al-nafisah/wireless-seismic-daq/analysis/figures/full-chain-nyquist.jpg

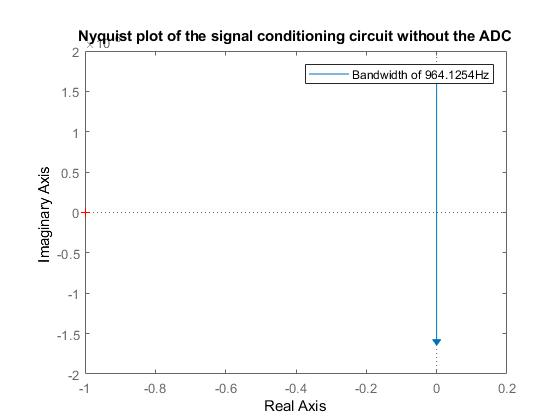
analysis/figures/full-chain-nyquist.jpg
