al-nafisah/wireless-seismic-daq/analysis/figures/hpf-nyquist.jpg

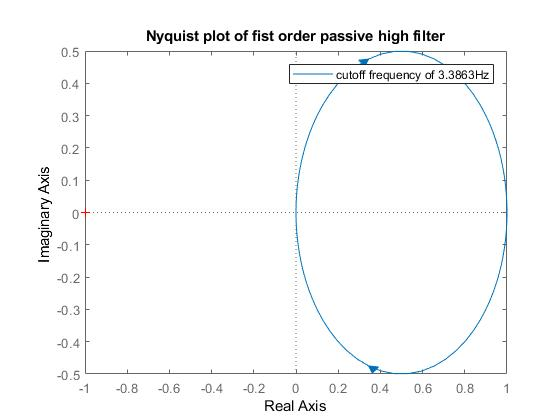
analysis/figures/hpf-nyquist.jpg
