al-nafisah/wireless-seismic-daq/analysis/figures/lpf-bode.jpg

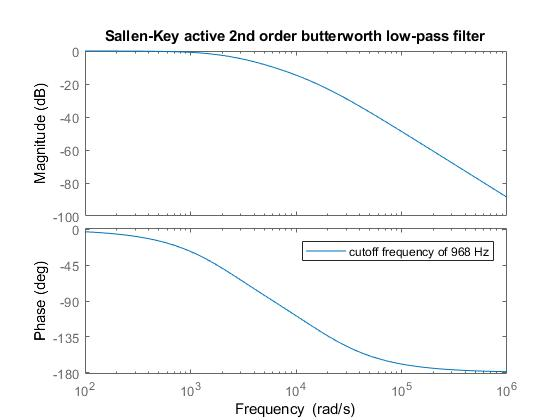
analysis/figures/lpf-bode.jpg
