al-nafisah/wireless-seismic-daq/analysis/figures/lpf-nyquist.jpg

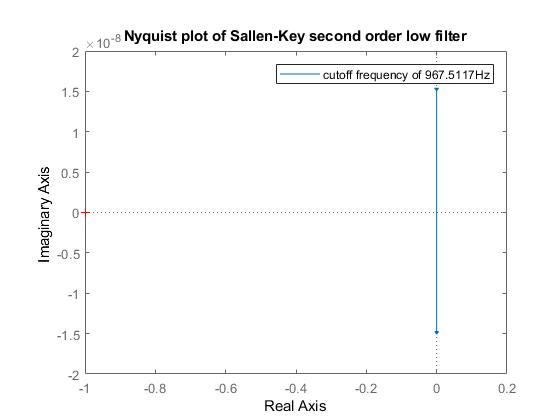
analysis/figures/lpf-nyquist.jpg
