al-nafisah/wireless-seismic-daq/data/hammer-shots/figures/shot1.png

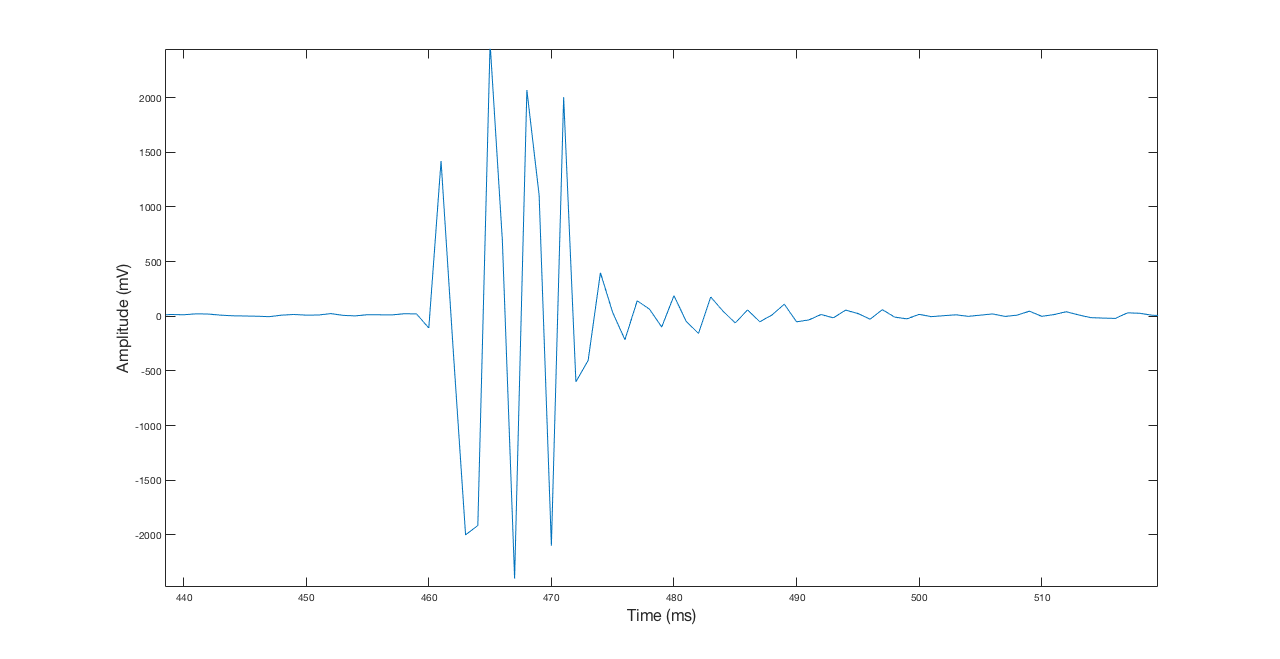
data/hammer-shots/figures/shot1.png
