al-nafisah/wireless-seismic-daq/data/hammer-shots/figures/shot3.png

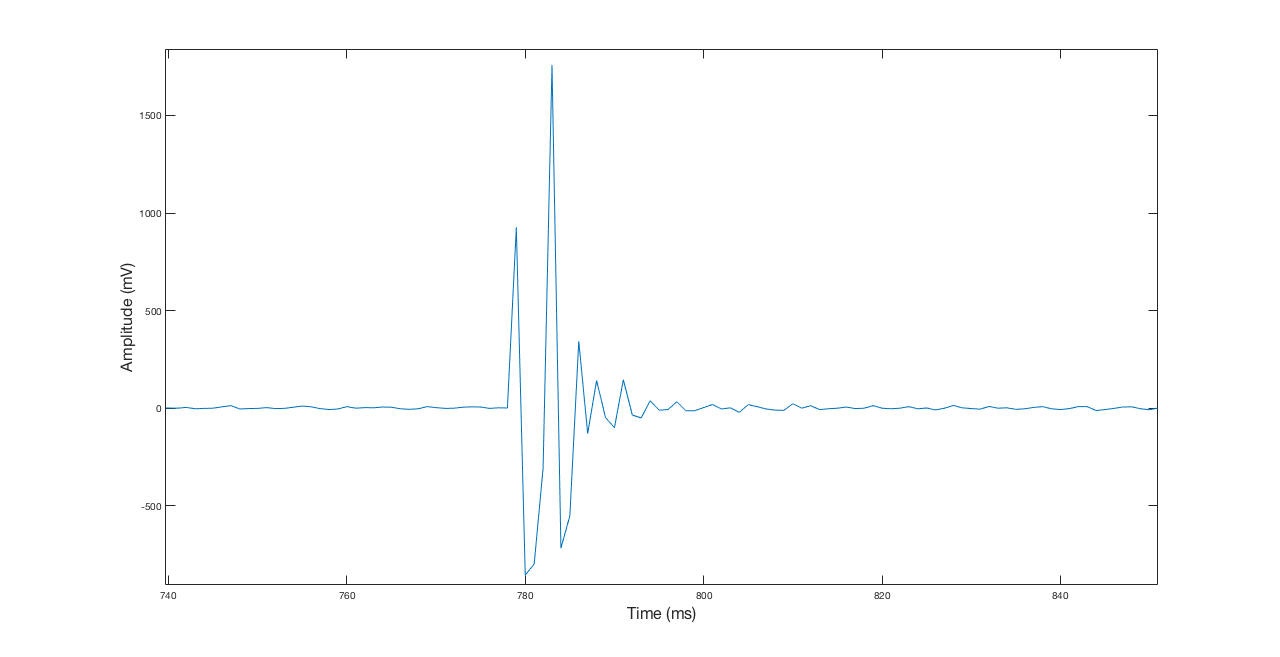
data/hammer-shots/figures/shot3.png
