al-nafisah/wireless-seismic-daq/data/hammer-shots/figures/shot4.png

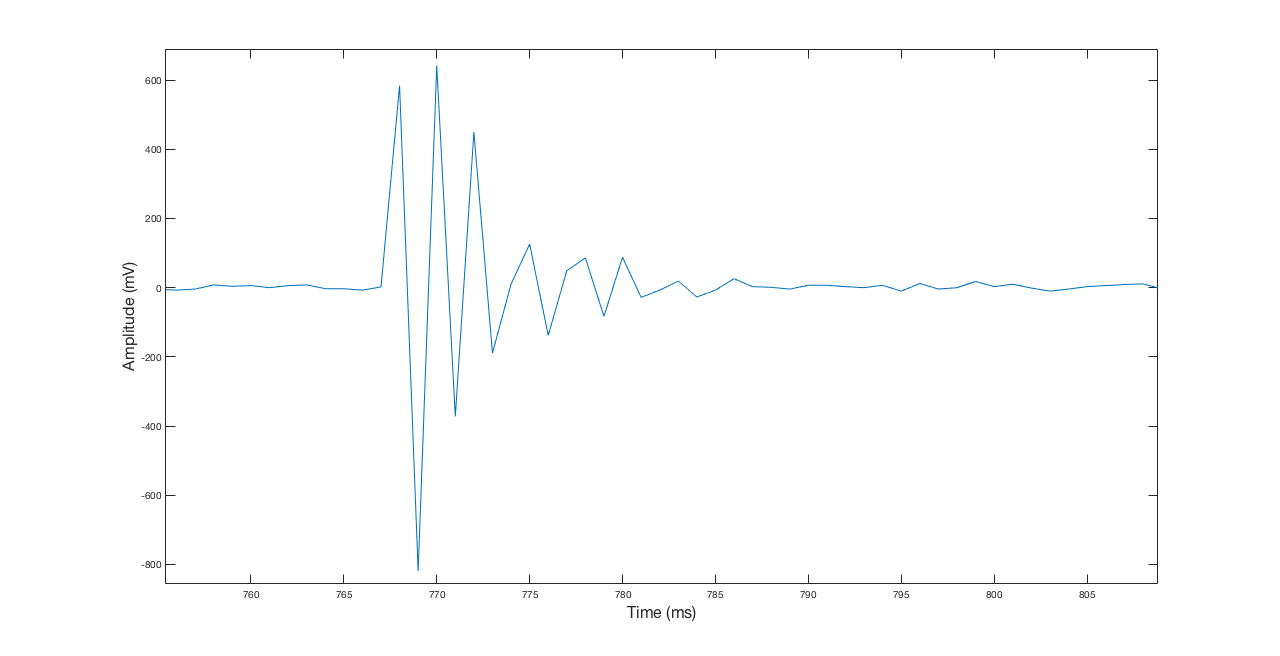
data/hammer-shots/figures/shot4.png
