al-nafisah/wireless-seismic-daq/data/hammer-shots/figures/shot6.png

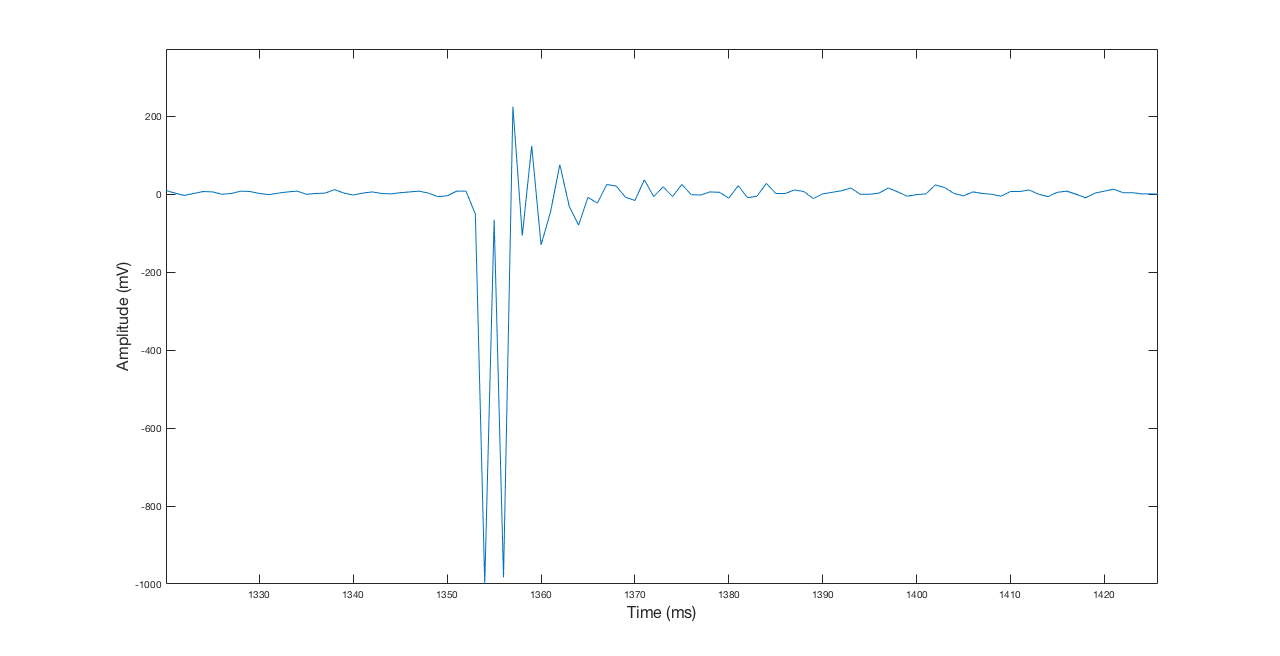
data/hammer-shots/figures/shot6.png
