al-nafisah/wireless-seismic-daq/data/hammer-shots/figures/shot8.png

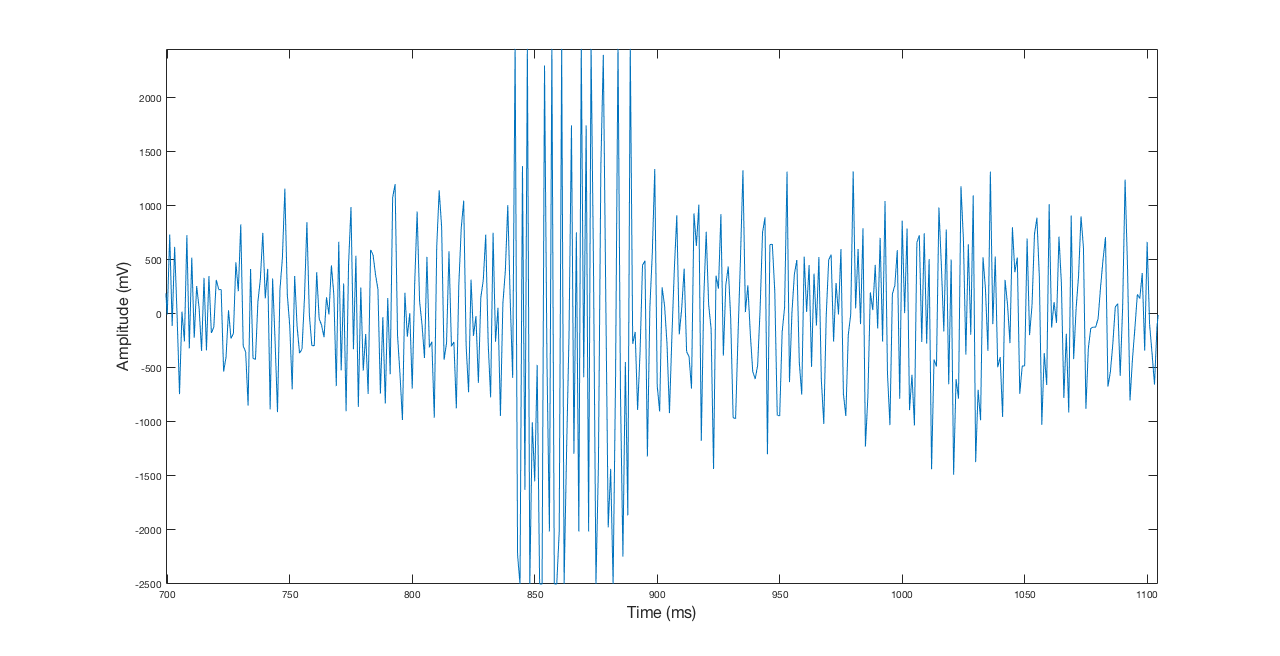
data/hammer-shots/figures/shot8.png
