al-nafisah/wireless-seismic-daq/data/hammer-shots/figures/shot9.png

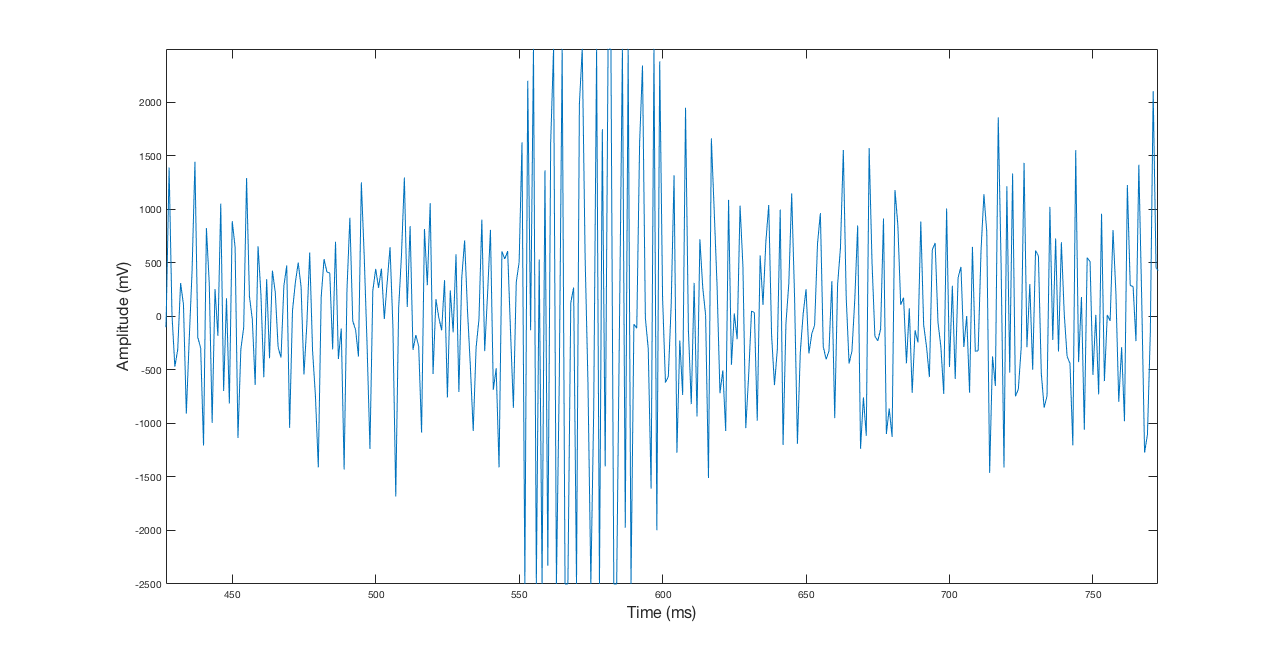
data/hammer-shots/figures/shot9.png
