al-nafisah/wireless-seismic-daq/data/hammer-shots/reference/54.jpg

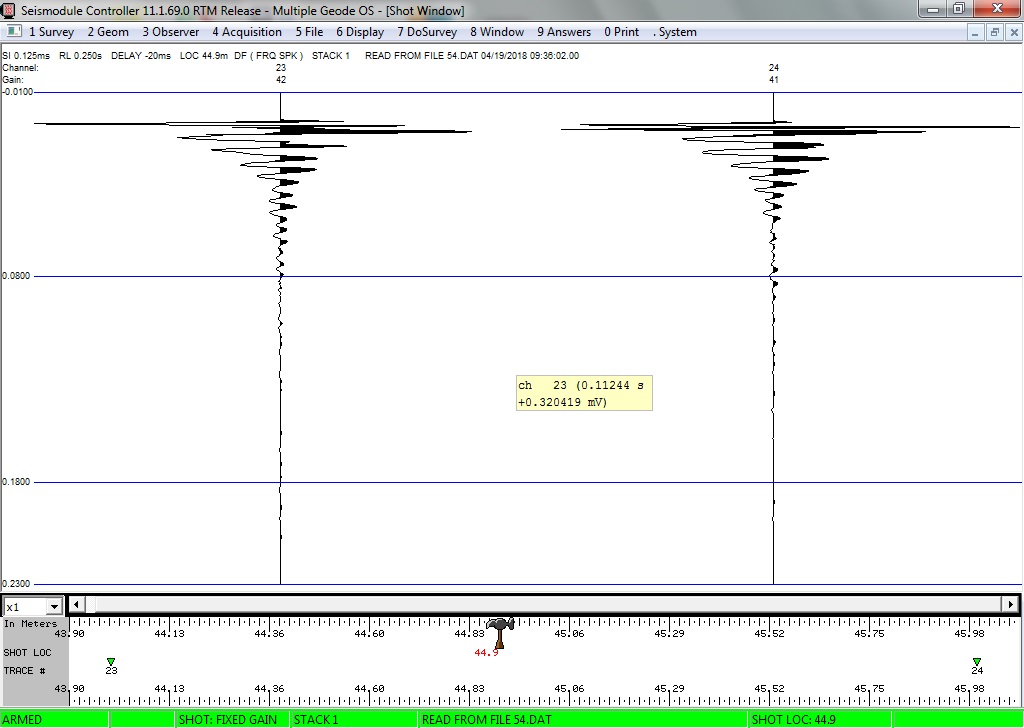
data/hammer-shots/reference/54.jpg
