al-nafisah/wireless-seismic-daq/data/hammer-shots/reference/55.jpg

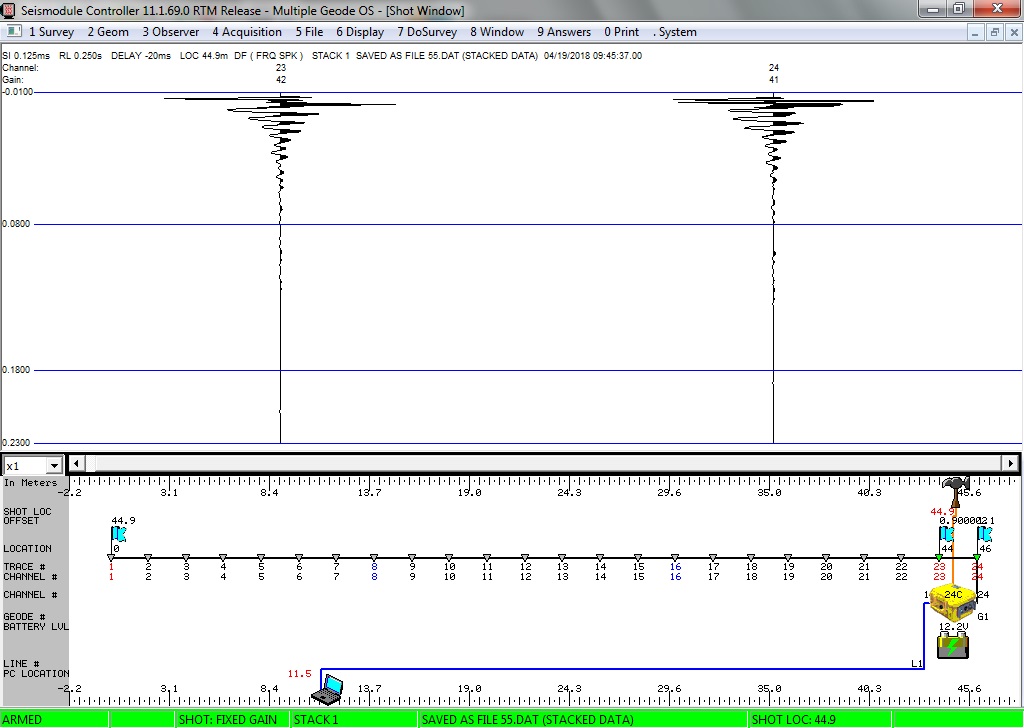
data/hammer-shots/reference/55.jpg
