al-nafisah/wireless-seismic-daq/data/hammer-shots/reference/62.jpg

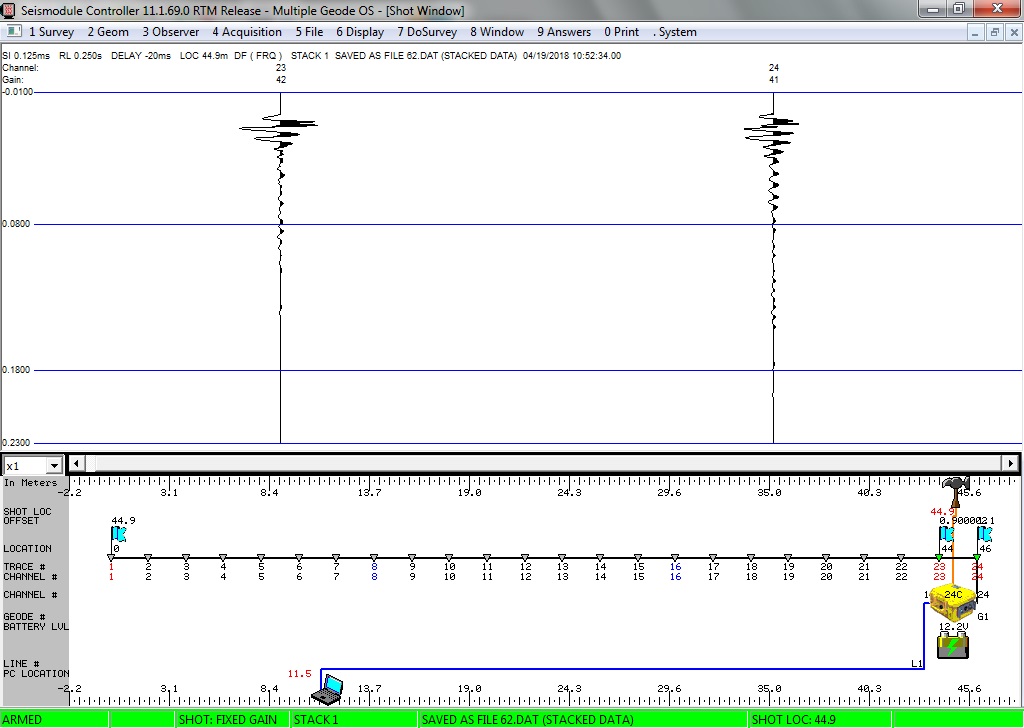
data/hammer-shots/reference/62.jpg
