al-nafisah/wireless-seismic-daq/data/sensor-impulse/geophone.png

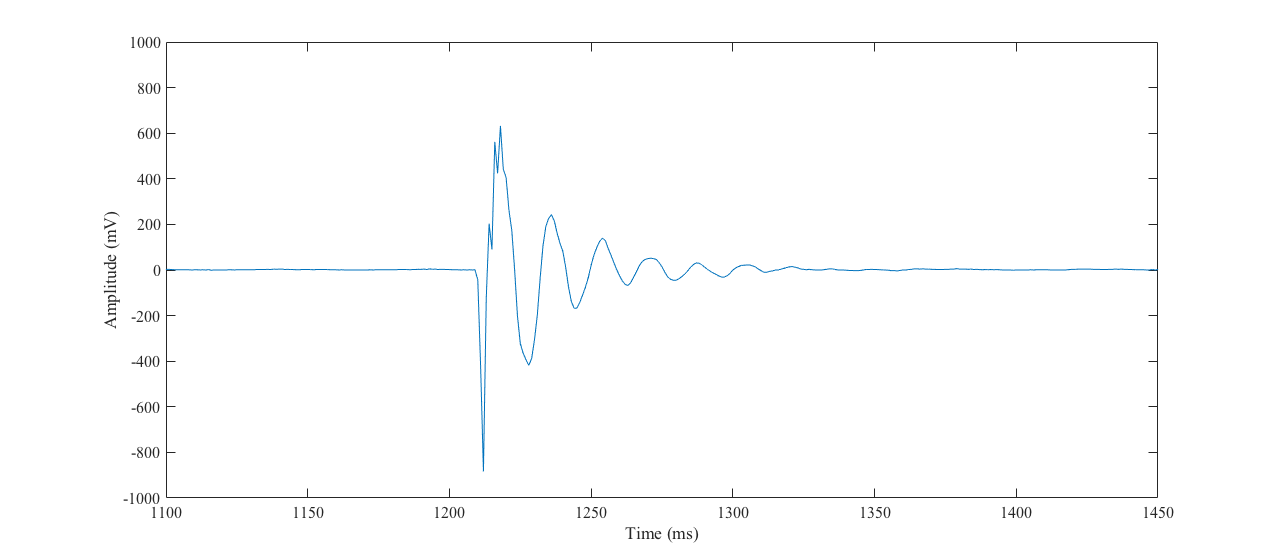
data/sensor-impulse/geophone.png
