al-nafisah/wireless-seismic-daq/data/sensor-impulse/piezo.png

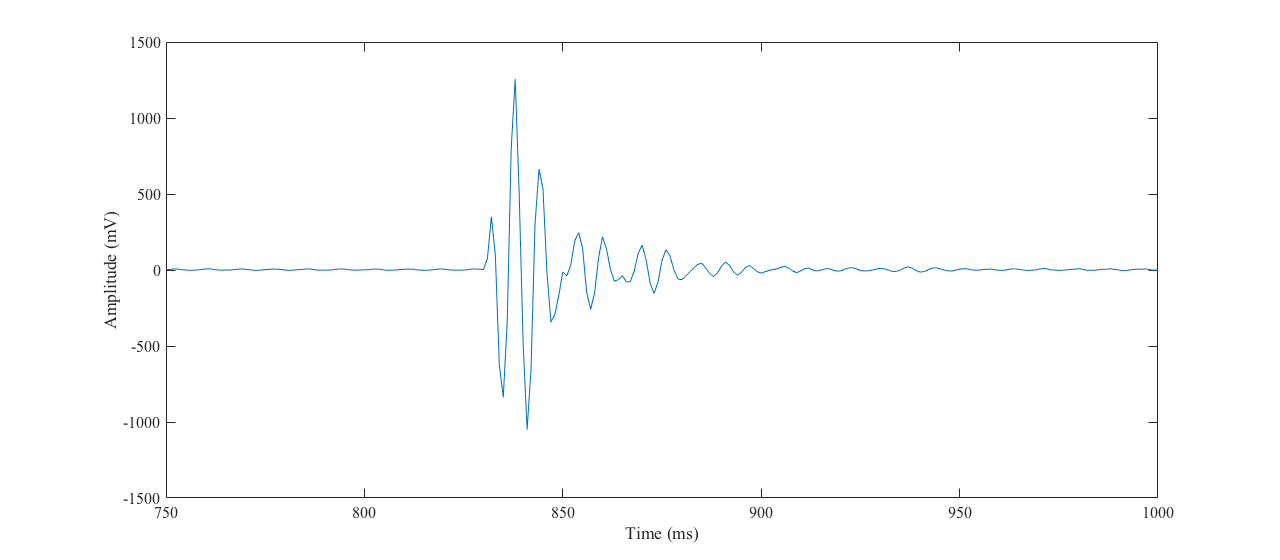
data/sensor-impulse/piezo.png
