al-nafisah/wireless-seismic-daq/hardware/adc-connections.png

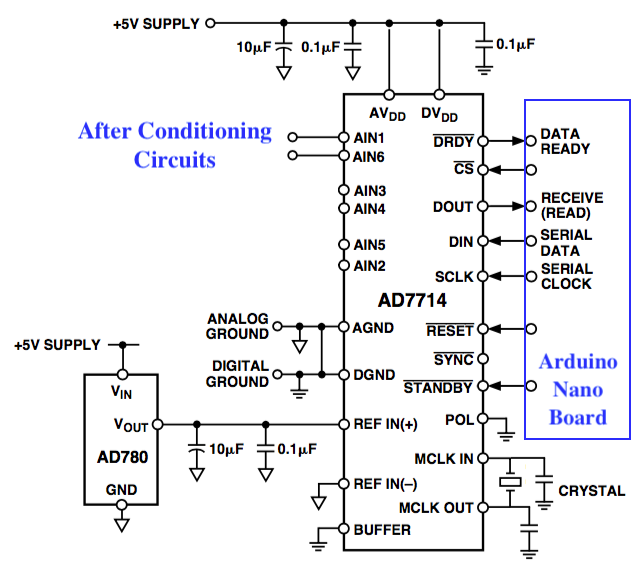
hardware/adc-connections.png
