al-nafisah/wireless-seismic-daq/hardware/pcb/layout-bottom.jpg

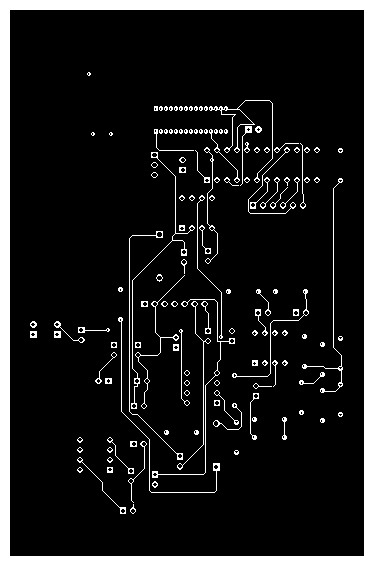
hardware/pcb/layout-bottom.jpg
