al-nafisah/wireless-seismic-daq/hardware/pcb/layout-top.jpg

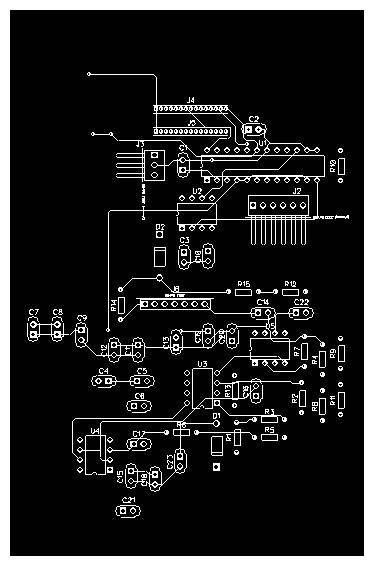
hardware/pcb/layout-top.jpg
