al-nafisah/wireless-seismic-daq/hardware/pcb/power-supply.jpg

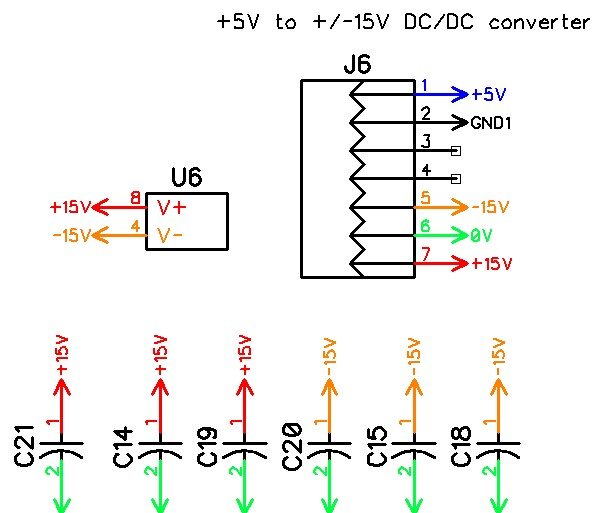
hardware/pcb/power-supply.jpg
