al-nafisah/wireless-seismic-daq/hardware/pcb/schematic.jpg

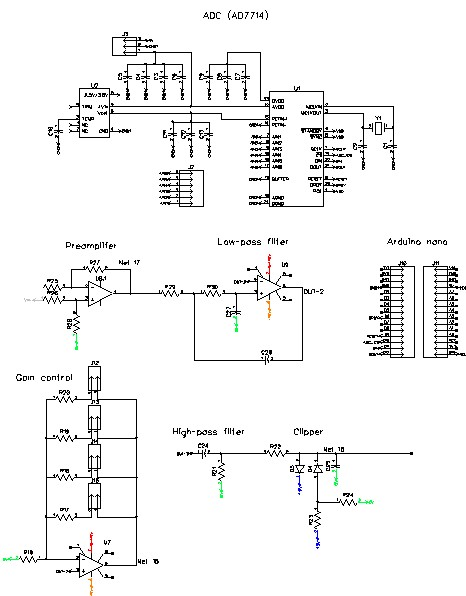
hardware/pcb/schematic.jpg
