al-nafisah/wireless-seismic-daq/hardware/signal-conditioning/stages.png

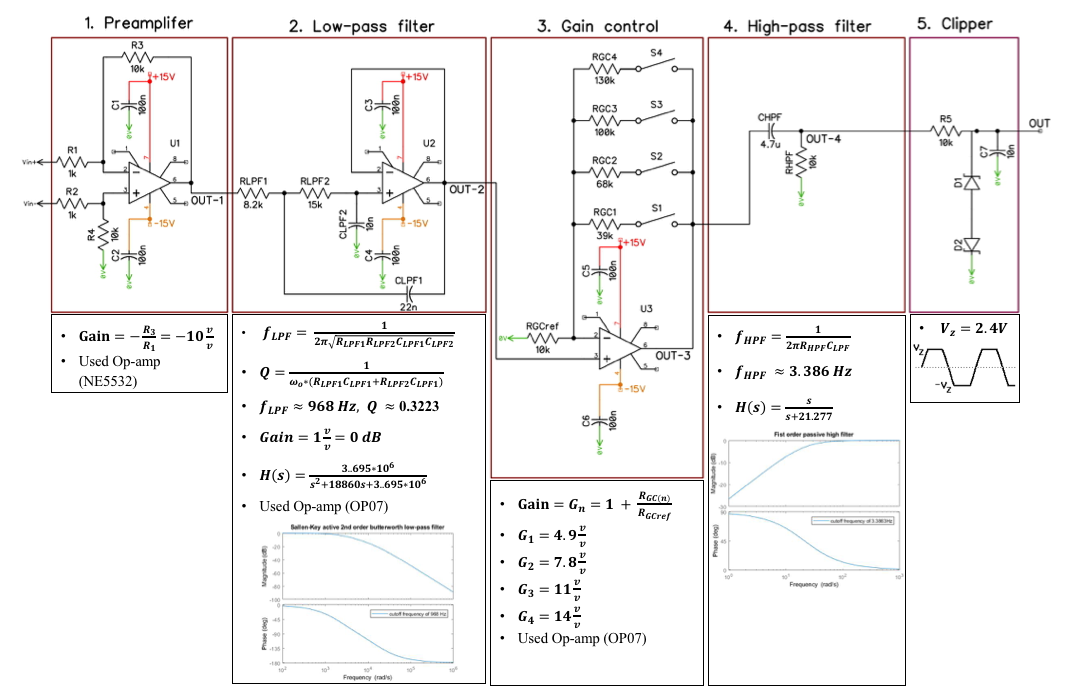
hardware/signal-conditioning/stages.png
