al-nafisah/wireless-seismic-daq/media/photos/award-1.jpg

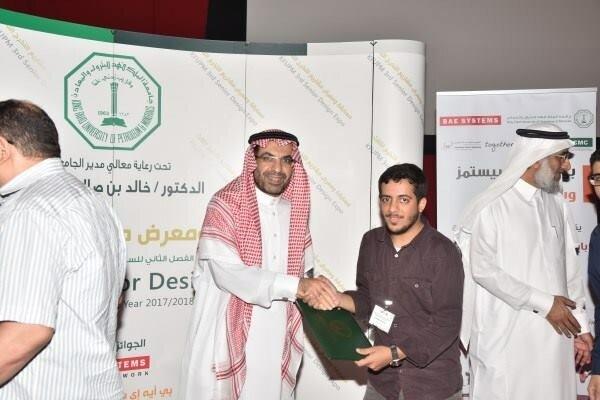
media/photos/award-1.jpg
