al-nafisah/wireless-seismic-daq/media/photos/award-2.jpg

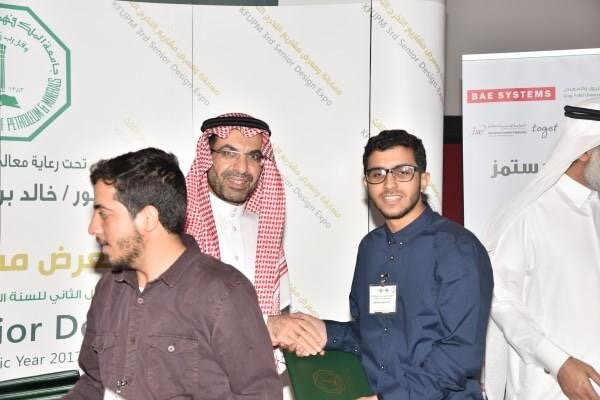
media/photos/award-2.jpg
