al-nafisah/wireless-seismic-daq/media/photos/award-3.jpg

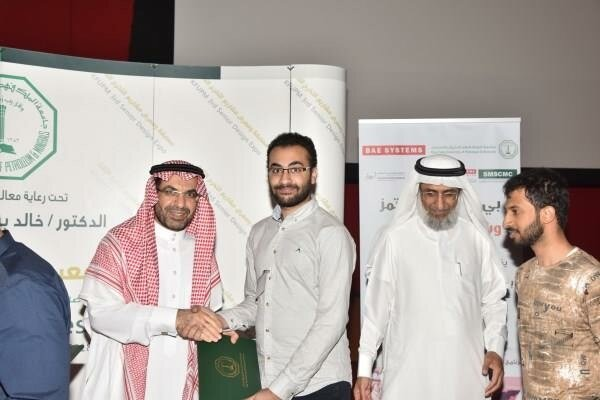
media/photos/award-3.jpg
