al-nafisah/wireless-seismic-daq/media/photos/award-4.jpg

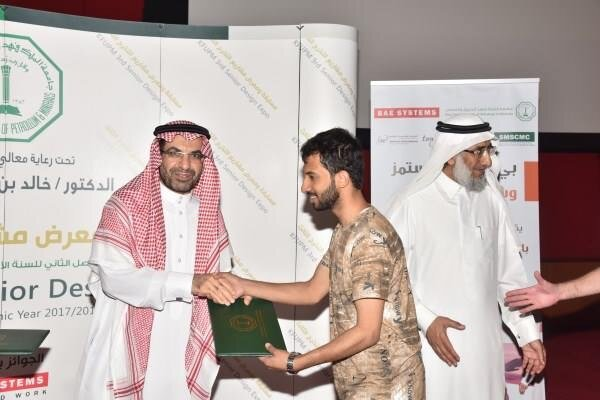
media/photos/award-4.jpg
