al-nafisah/wireless-seismic-daq/media/photos/award-5.jpg

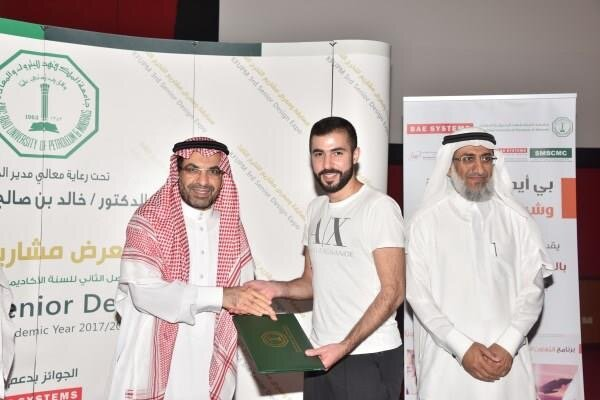
media/photos/award-5.jpg
