al-nafisah/wireless-seismic-daq/media/photos/award-6.jpg

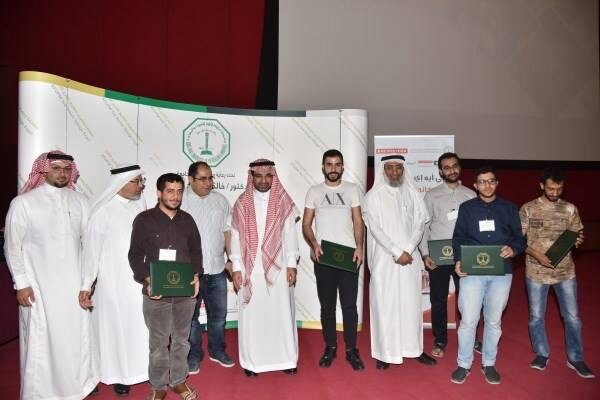
media/photos/award-6.jpg
