al-nafisah/wireless-seismic-daq/media/photos/award-7.jpg

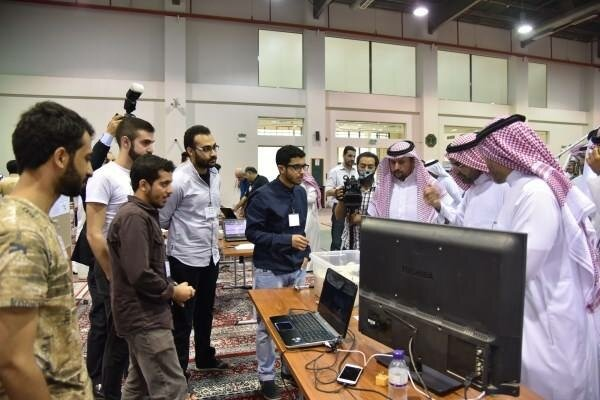
media/photos/award-7.jpg
