al-nafisah/wireless-seismic-daq/media/photos/prototype.jpg

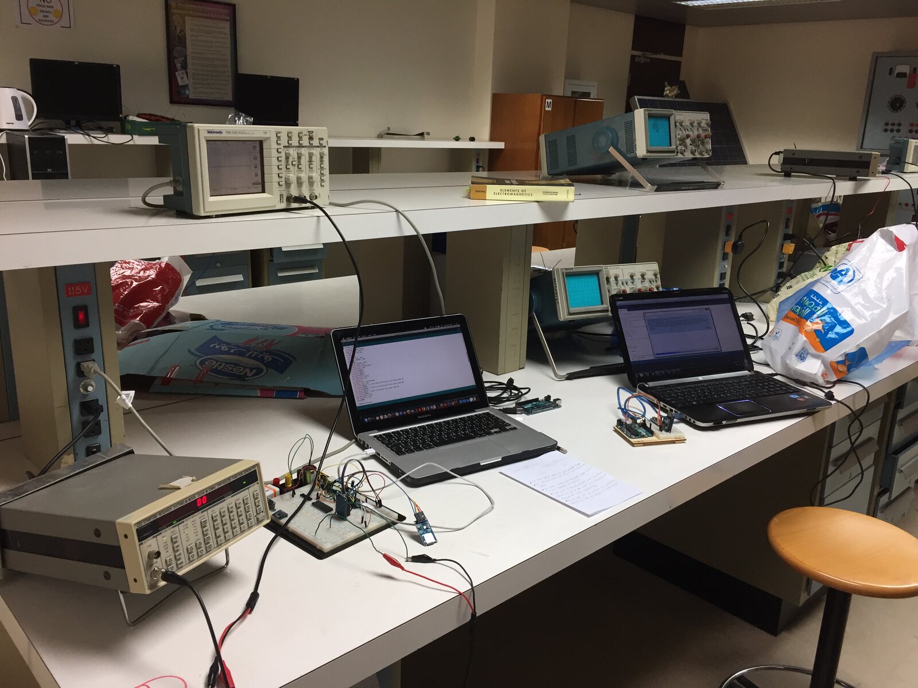
media/photos/prototype.jpg
