al-nafisah/wireless-seismic-daq/hardware/bench-measurements/low-battery/clipper.jpg

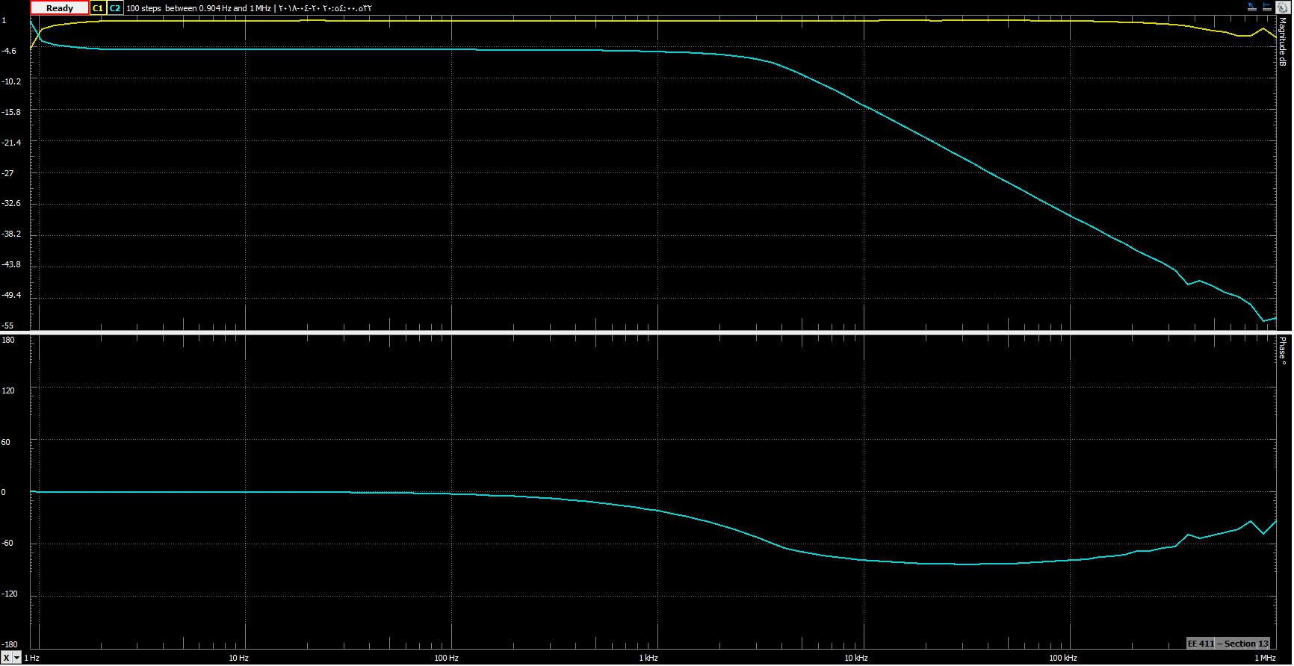
hardware/bench-measurements/low-battery/clipper.jpg
