al-nafisah/wireless-seismic-daq/hardware/bench-measurements/low-battery/full-chain.jpg

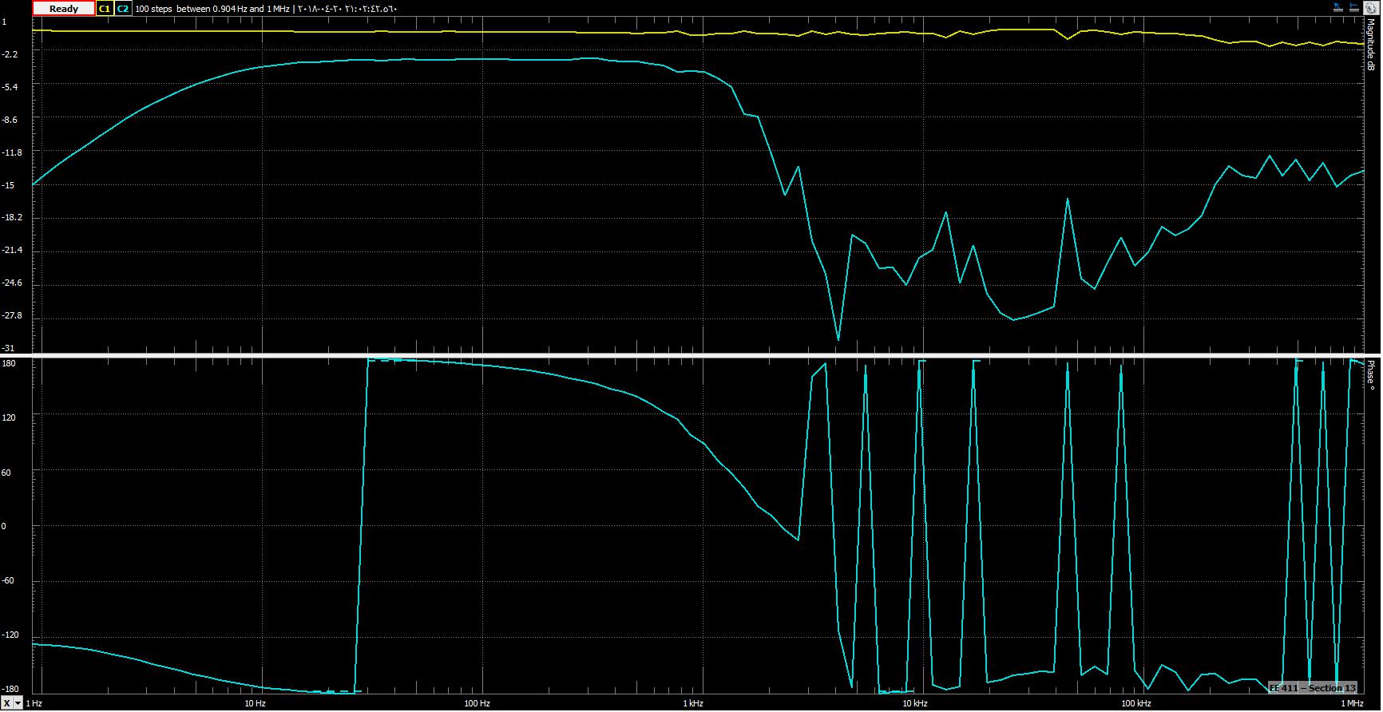
hardware/bench-measurements/low-battery/full-chain.jpg
