al-nafisah/wireless-seismic-daq/hardware/bench-measurements/low-battery/gain-control-1m.jpg

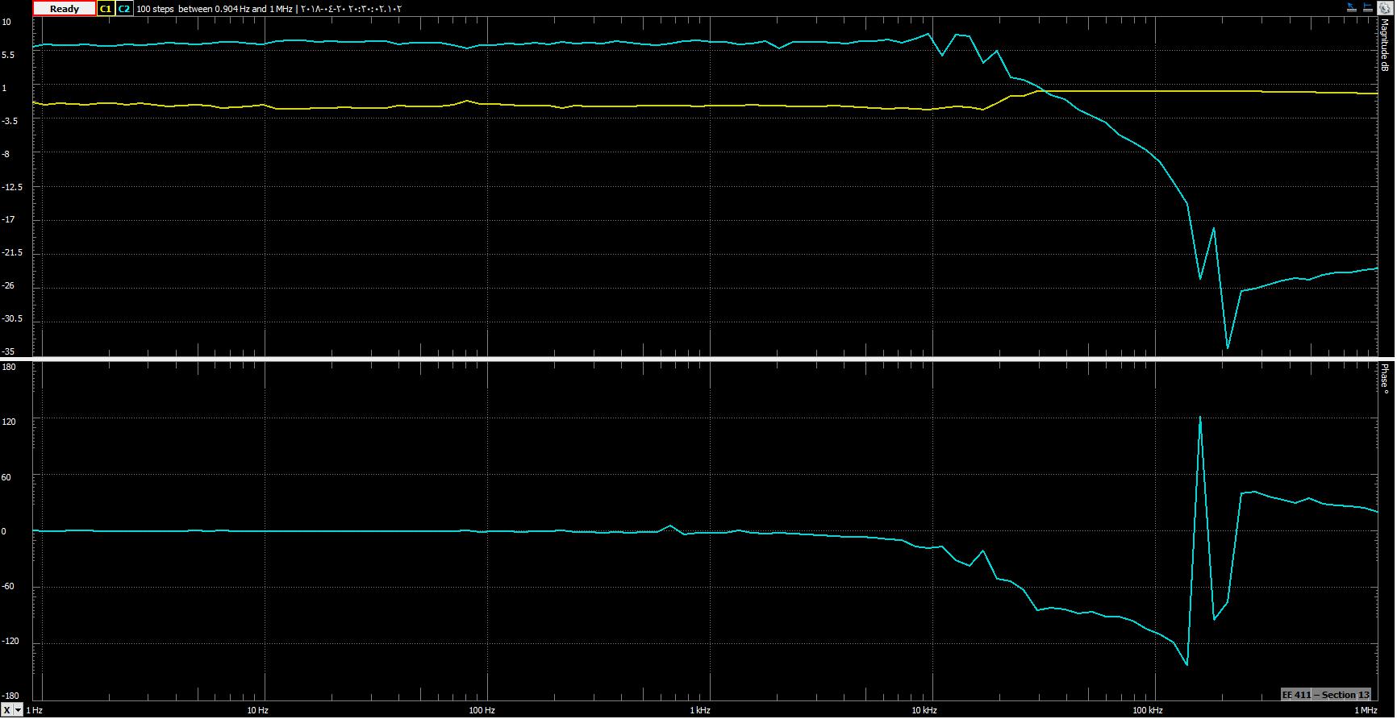
hardware/bench-measurements/low-battery/gain-control-1m.jpg
