al-nafisah/wireless-seismic-daq/hardware/bench-measurements/low-battery/gain-control-2.2m.jpg

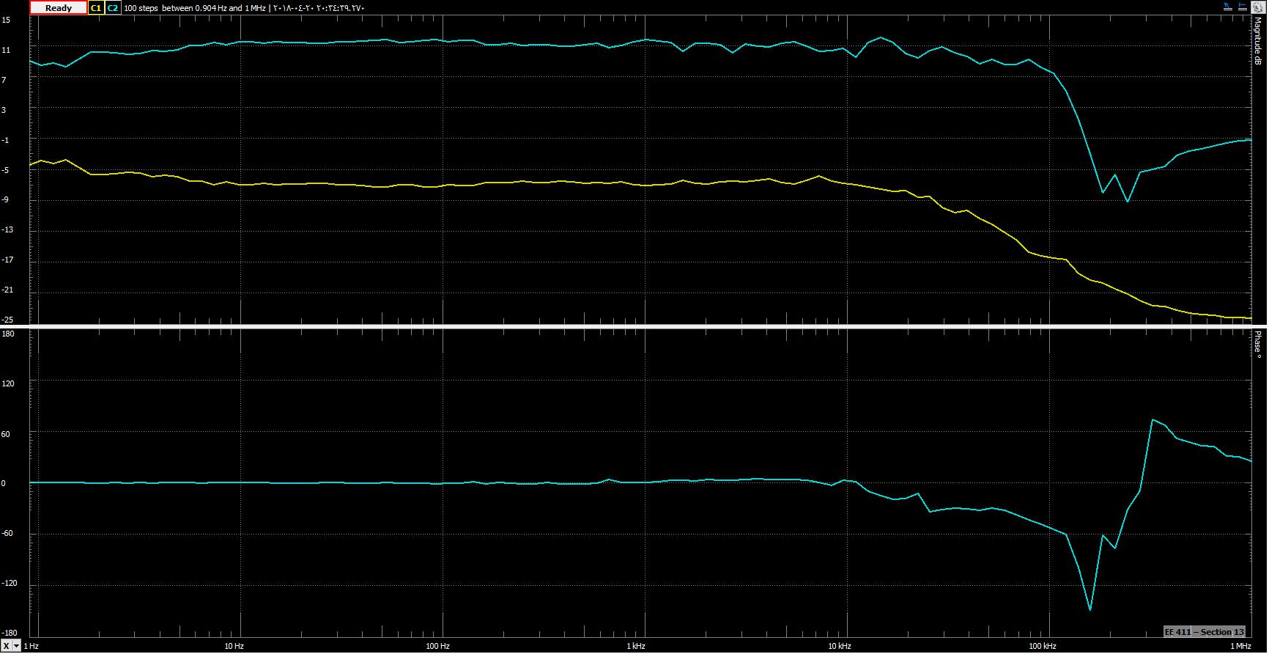
hardware/bench-measurements/low-battery/gain-control-2.2m.jpg
