al-nafisah/wireless-seismic-daq/hardware/bench-measurements/low-battery/gain-control-100k.jpg

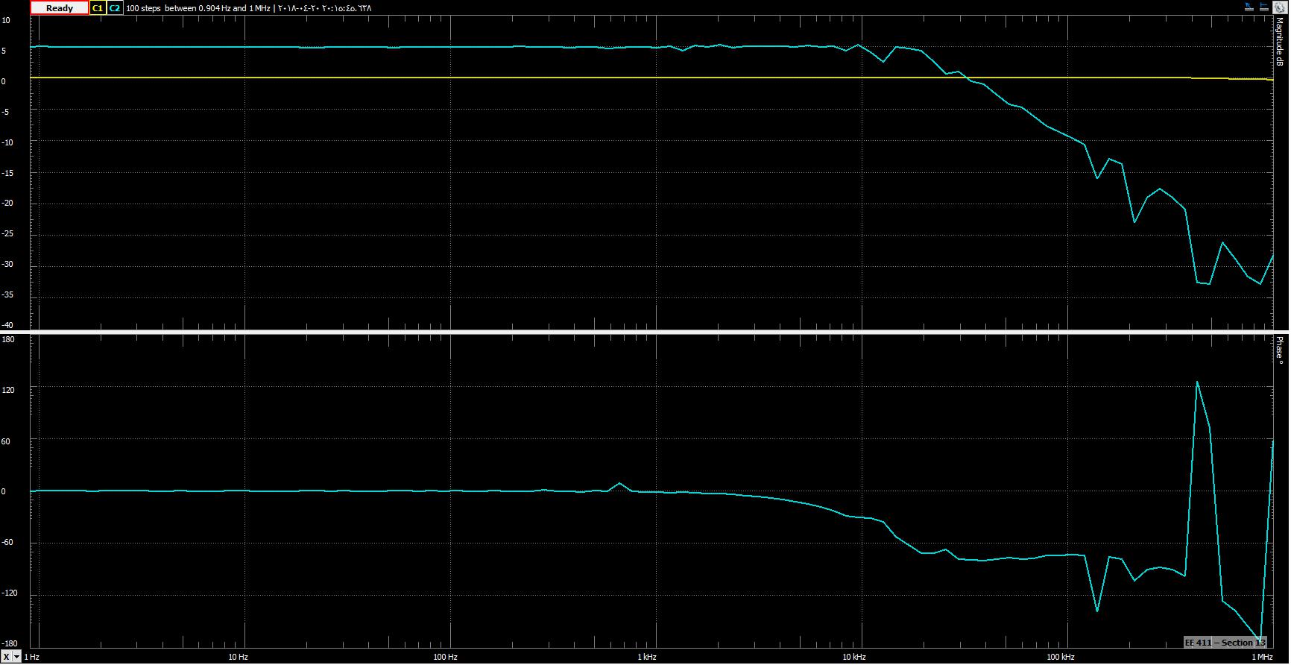
hardware/bench-measurements/low-battery/gain-control-100k.jpg
