al-nafisah/wireless-seismic-daq/hardware/bench-measurements/low-battery/gain-control-680k.jpg

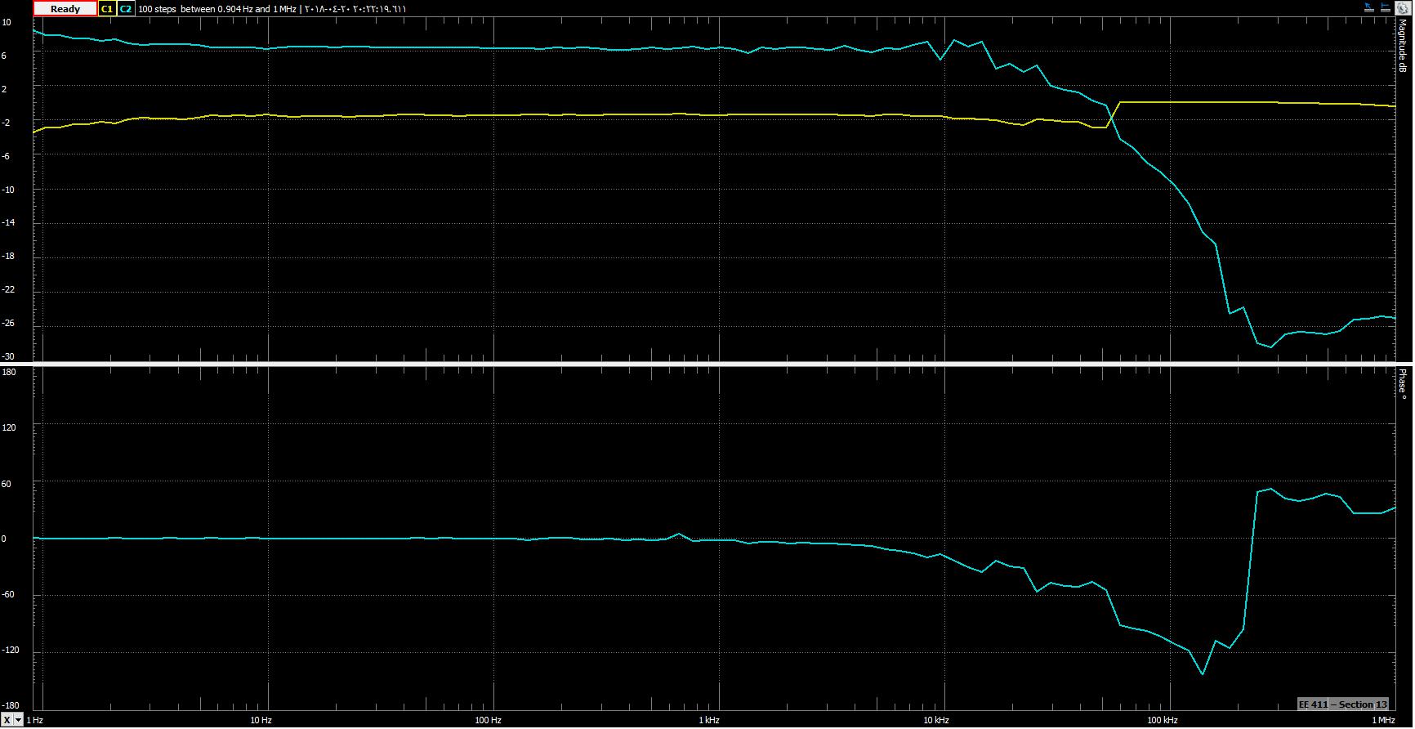
hardware/bench-measurements/low-battery/gain-control-680k.jpg
