al-nafisah/wireless-seismic-daq/hardware/bench-measurements/low-battery/hpf.jpg

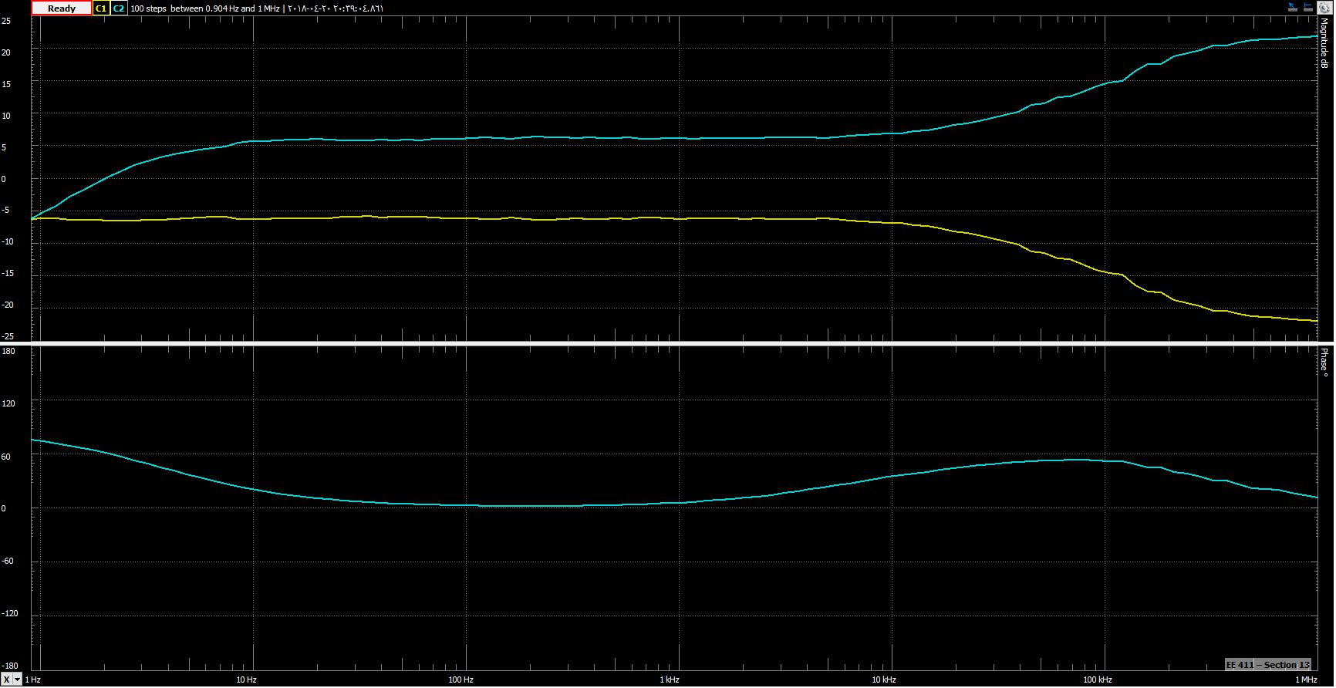
hardware/bench-measurements/low-battery/hpf.jpg
