al-nafisah/wireless-seismic-daq/hardware/bench-measurements/low-battery/lpf.jpg

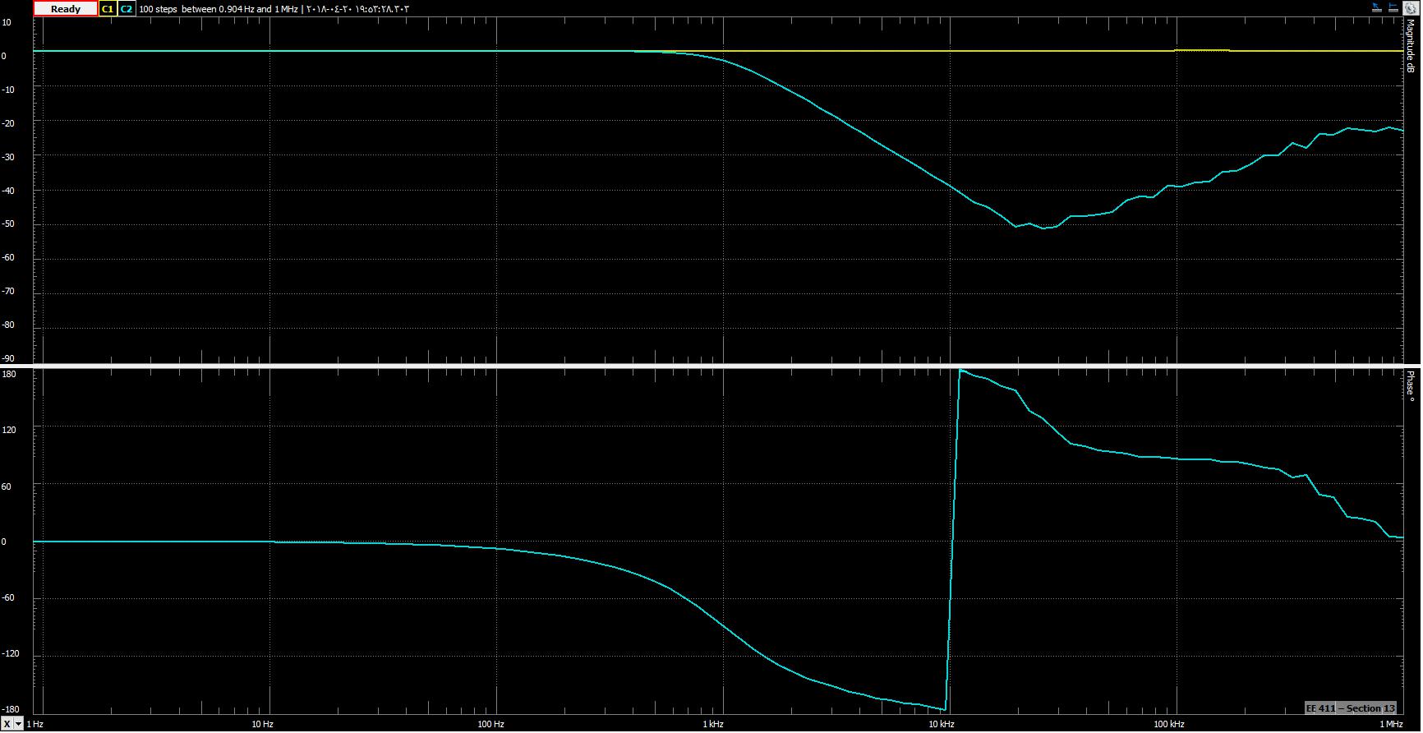
hardware/bench-measurements/low-battery/lpf.jpg
