al-nafisah/wireless-seismic-daq/hardware/bench-measurements/low-battery/preamplifier.jpg

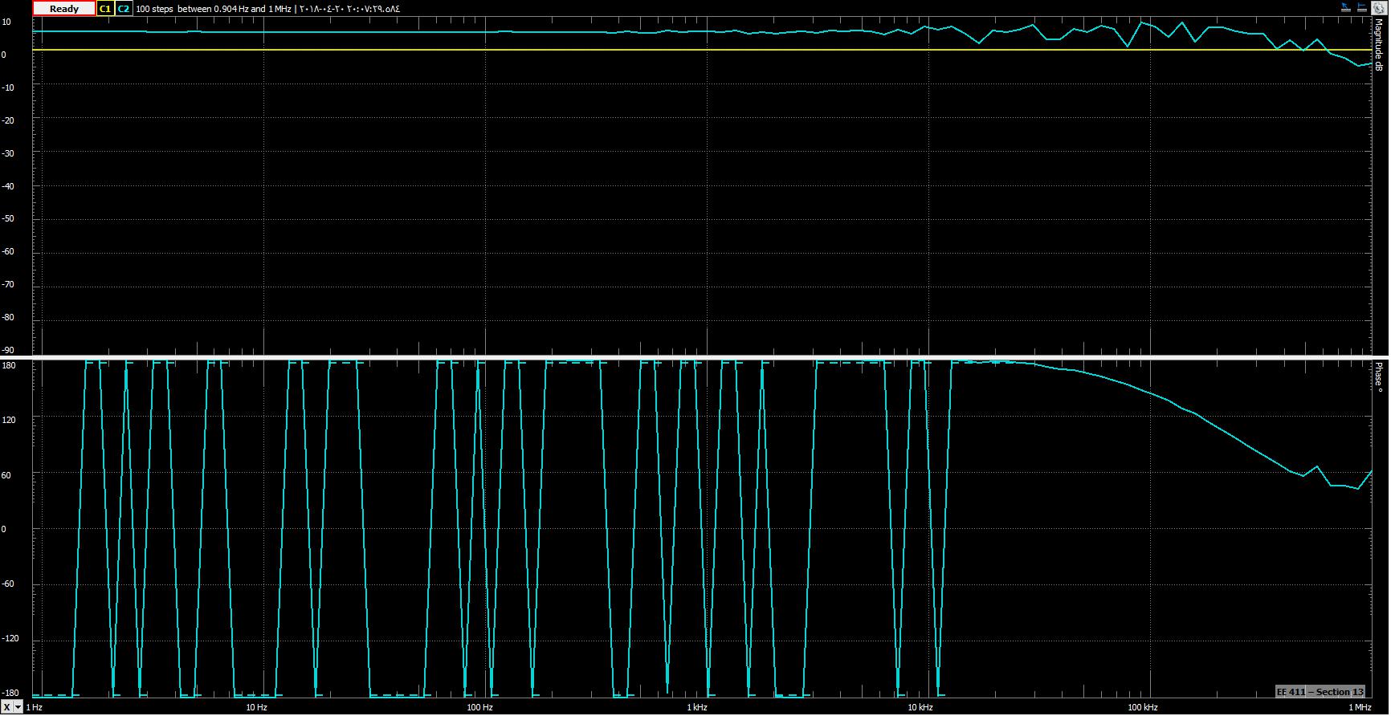
hardware/bench-measurements/low-battery/preamplifier.jpg
