al-nafisah/wireless-seismic-daq/hardware/bench-measurements/normal/clipper.jpg

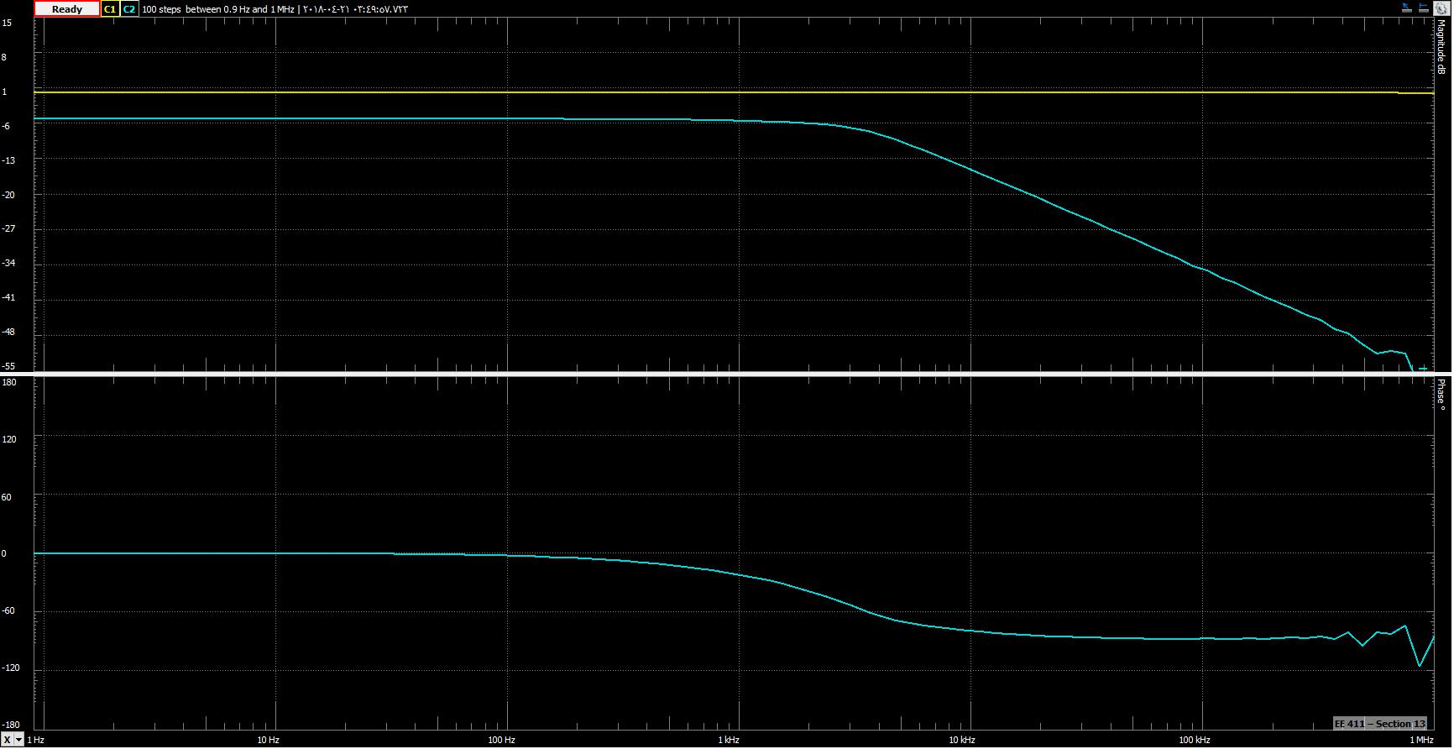
hardware/bench-measurements/normal/clipper.jpg
