al-nafisah/wireless-seismic-daq/hardware/bench-measurements/normal/full-chain.jpg

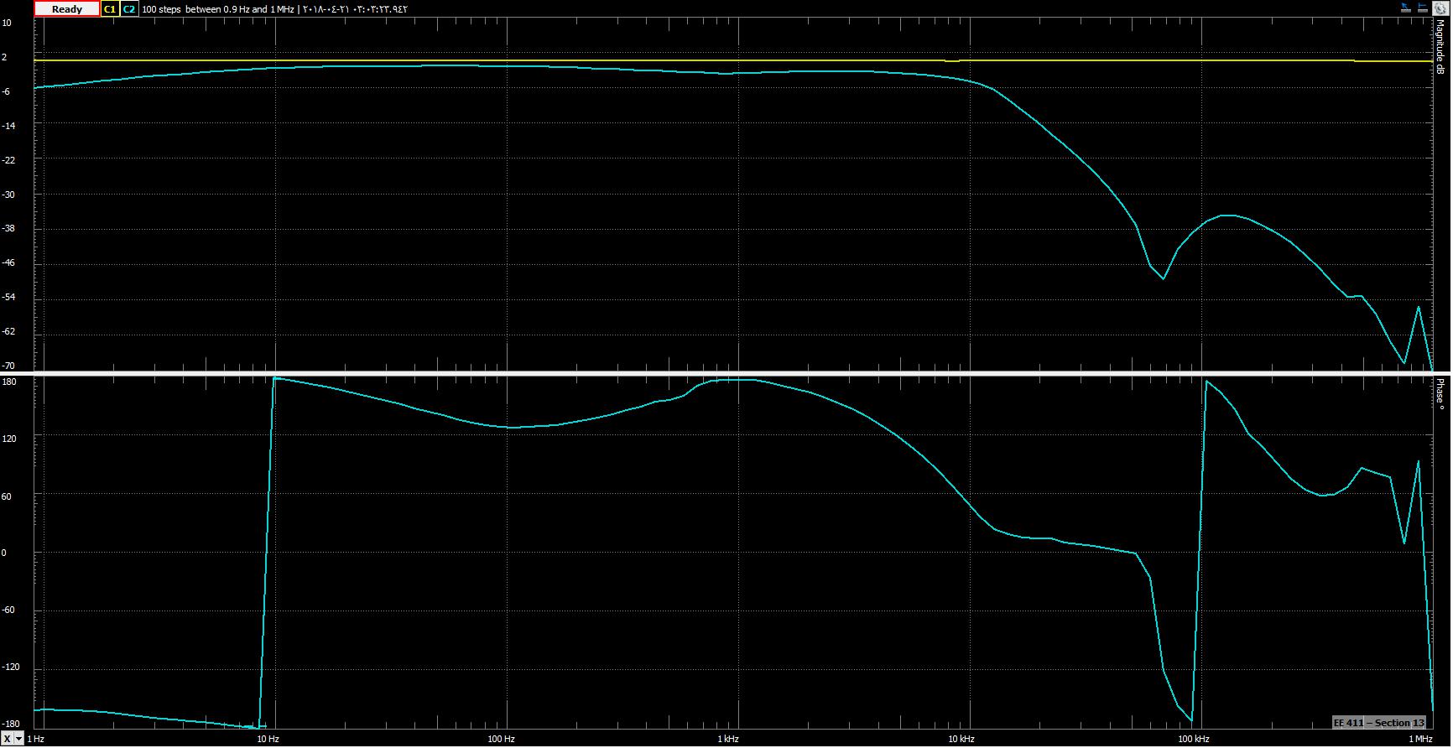
hardware/bench-measurements/normal/full-chain.jpg
