al-nafisah/wireless-seismic-daq/hardware/bench-measurements/normal/gain-control-1m.jpg

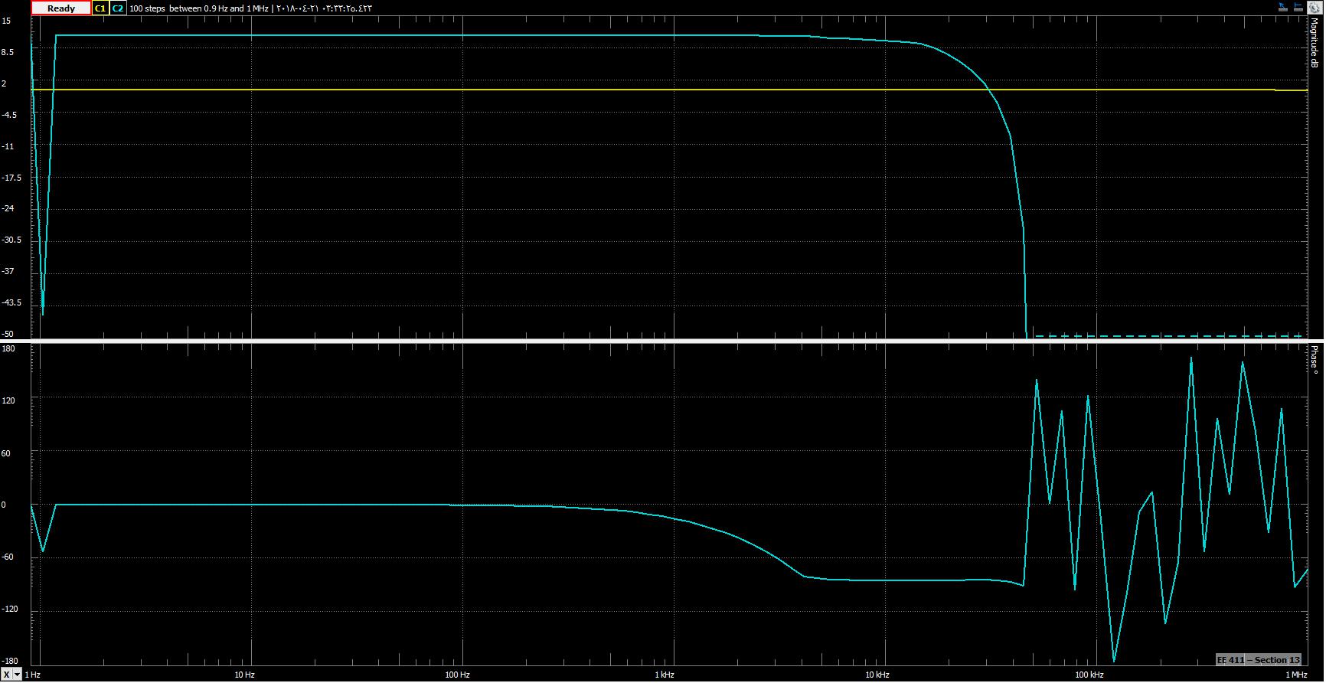
hardware/bench-measurements/normal/gain-control-1m.jpg
