al-nafisah/wireless-seismic-daq/hardware/bench-measurements/normal/gain-control-2.2m.jpg

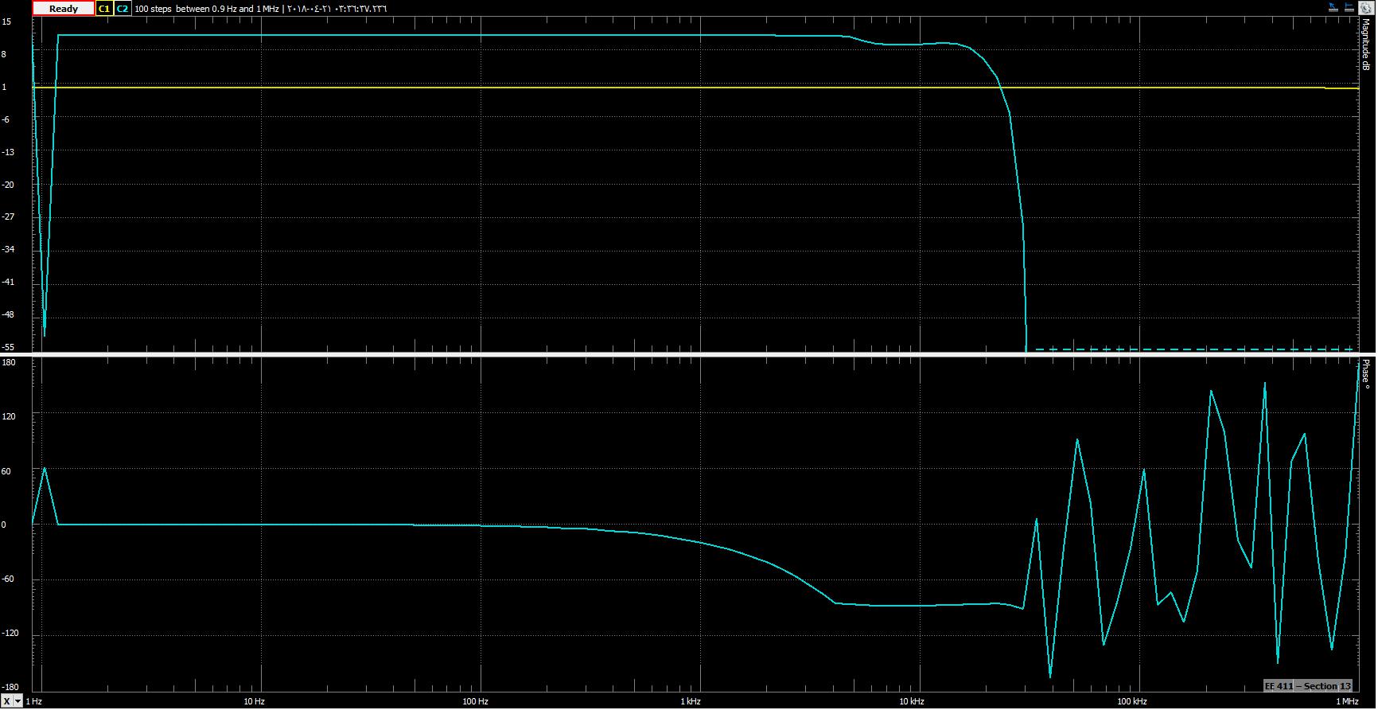
hardware/bench-measurements/normal/gain-control-2.2m.jpg
