al-nafisah/wireless-seismic-daq/hardware/bench-measurements/normal/gain-control-100k.jpg

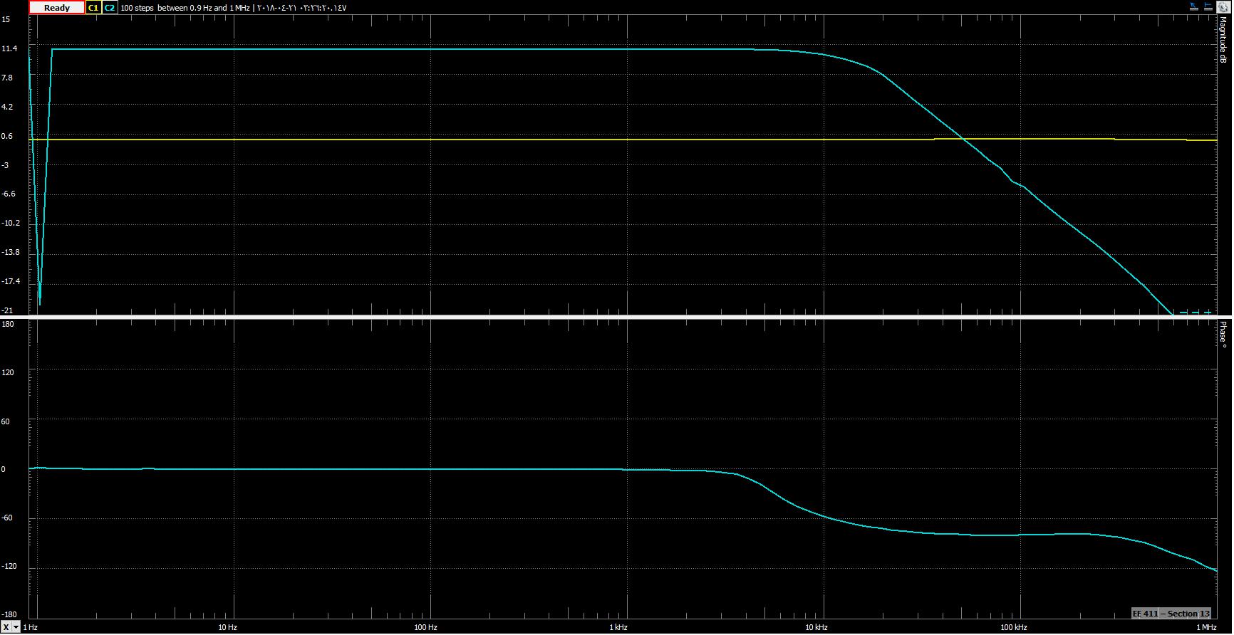
hardware/bench-measurements/normal/gain-control-100k.jpg
