al-nafisah/wireless-seismic-daq/hardware/bench-measurements/normal/gain-control-680k.jpg

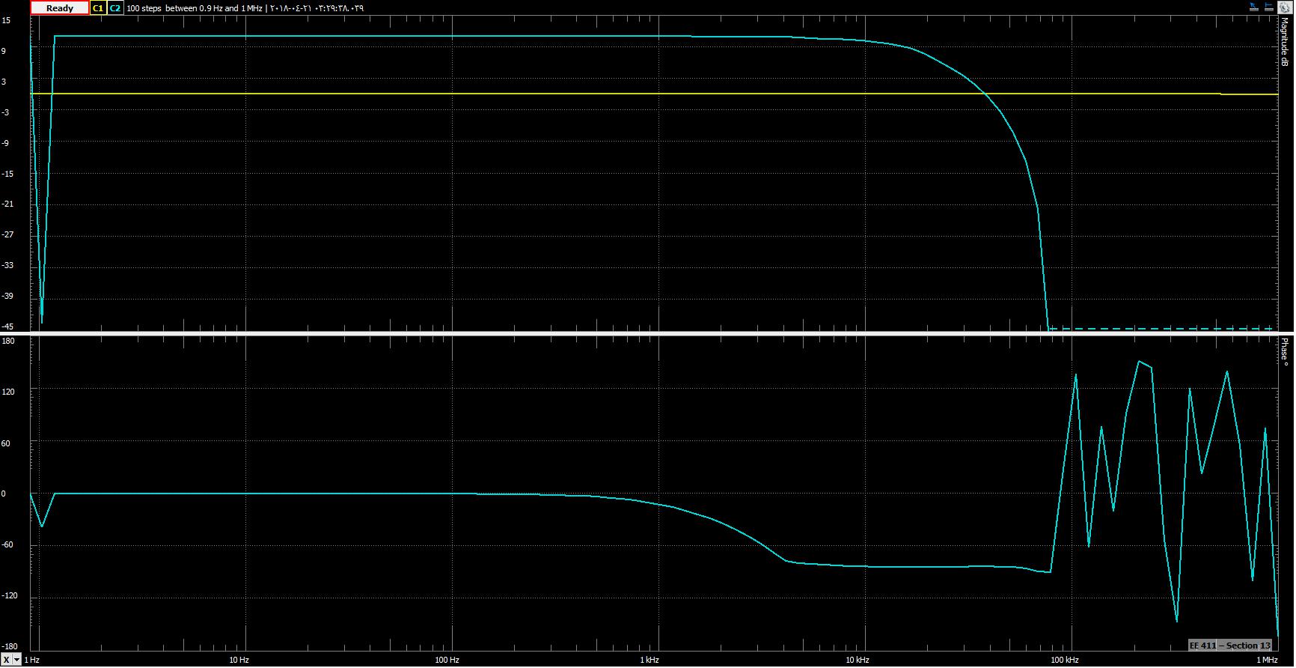
hardware/bench-measurements/normal/gain-control-680k.jpg
