al-nafisah/wireless-seismic-daq/hardware/bench-measurements/normal/hpf.jpg

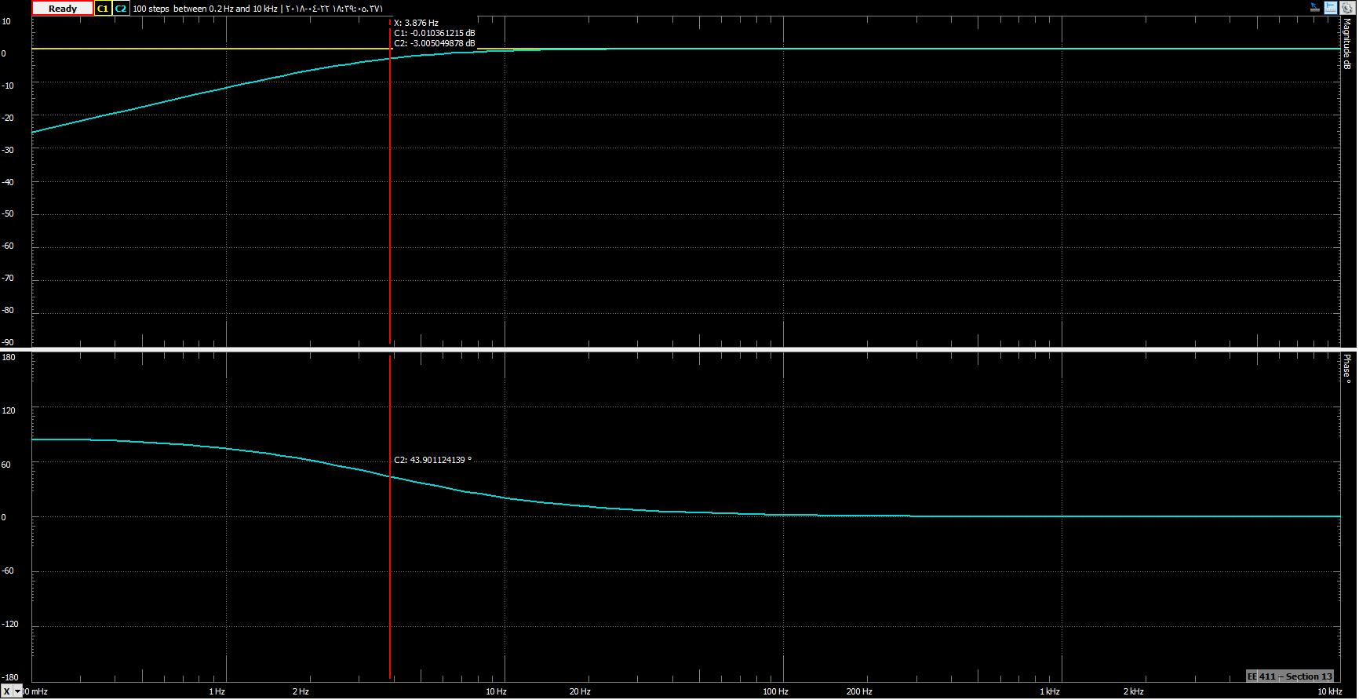
hardware/bench-measurements/normal/hpf.jpg
