al-nafisah/wireless-seismic-daq/hardware/bench-measurements/normal/lpf-2.png

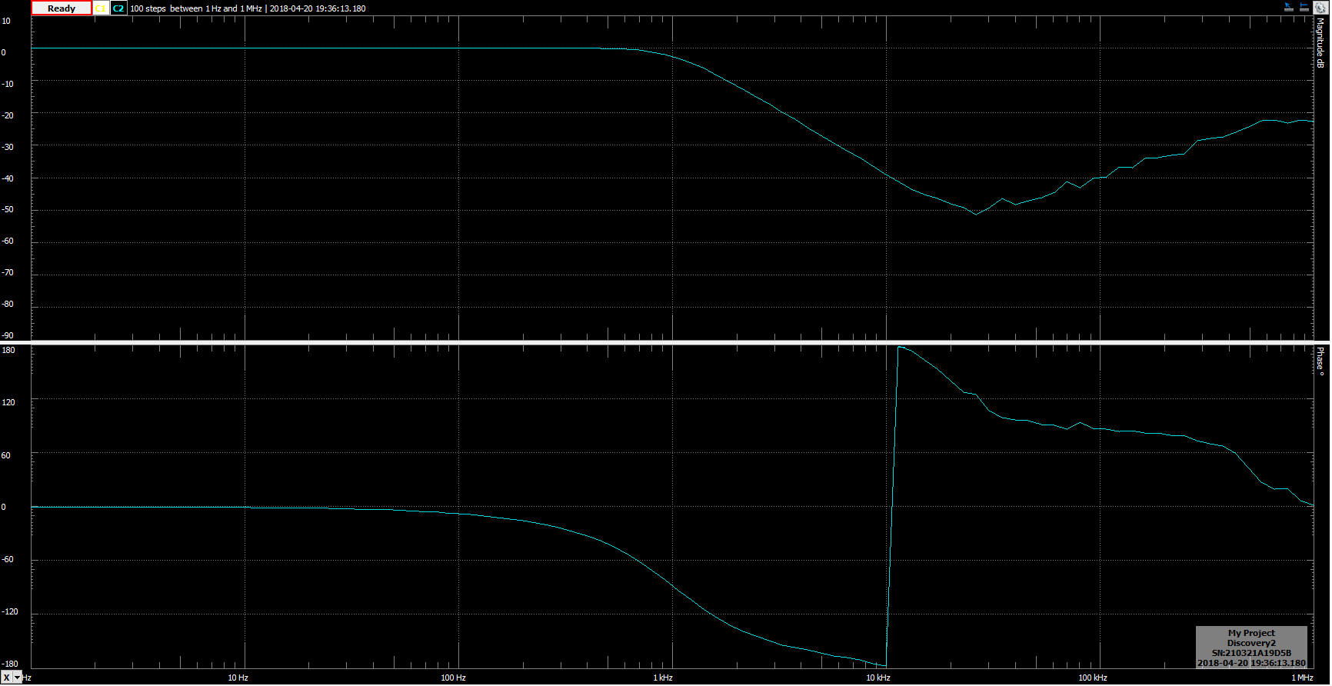
hardware/bench-measurements/normal/lpf-2.png
