al-nafisah/wireless-seismic-daq/hardware/bench-measurements/normal/lpf.jpg

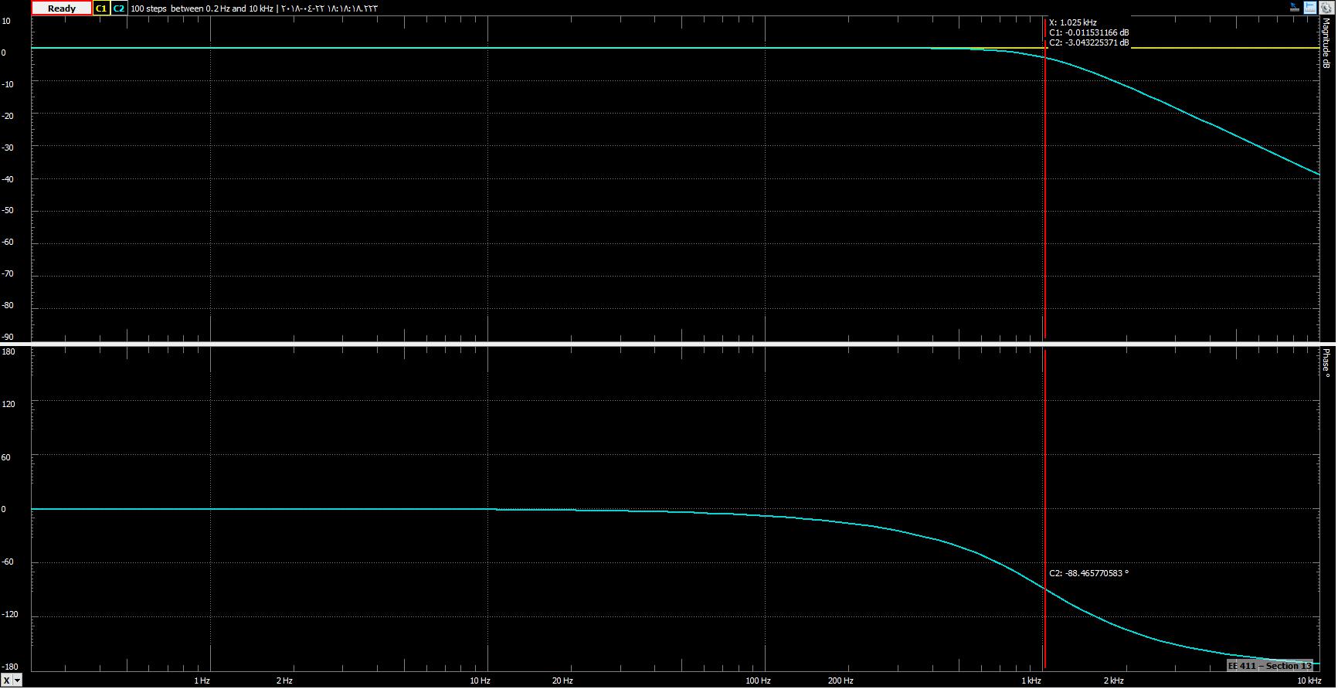
hardware/bench-measurements/normal/lpf.jpg
