al-nafisah/wireless-seismic-daq/hardware/bench-measurements/normal/preamplifier-differential-with-clipper.jpg

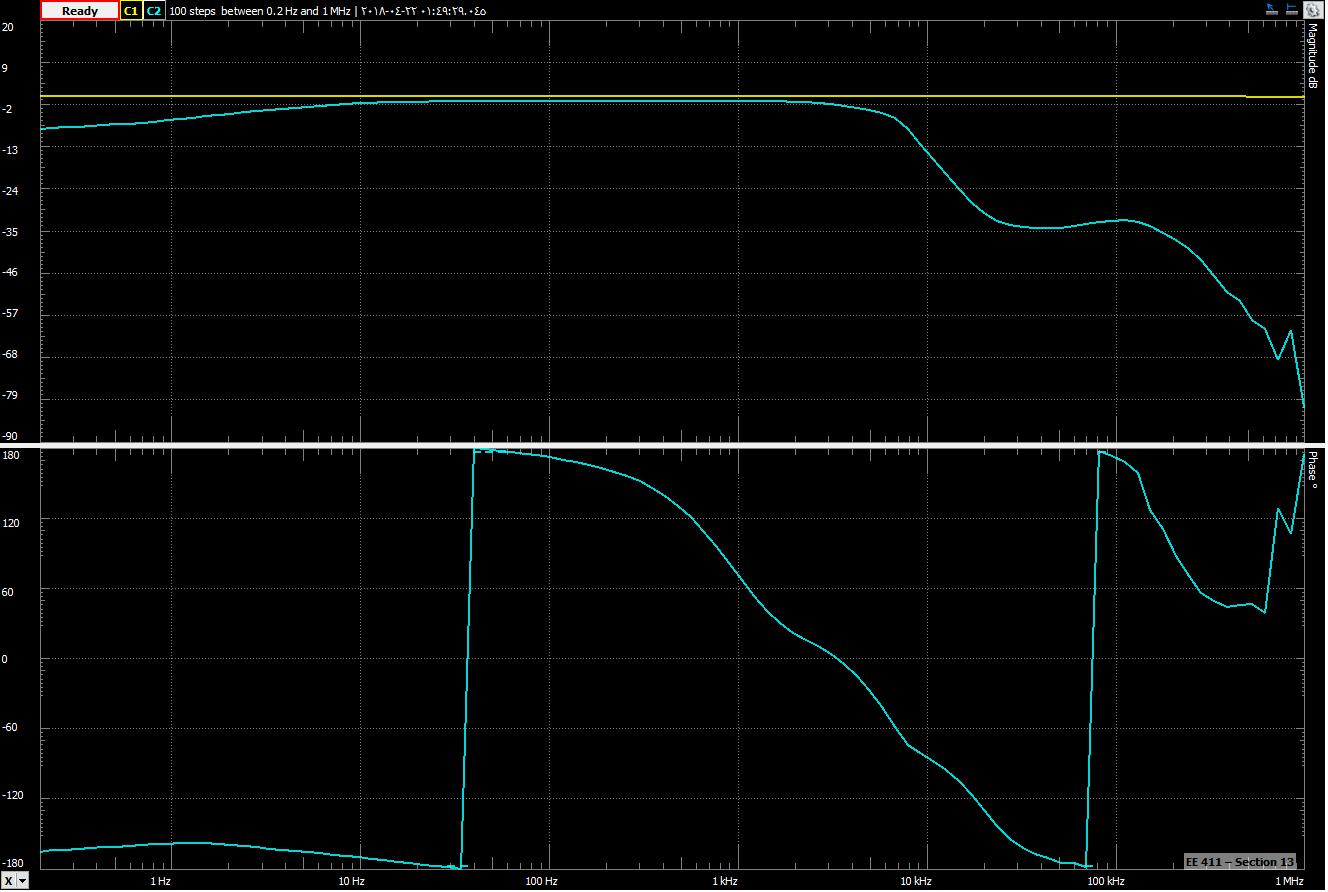
hardware/bench-measurements/normal/preamplifier-differential-with-clipper.jpg
