al-nafisah/wireless-seismic-daq/hardware/bench-measurements/normal/preamplifier-differential-without-clipper.jpg

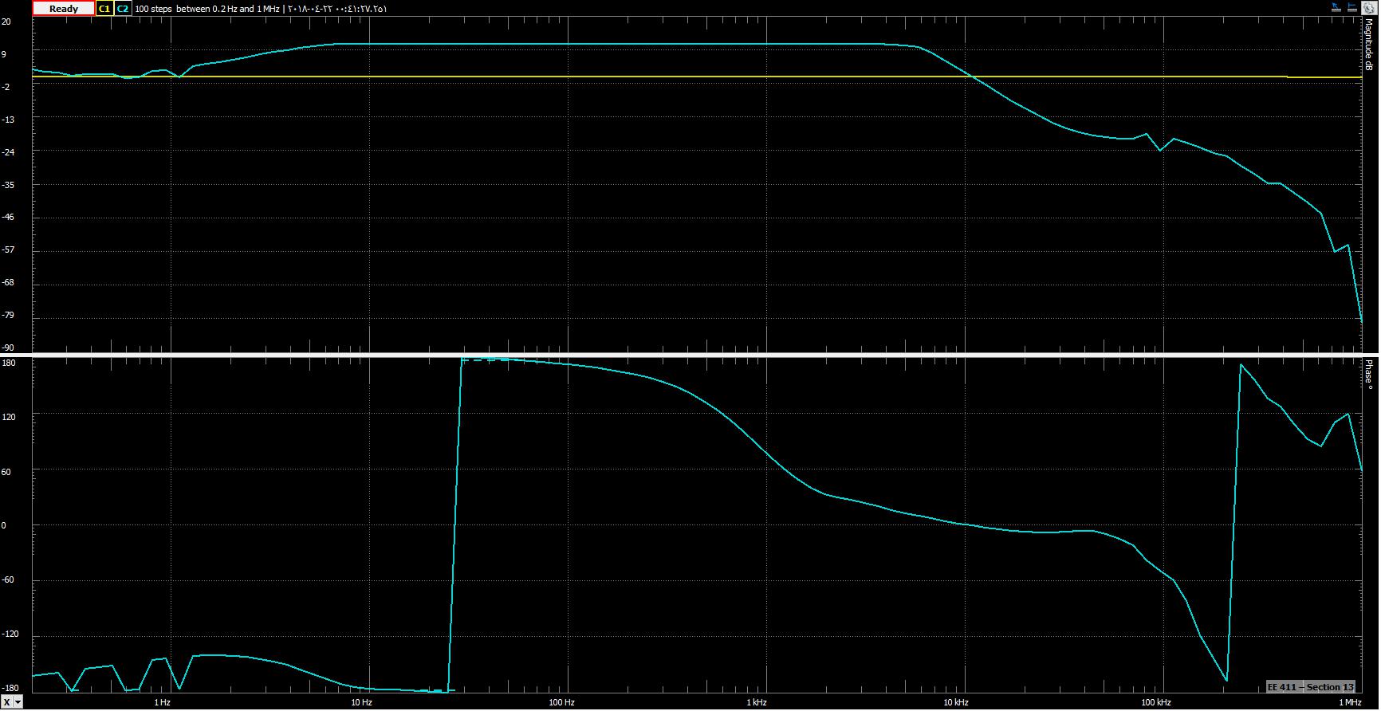
hardware/bench-measurements/normal/preamplifier-differential-without-clipper.jpg
