al-nafisah/wireless-seismic-daq/hardware/bench-measurements/normal/preamplifier-differential.jpg

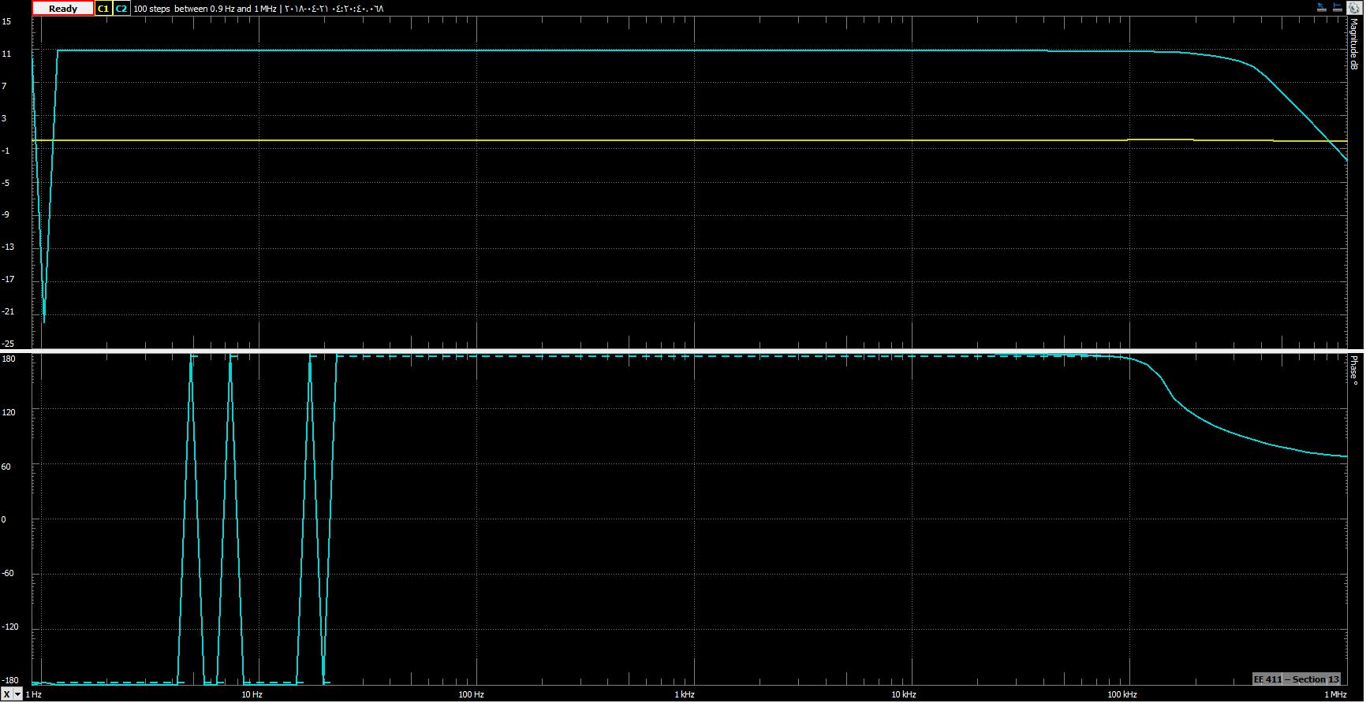
hardware/bench-measurements/normal/preamplifier-differential.jpg
