al-nafisah/wireless-seismic-daq/hardware/bench-measurements/scope-vs-matlab/gain-control-1m-matlab.jpg

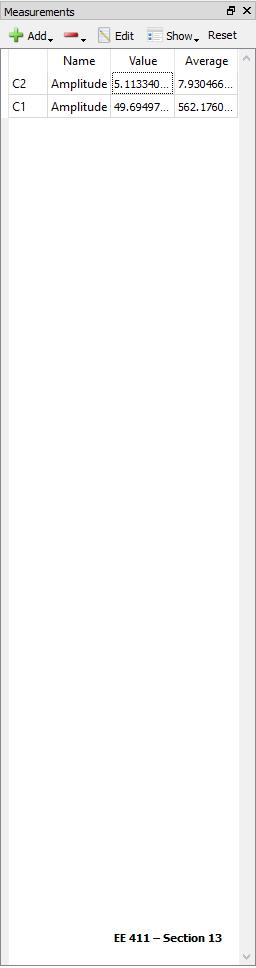
hardware/bench-measurements/scope-vs-matlab/gain-control-1m-matlab.jpg
