al-nafisah/wireless-seismic-daq/hardware/bench-measurements/scope-vs-matlab/gain-control-1m-scope.jpg

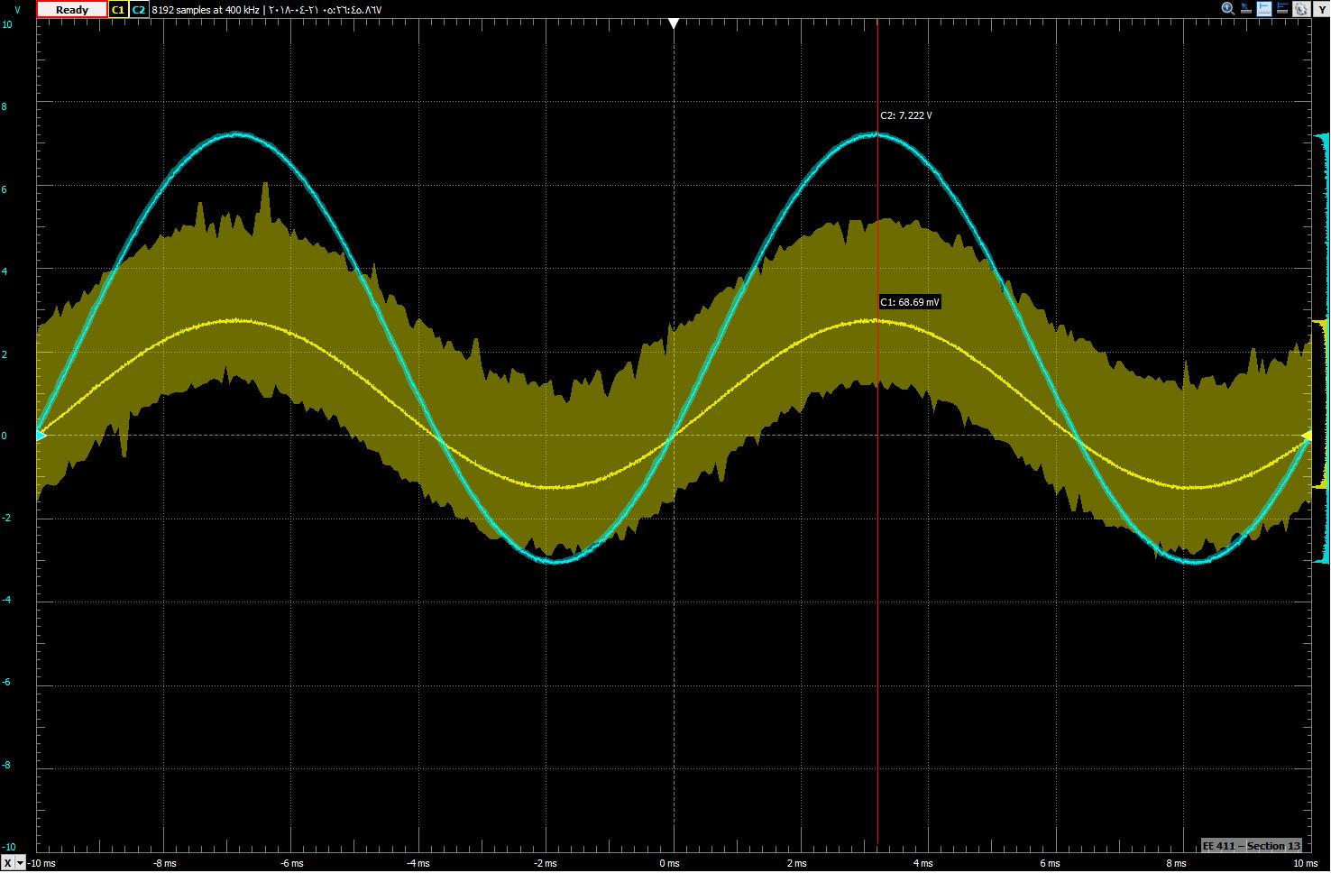
hardware/bench-measurements/scope-vs-matlab/gain-control-1m-scope.jpg
