al-nafisah/wireless-seismic-daq/hardware/bench-measurements/scope-vs-matlab/preamplifier-differential-scope.jpg

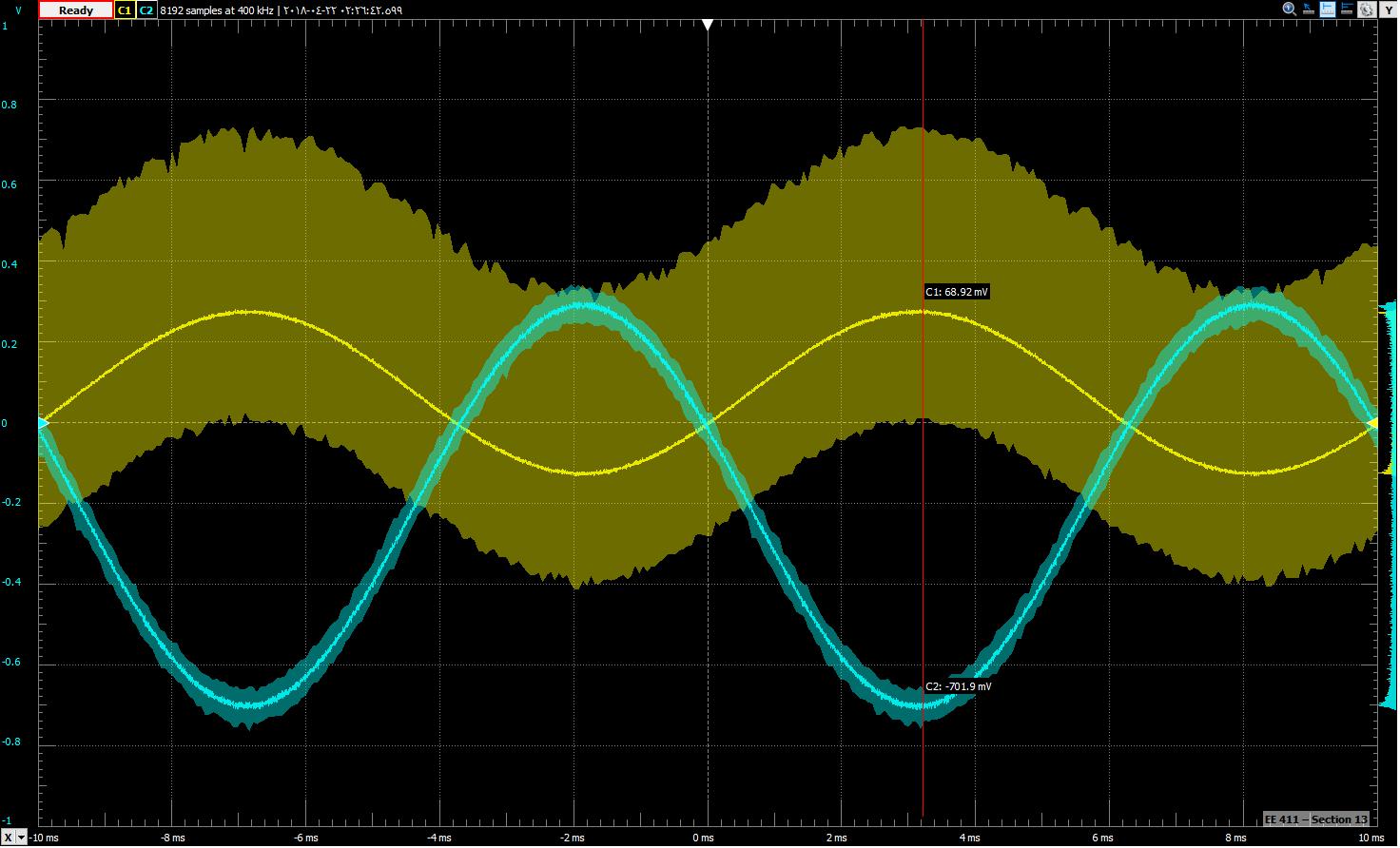
hardware/bench-measurements/scope-vs-matlab/preamplifier-differential-scope.jpg
