al-nafisah/wireless-seismic-daq/media/photos/early-test.jpg

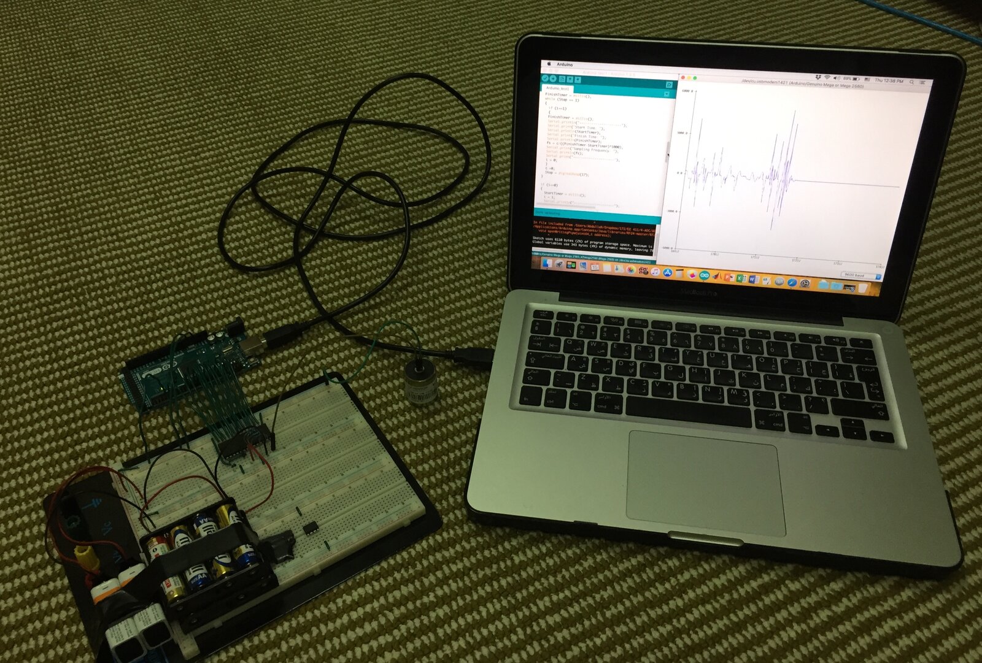
media/photos/early-test.jpg
