al-nafisah/wireless-seismic-daq/media/photos/field-test-1.jpg

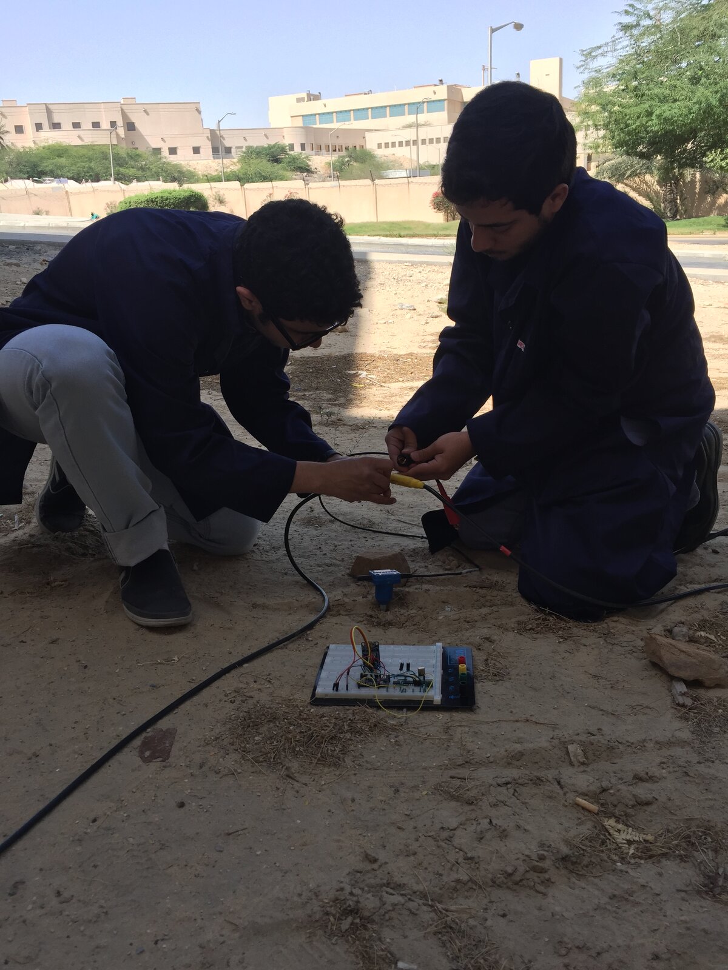
media/photos/field-test-1.jpg
