al-nafisah/wireless-seismic-daq/media/photos/field-test-2.jpg

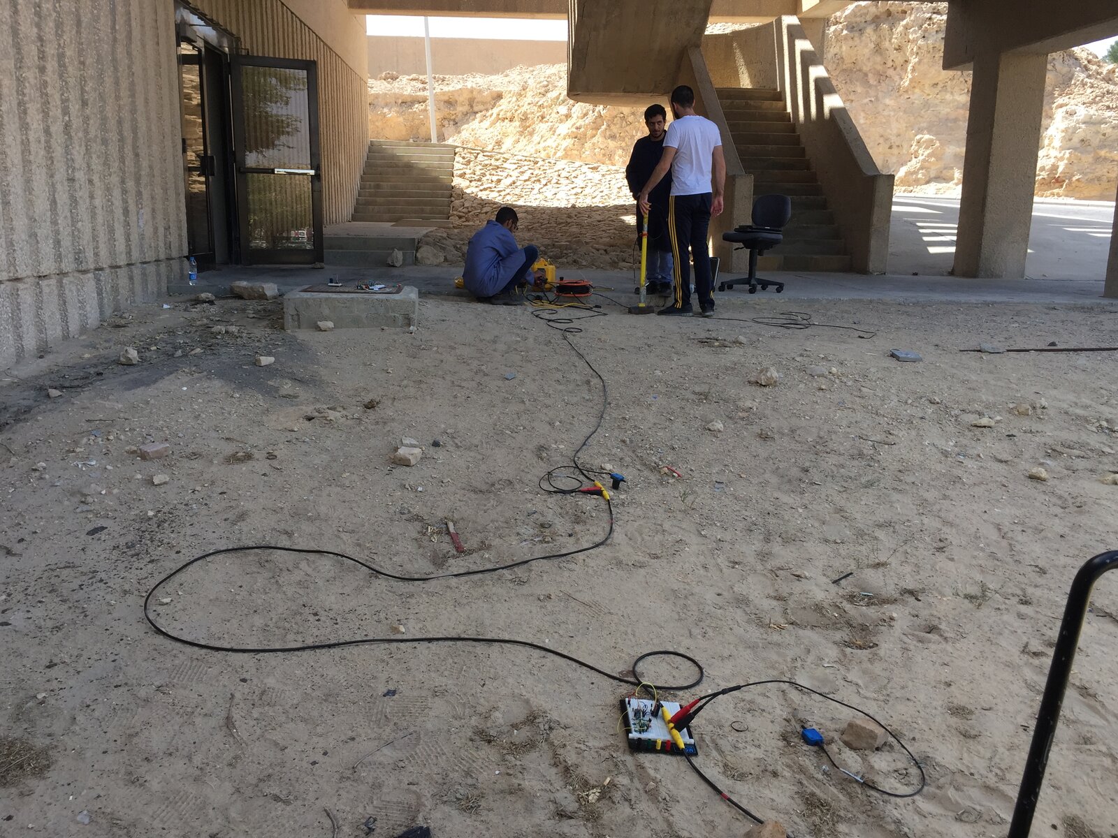
media/photos/field-test-2.jpg
