al-nafisah/wireless-seismic-daq/media/photos/field-test-3.jpg

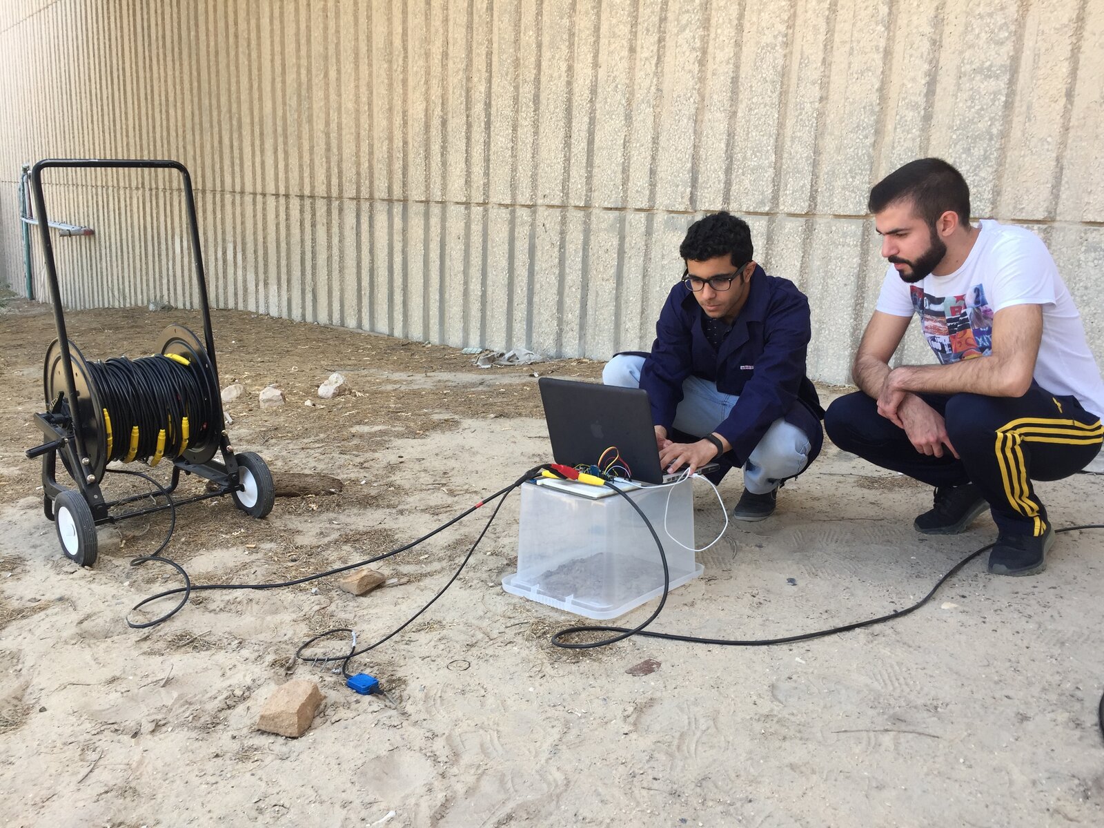
media/photos/field-test-3.jpg
