al-nafisah/wireless-seismic-daq/media/photos/field-test-4.jpg

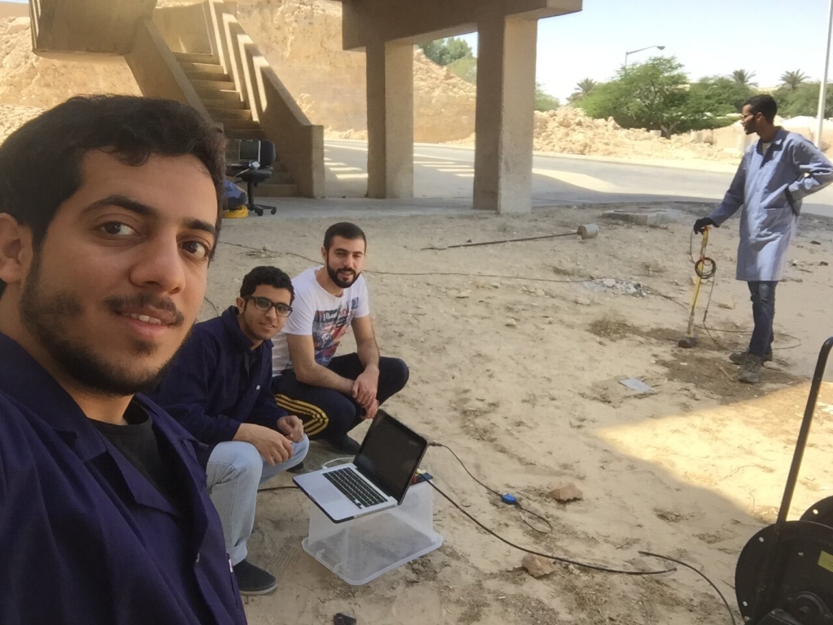
media/photos/field-test-4.jpg
