al-nafisah/wireless-seismic-daq/docs/final-presentation.pdf

# Prototype of a Wireless Seismic

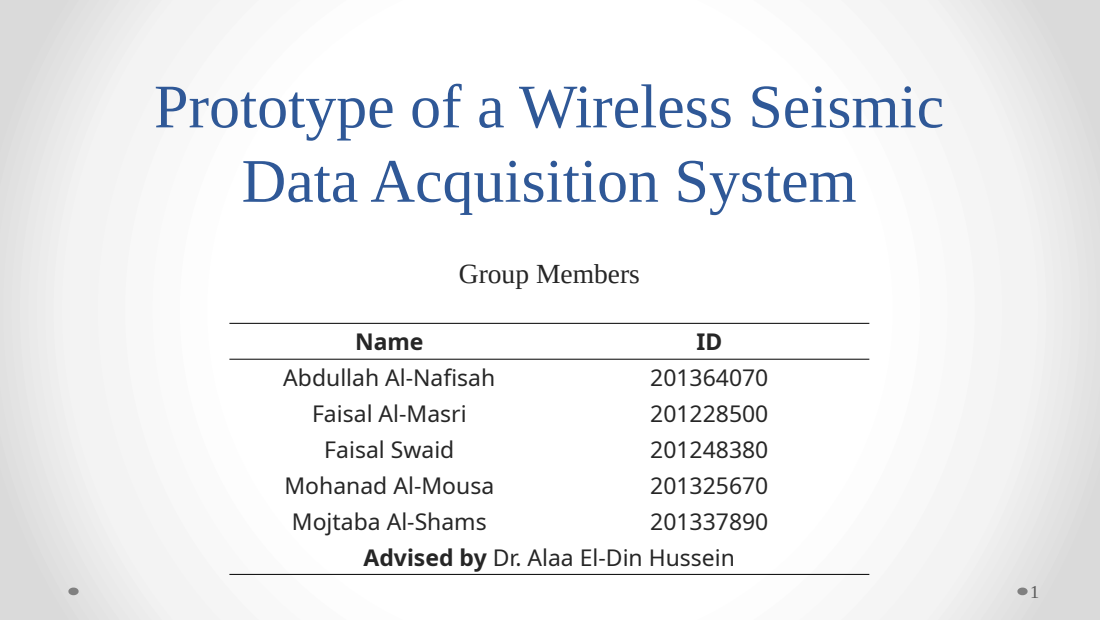
[picture p117: page 1]
Group Members; Name; Abdullah Al-Nasah; Faisal Al-Masri; Faisal Swaid; Mohanad Al-Mousa; Mojtaba Al-Shams

Data Acquisition System

Advised by Dr. Alaa El-Din Hussein

# OUTLINES

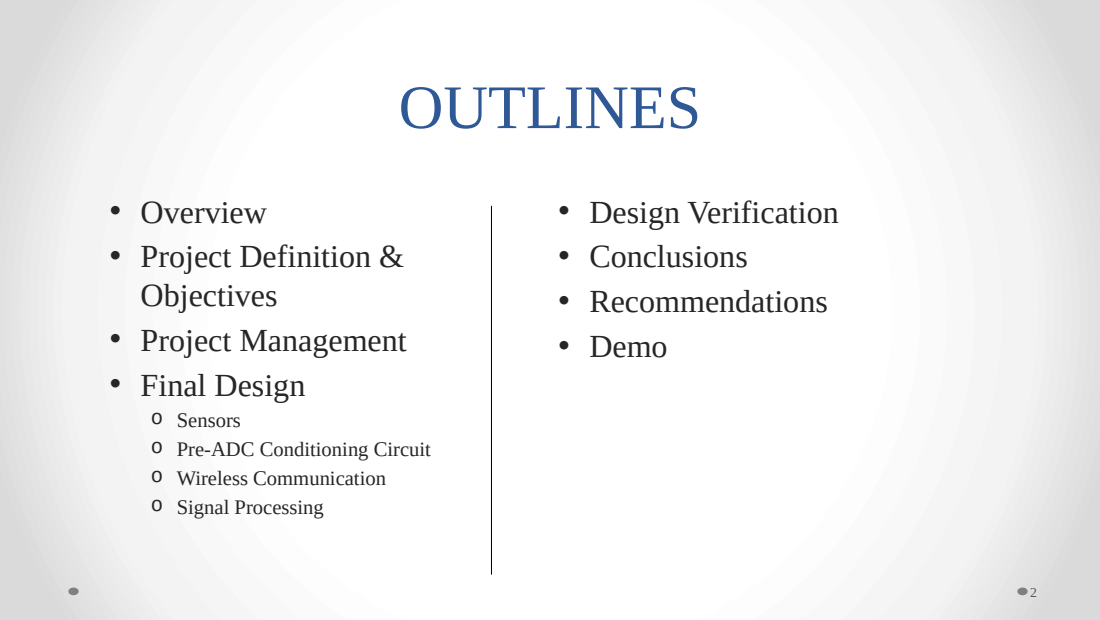
[picture p118: page 2]
• Overview; • Project Definition & Objectives; • Project Management; • Final Design; • Design Verification; • Conclusions; • Recommendations; • Demo

o Sensors
o Pre-ADC Conditioning Circuit
o Wireless Communication
o Signal Processing

# Seismic Data ?

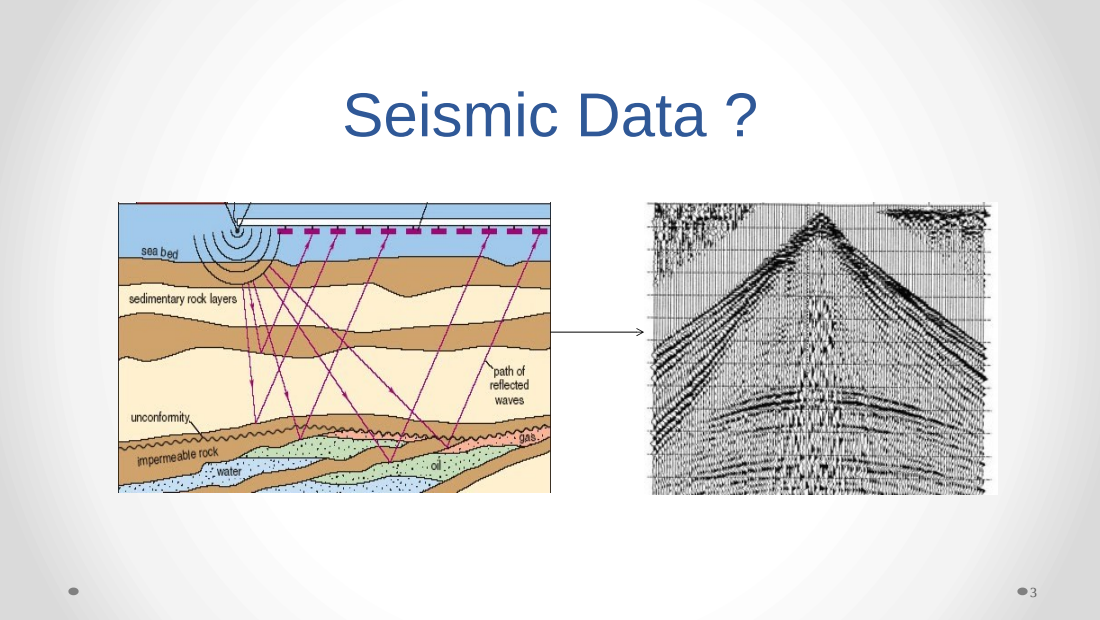
[picture p119: page 3]

# Work Distribution

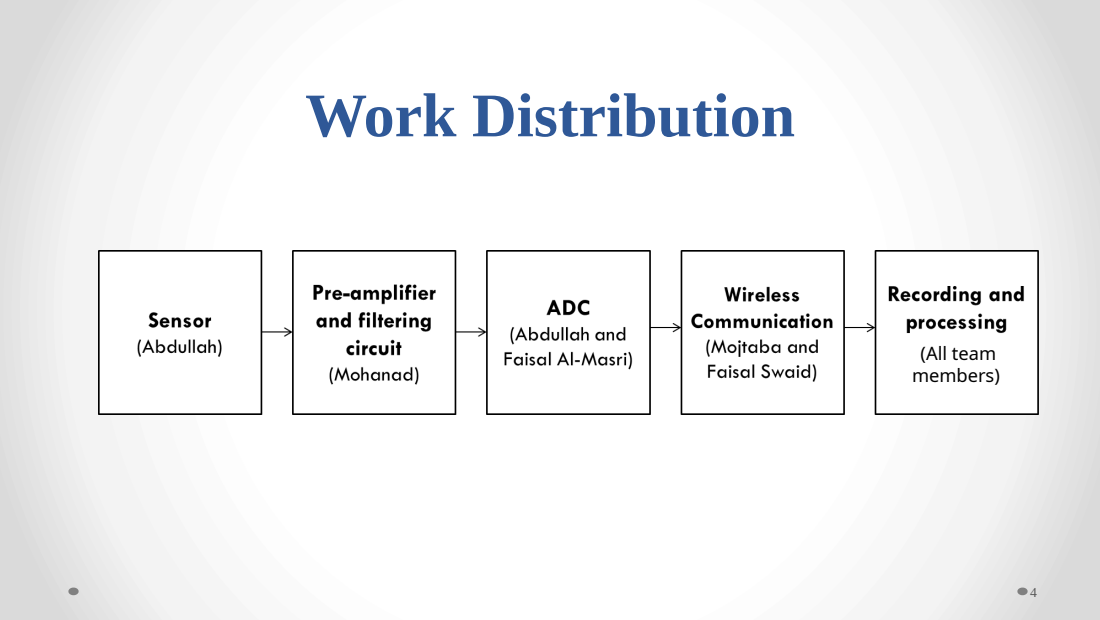
[picture p120: page 4]
(All team members)

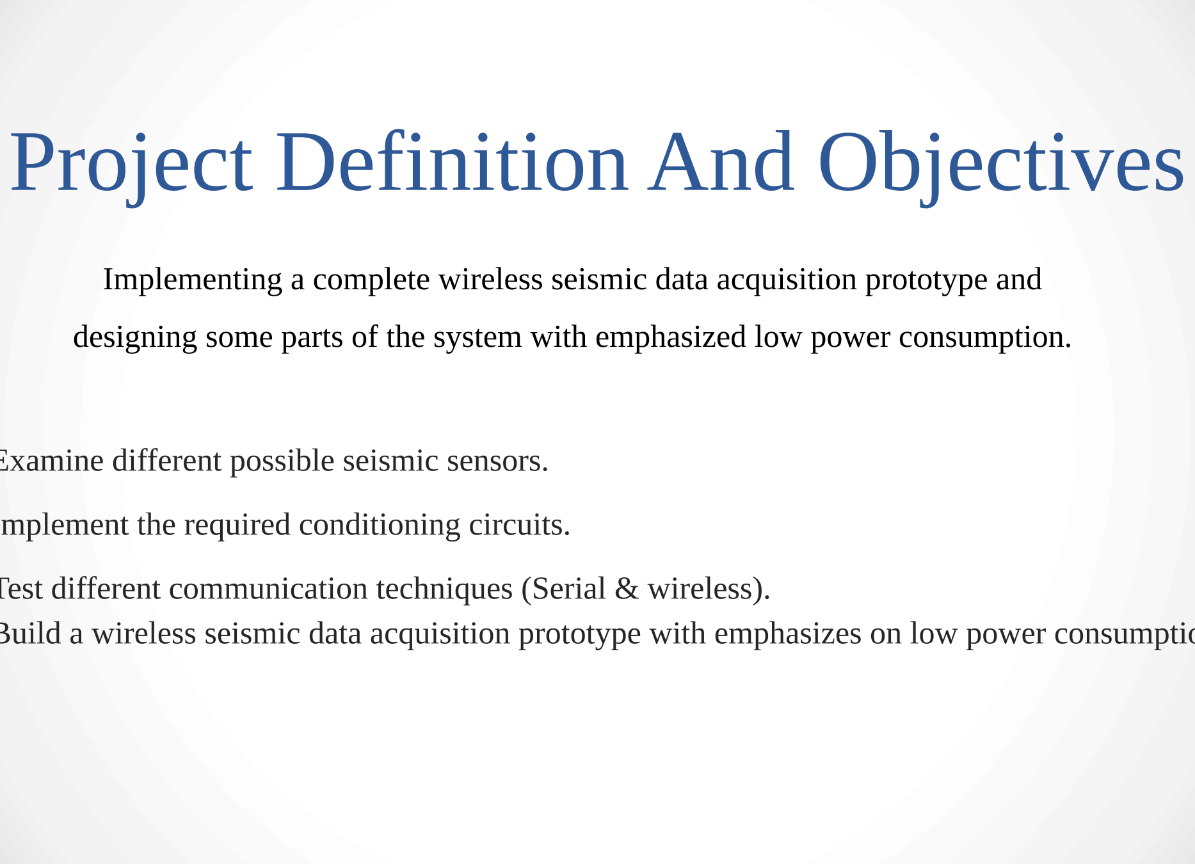
[picture p121: figure]
Project Definition And Objectives

- Examine different possible seismic sensors.
- Implement the required conditioning circuits.
- Test different communication techniques (Serial & wireless).
- Build a wireless seismic data acquisition prototype with emphasizes on low power consumption.

Implementing a complete wireless seismic data acquisition prototype and

designing some parts of the system with emphasized low power consumption.

# Project management

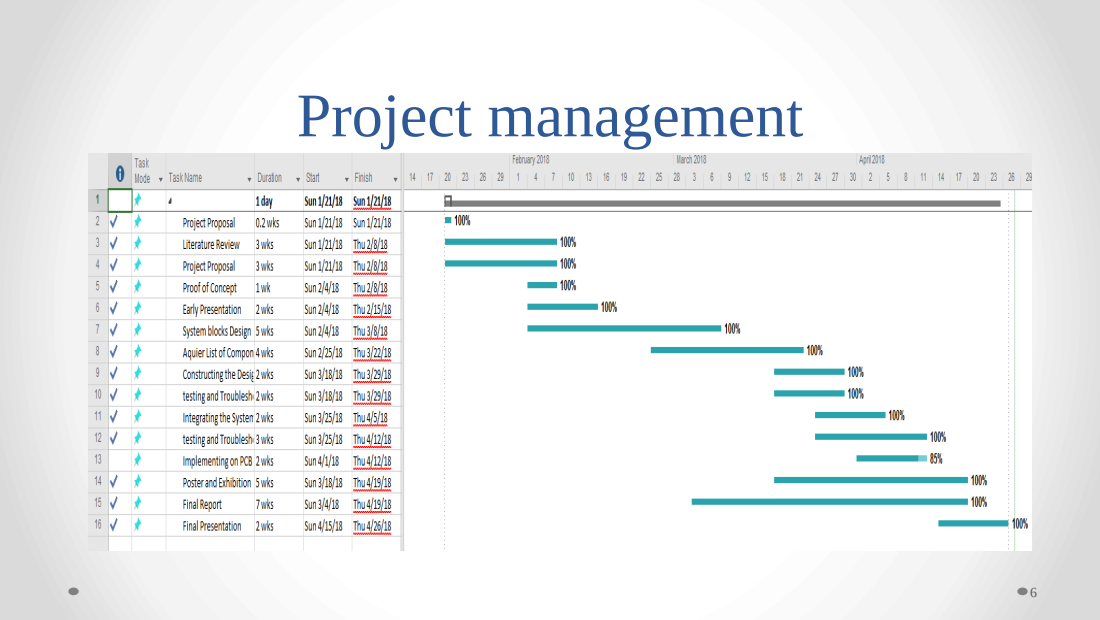
[picture p122: page 6]

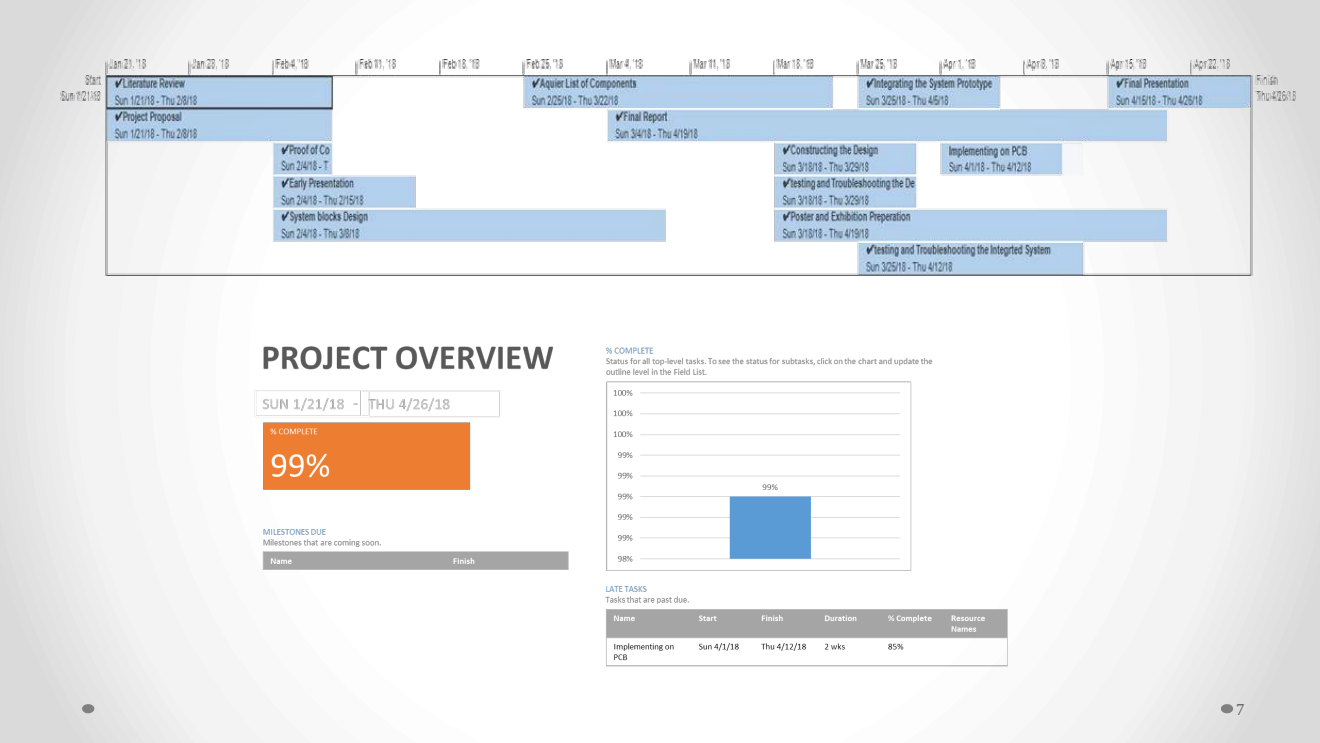
[picture p123: page 7]

# Final Design

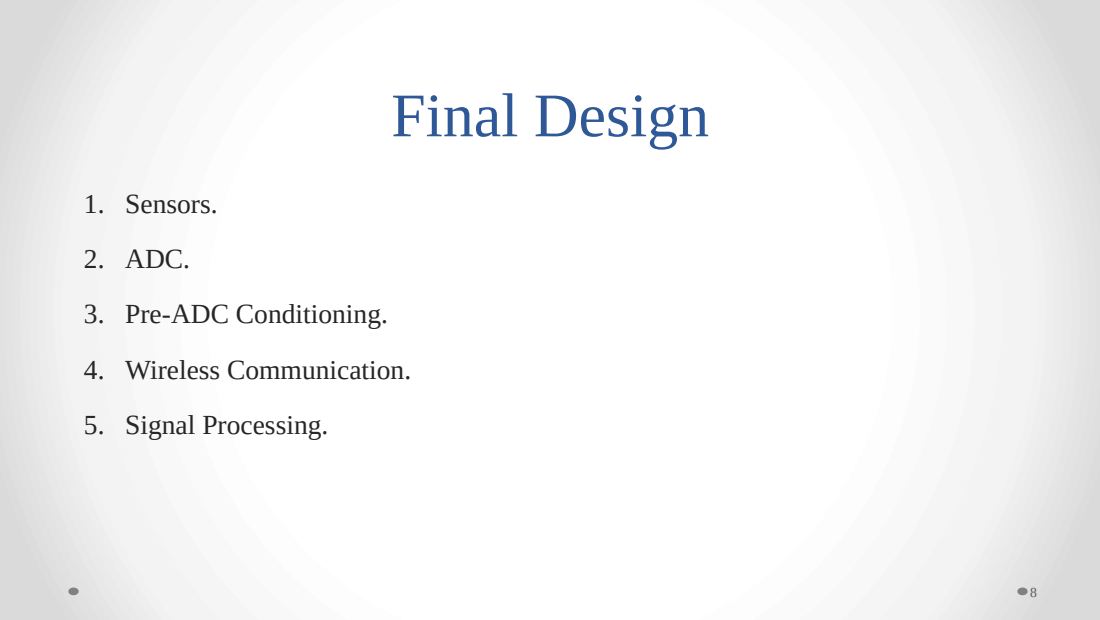
[picture p124: page 8]
1. Sensors.; 2. ADC.; 4. Wireless Communication.; 5. Signal Processing.

3. Pre-ADC Conditioning.

# Sensors

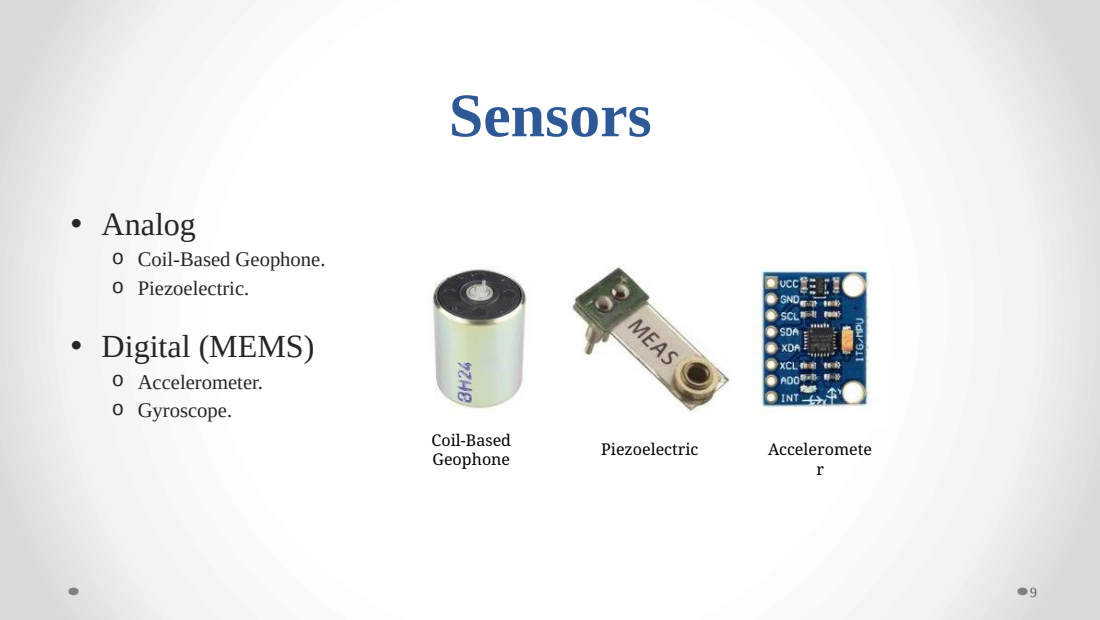
[picture p125: page 9]
• Analog; o Accelerometer.; o Gyroscope.; Coil-Based; Geophone; Piezoelectric; Acceleromete

o Coil-Based Geophone.
o Piezoelectric.
• Digital (MEMS)

# Coil Based Geophone Impulse Response

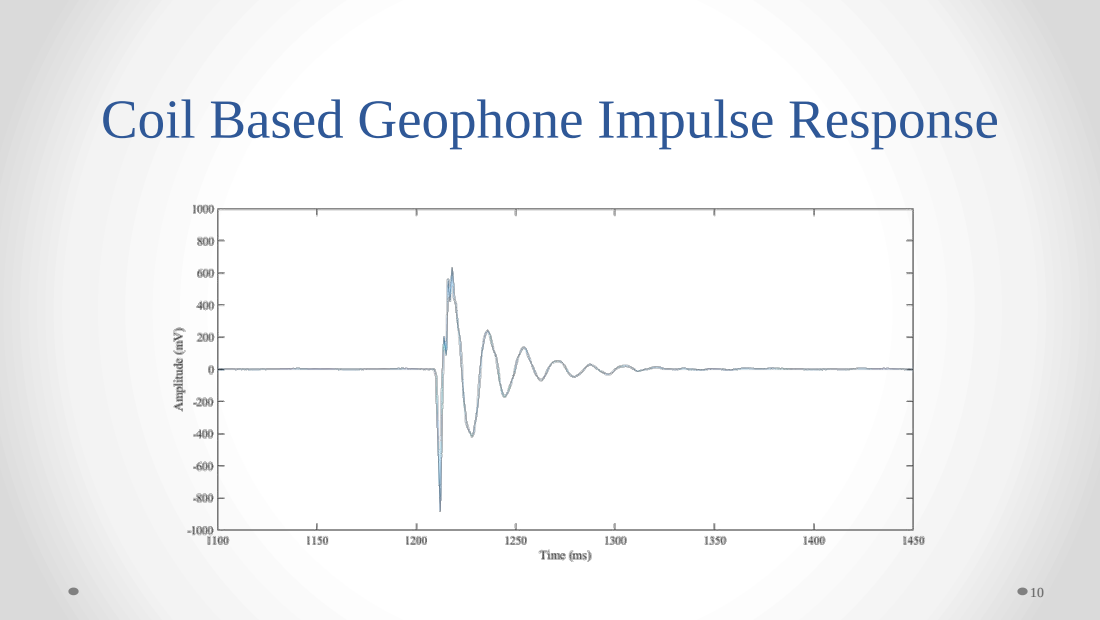
[picture p126: page 10]

# Piezoelectric Impulse Response

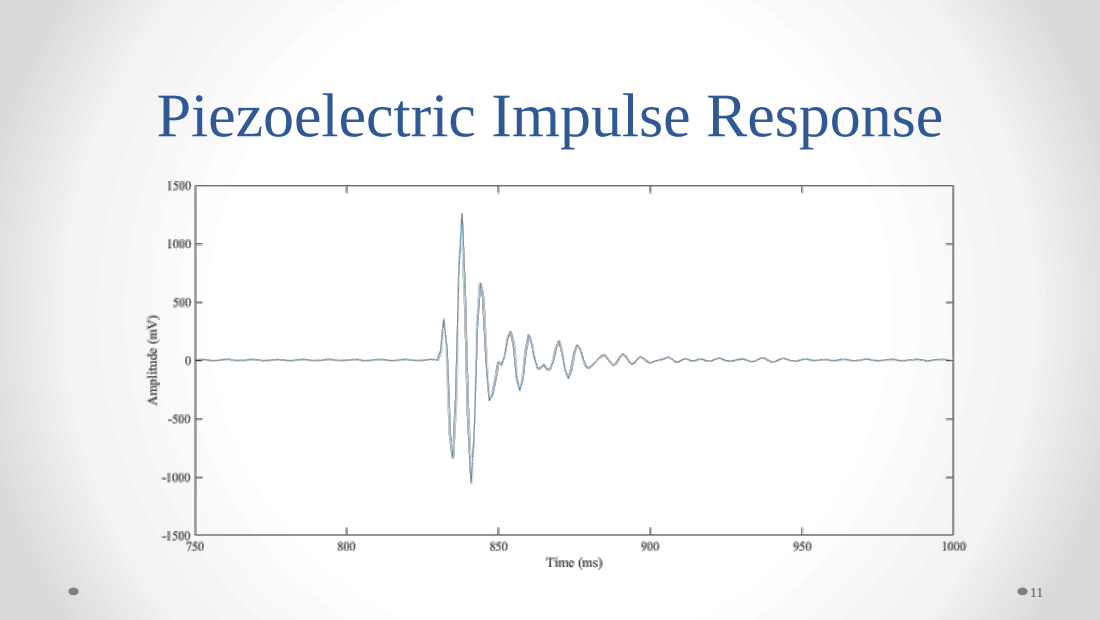
[picture p127: page 11]

# Accelerometer Impulse Response

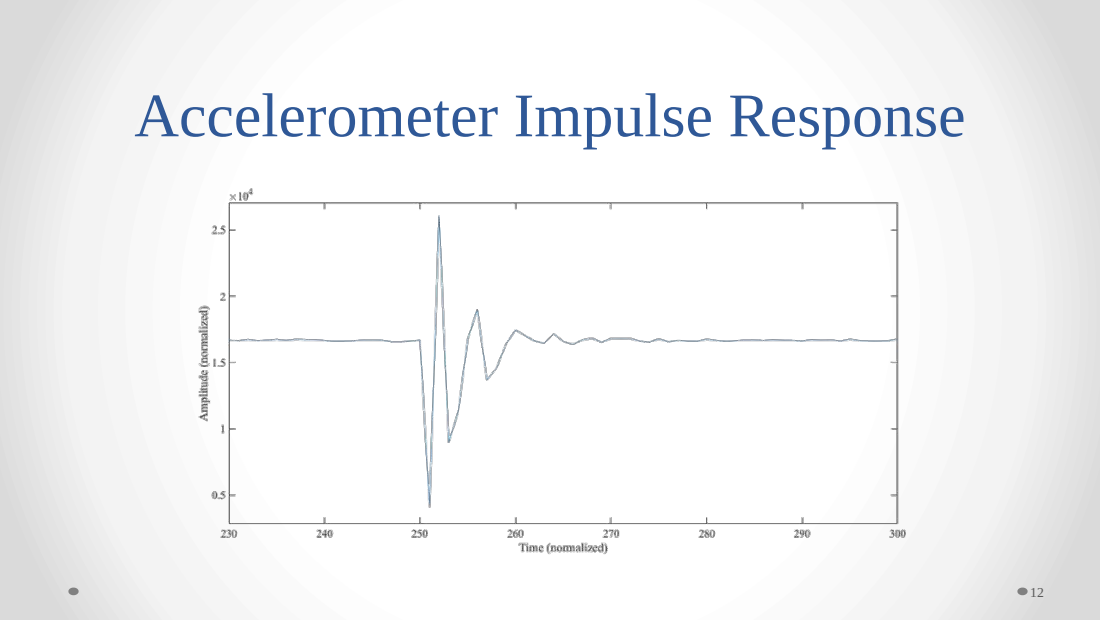
[picture p128: page 12]

# Signal conditioning phase

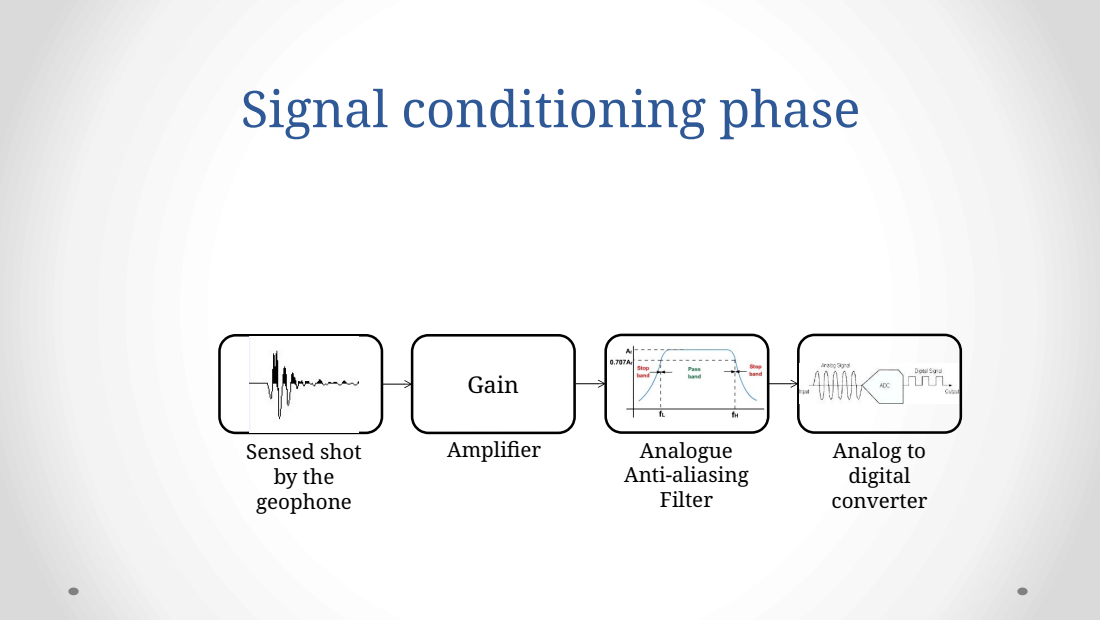
[picture p129: page 13]
Gain; Sensed shot; Amplier; by the geophone; Analogue Anti-aliasing Filter; Analog to digital converter

# Signal conditioning circuit (S.C.C.)

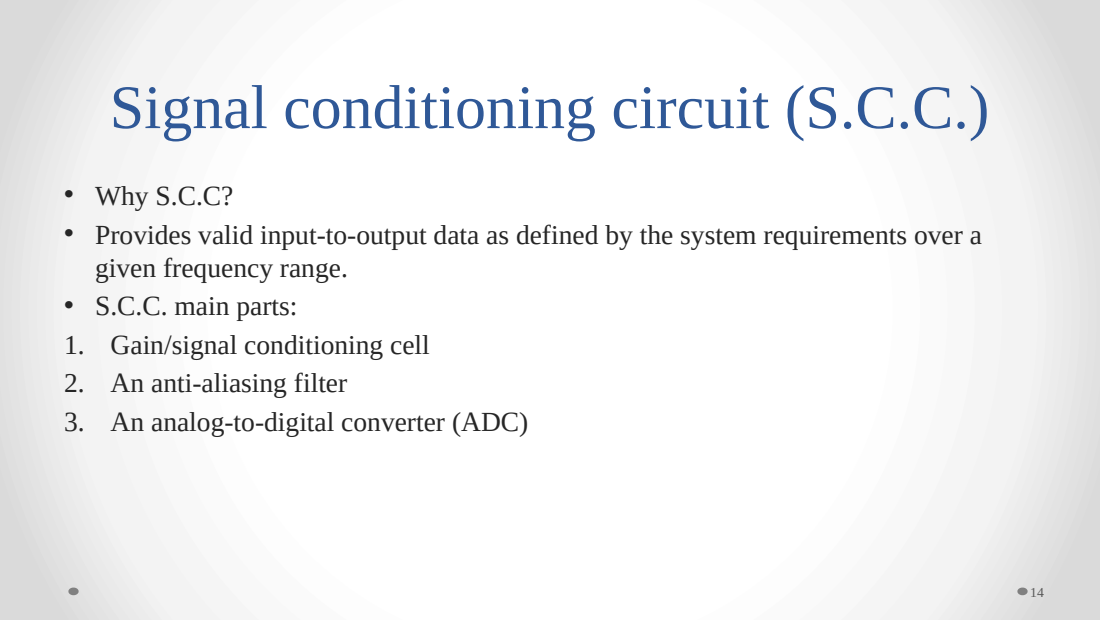
[picture p130: page 14]

• Why S.C.C?
• Provides valid input-to-output data as defined by the system requirements over a
given frequency range.
• S.C.C. main parts:
1. Gain/signal conditioning cell
2. An anti-aliasing filter
3. An analog-to-digital converter (ADC)

# Signal conditioning circuit (S.C.C.)

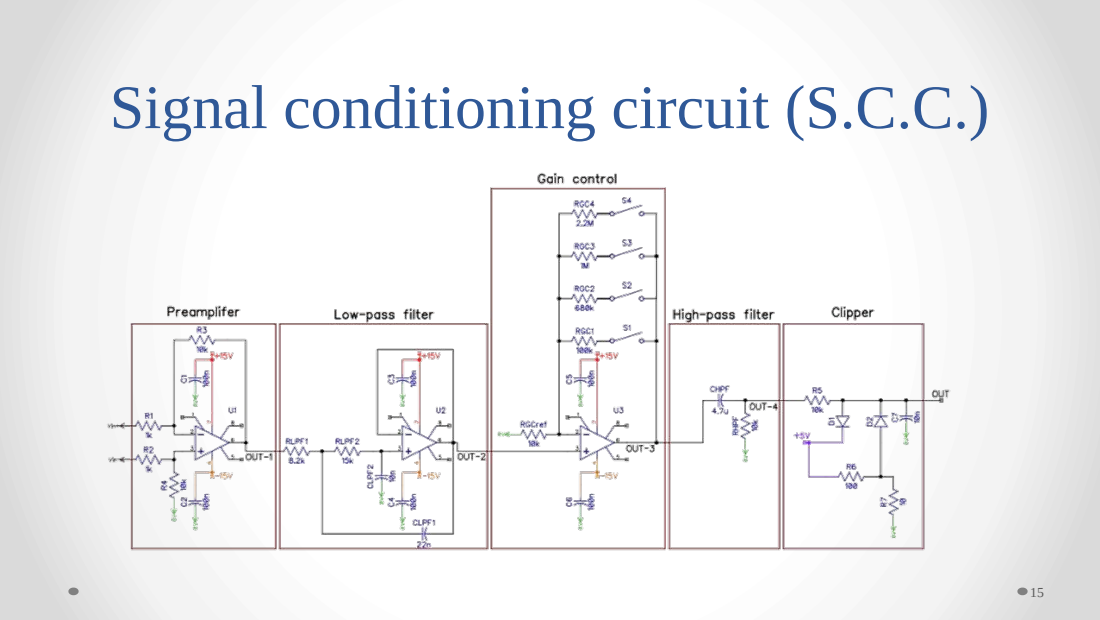
[picture p131: page 15]

# Signal conditioning circuit (S.C.C.)

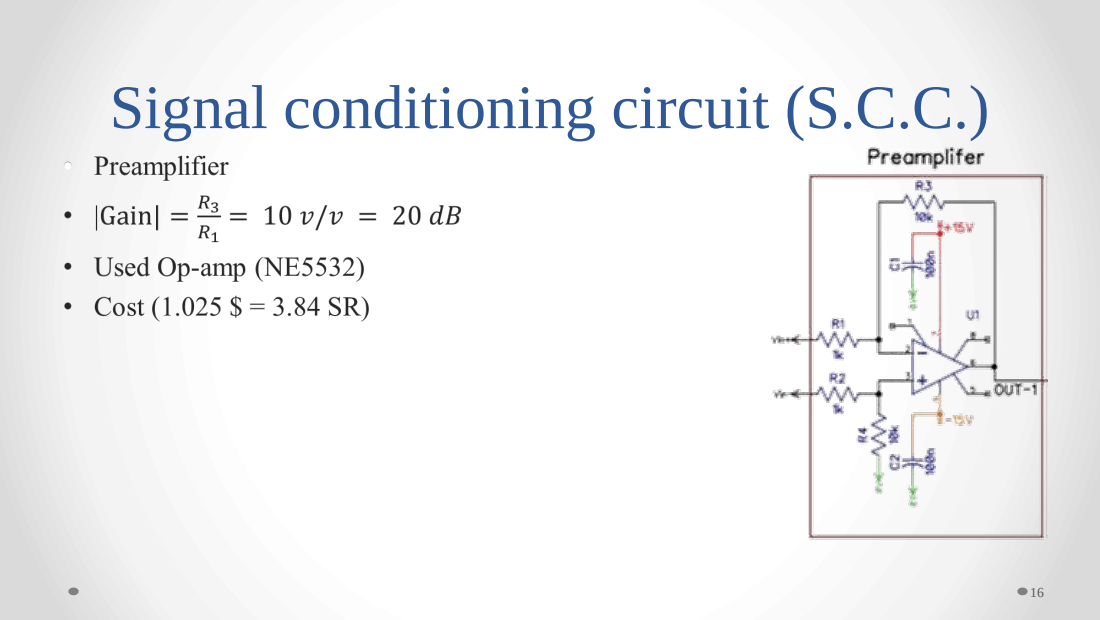
[picture p132: page 16]

# Signal conditioning circuit (S.C.C.)

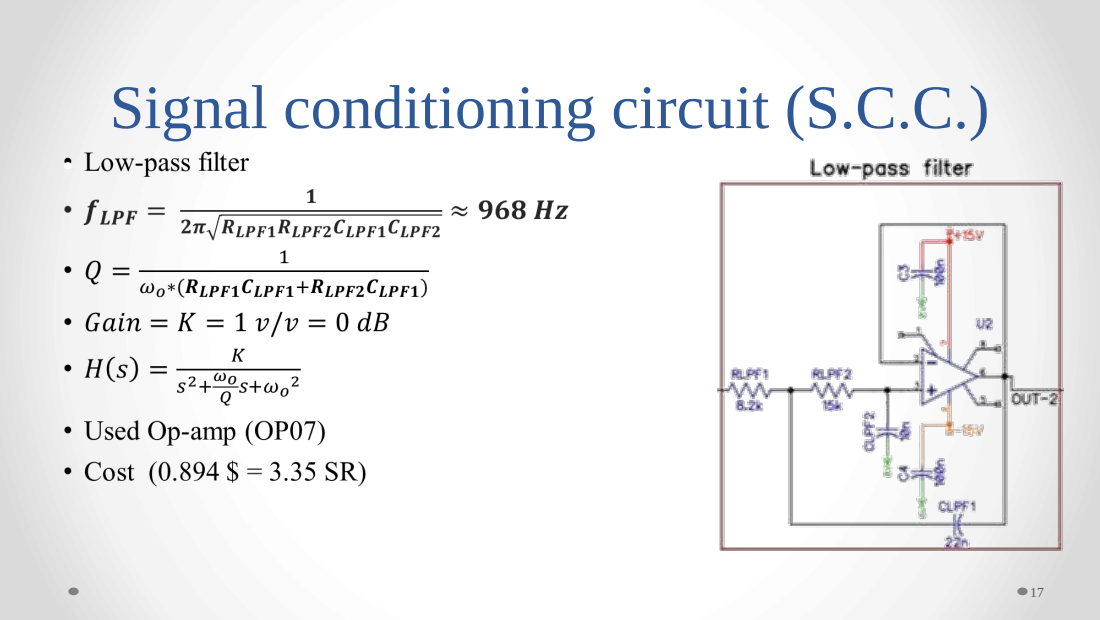
[picture p133: page 17]

# Signal conditioning circuit (S.C.C.)

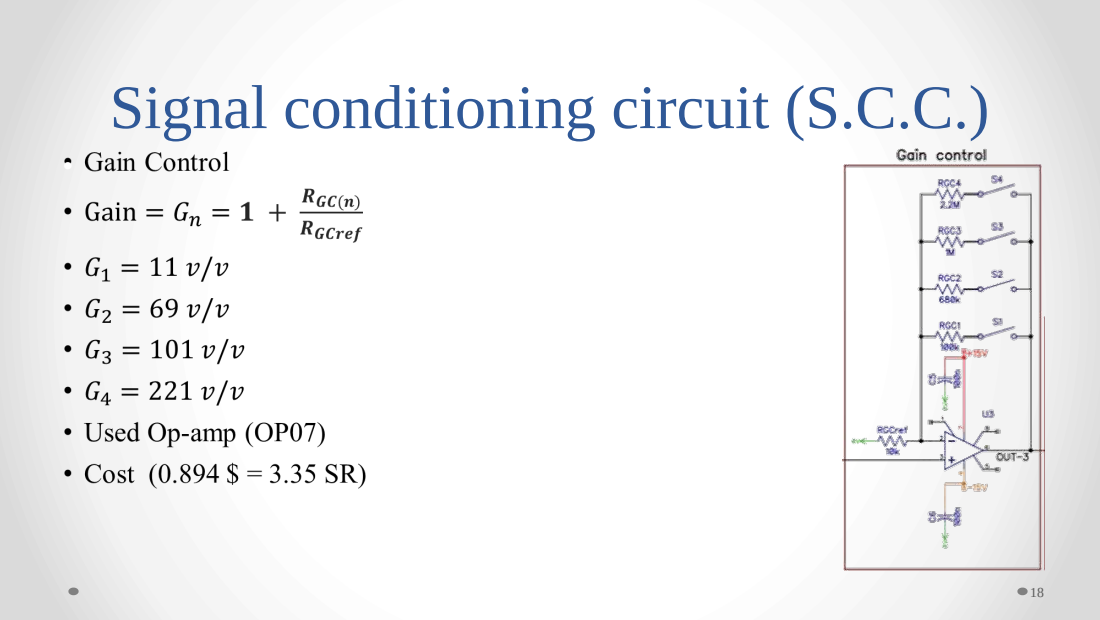
[picture p134: page 18]

# Signal conditioning circuit (S.C.C.)

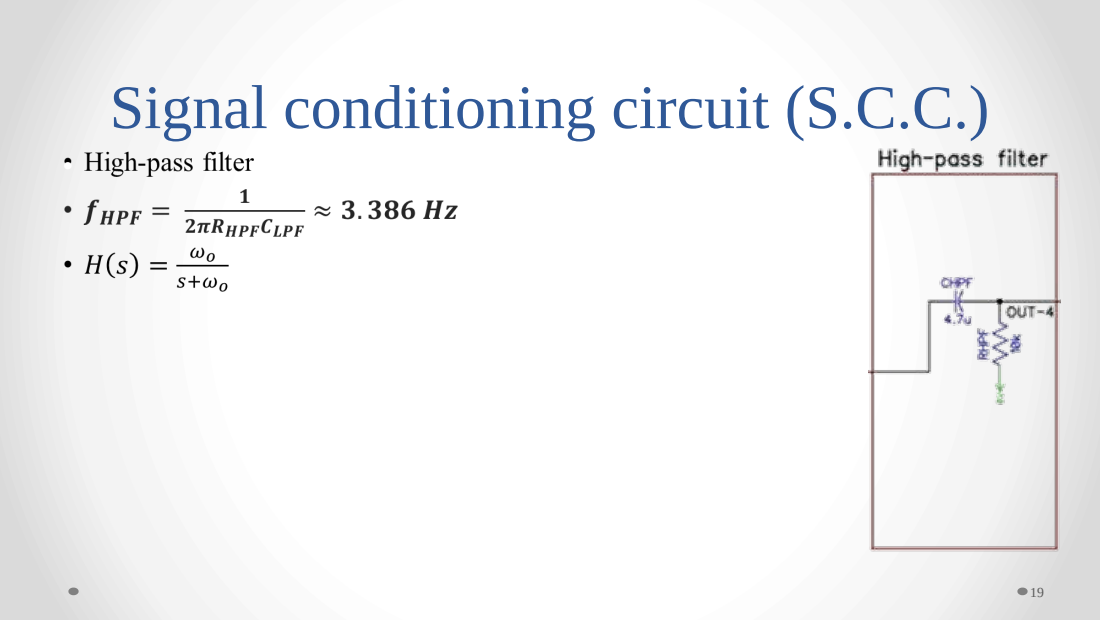
[picture p135: page 19]

# Signal conditioning circuit (S.C.C.)

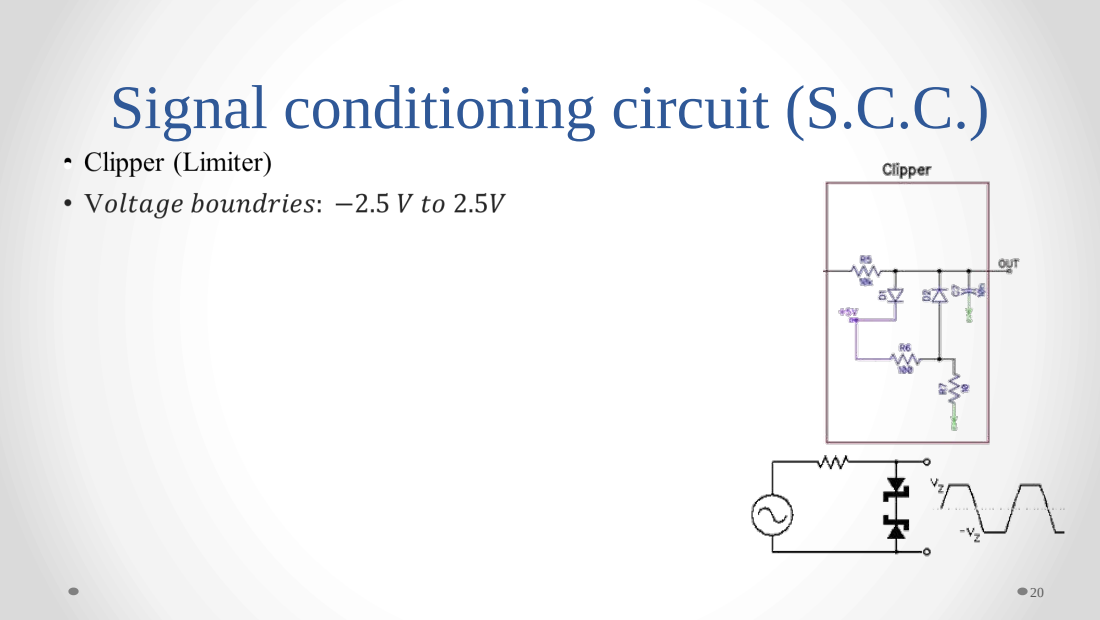
[picture p136: page 20]

# Analog to Digital Conversion

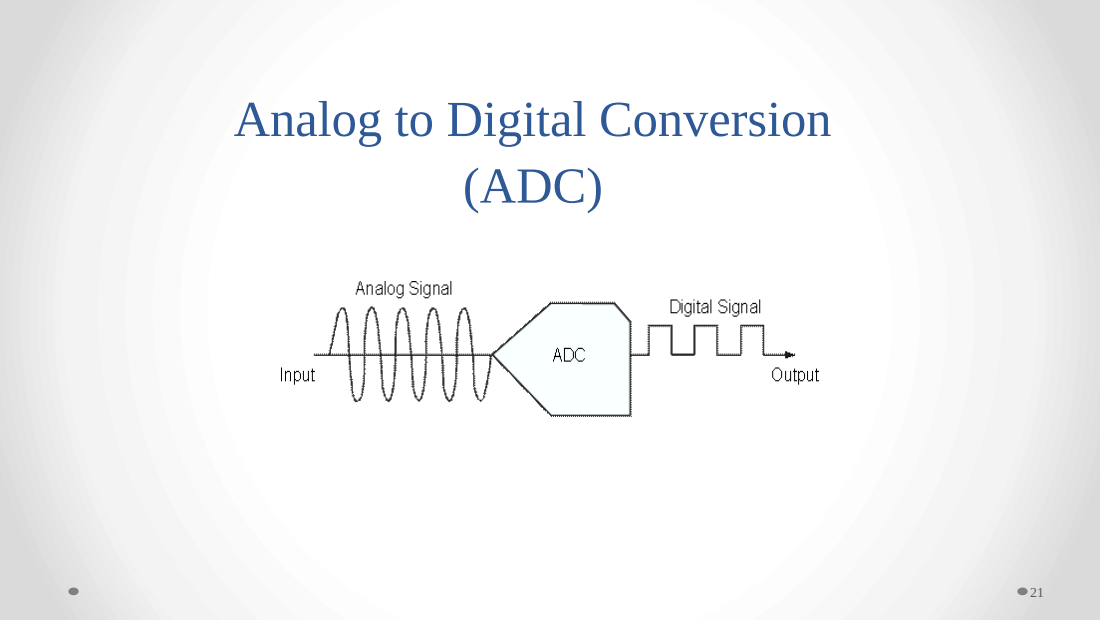
[picture p137: page 21]
(ADC)

# Analog to Digital Converters (ADCs)

Type | Advantages | Disadvantages
Flash | Ø Fast (almost instantaneous). Ø Simplicity. | Ø Requires huge number of parts (exponentially proportional to the number of bits). Ø Low resolution (mainly caused by the mismatch between parts) Ø High power consumption
SAR | Ø Constant power dissipation versus sampling rate. Ø High resolution. | Ø Slow conversion. Ø Easily subjected to noise causing inaccurate readings.
Dual Slope | Ø High accuracy. Ø Immune to noise (coined to the conversion di+erential nature). | Ø Slow conversion Ø Expensive. Ø Accuracy may be a+ected by improper external connections.
Δ-Σ | Ø High resolution. Ø Low power consumption. Ø Low cost. | Ø Not practical for high frequency applications due to oversampling.

# Why Delta-Sigma ADC ?

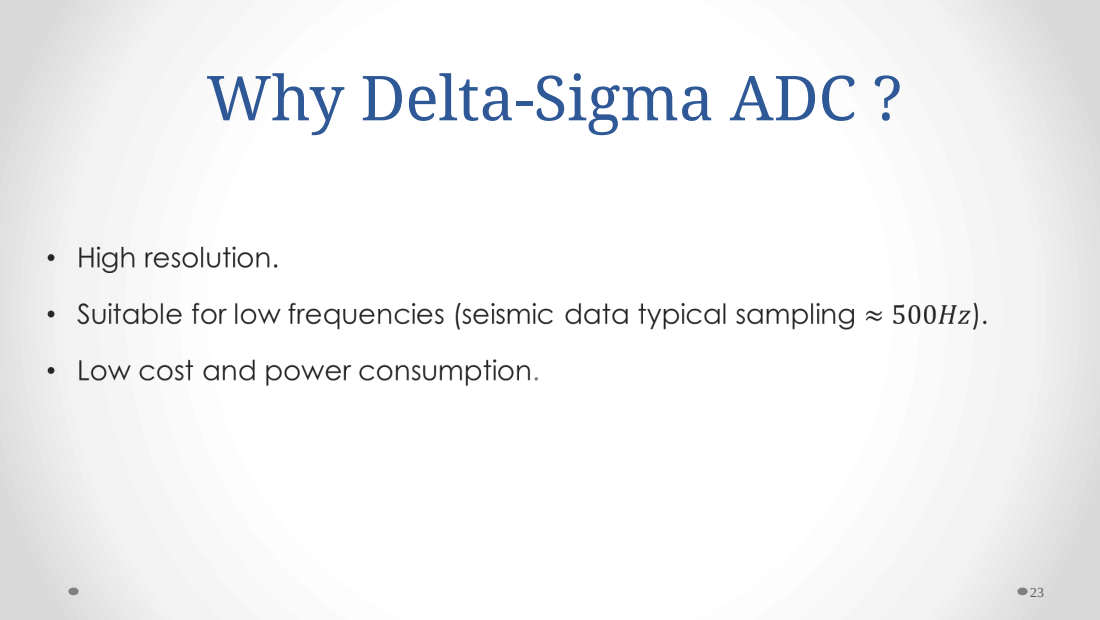
[picture p138: page 23]

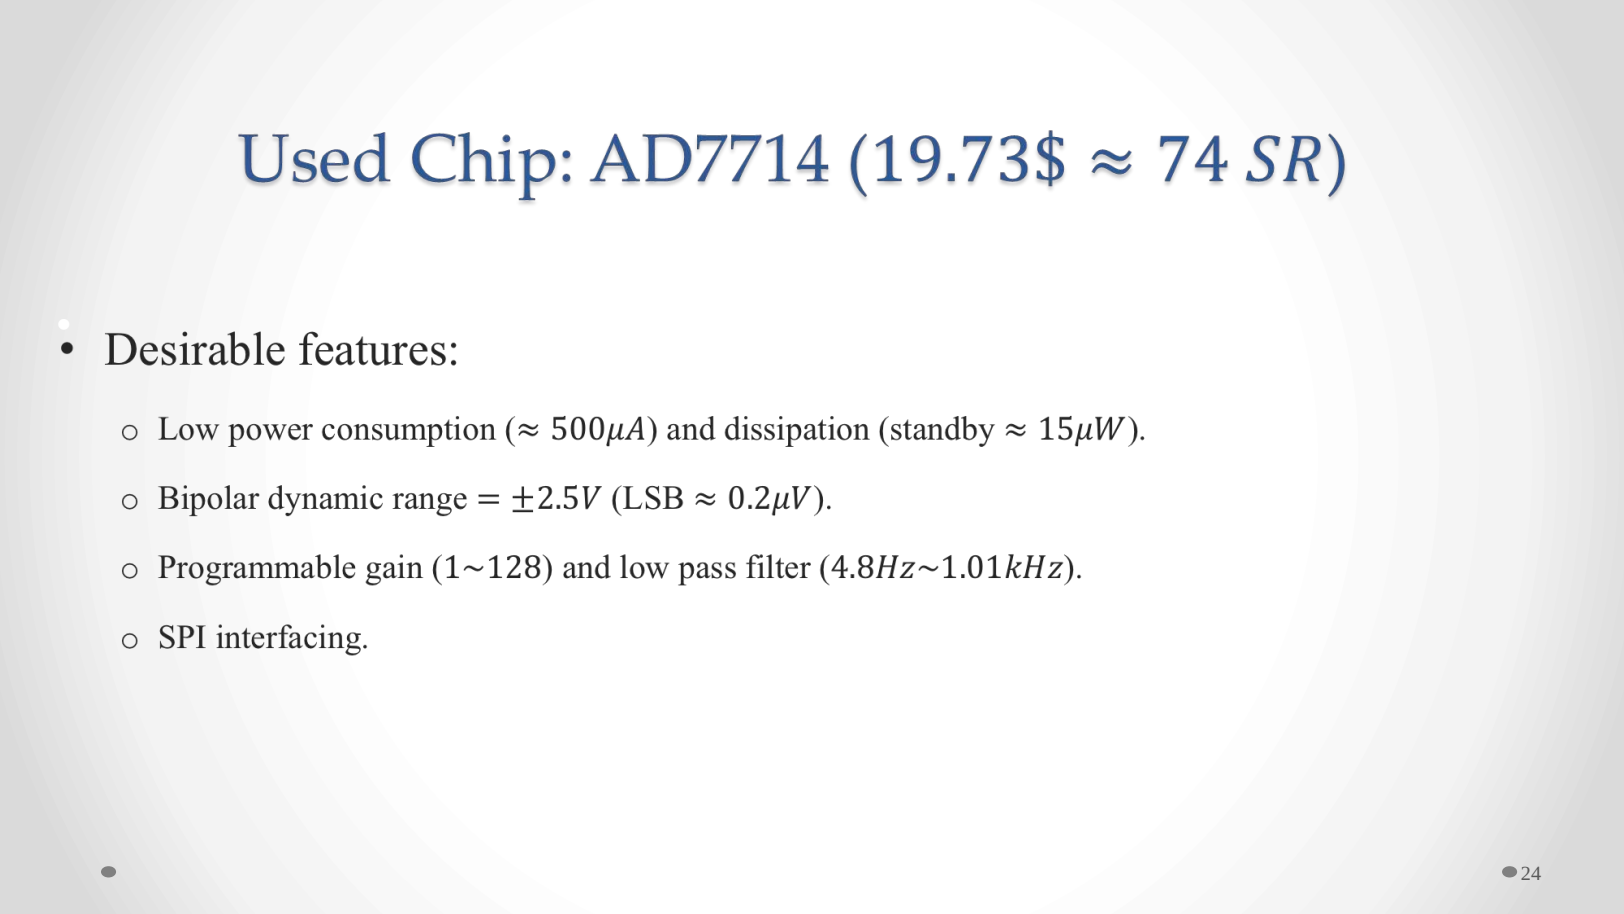
[picture p139: page 24]

# Functional Diagram & Circuit Connection

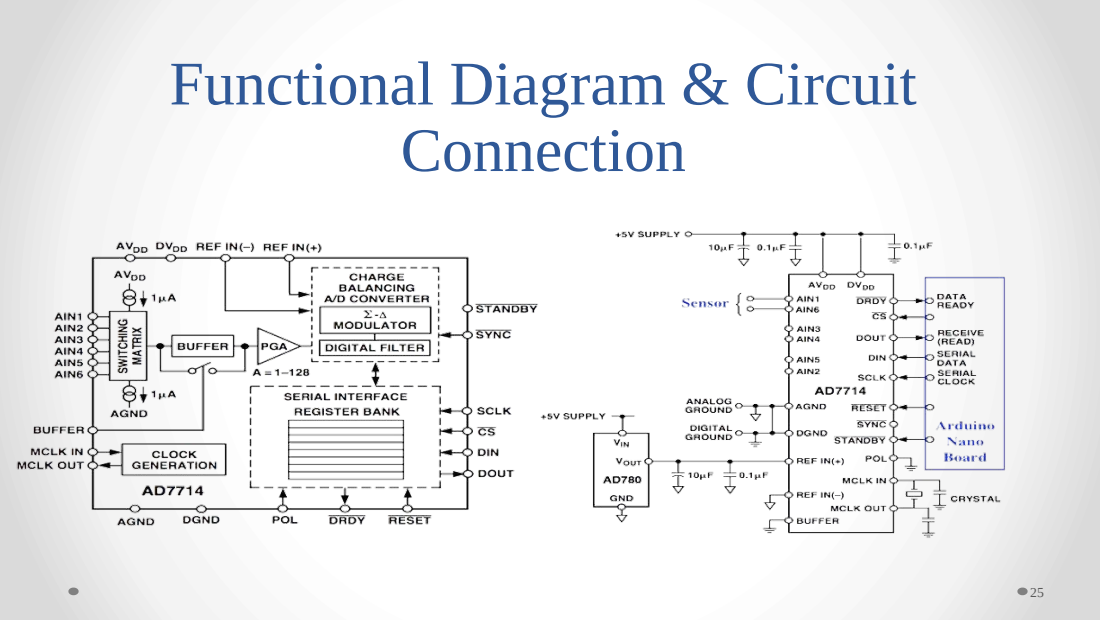
[picture p140: page 25]

# Chip Registers

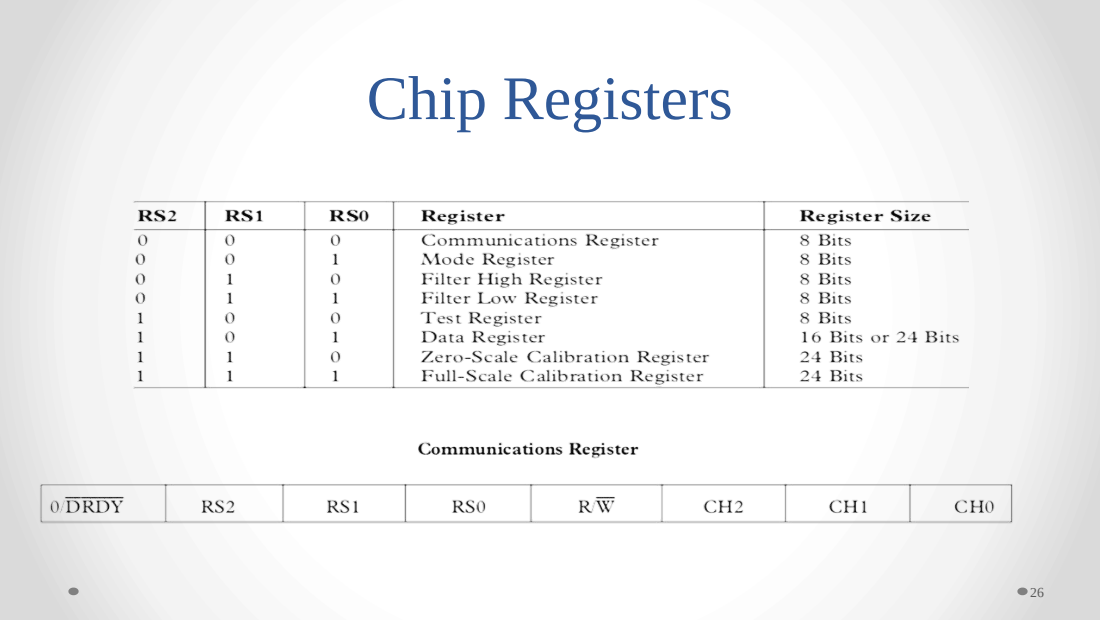
[picture p141: page 26]

# Configuration

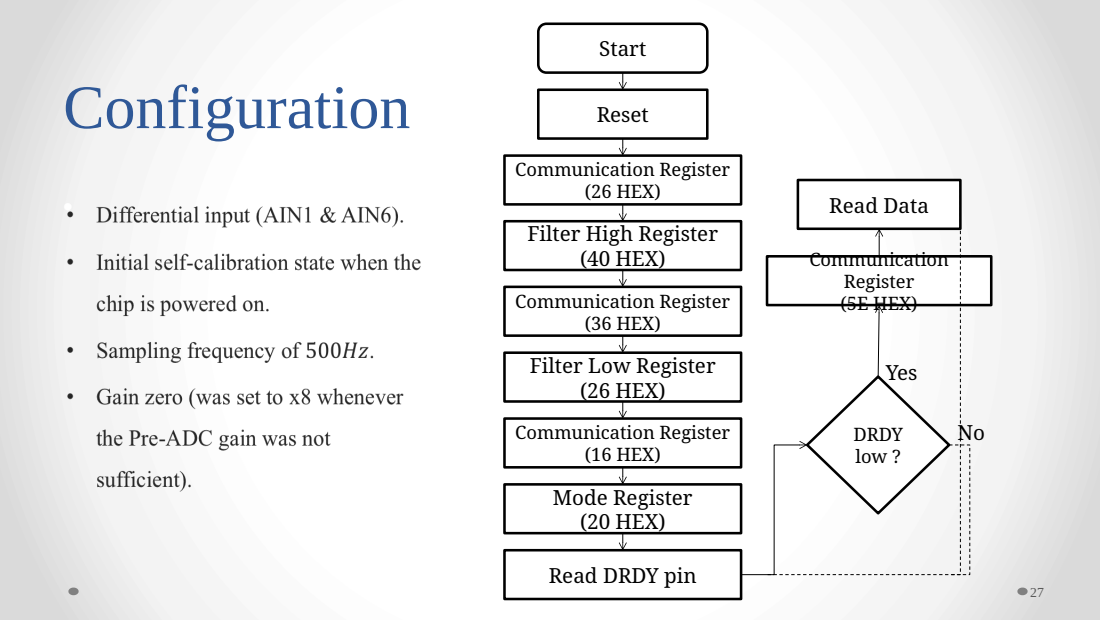
[picture p142: page 27]
Start; Reset; Communication Register (26 HEX); Communication Register (36 HEX); Communication Register (16 HEX); Mode Register (20 HEX); DRDY low ?; Communication Register (5E HEX); Yes; Read Data

Filter High Register
(40 HEX)

Filter Low Register
(26 HEX)

Read DRDY pin

# Wireless Communication

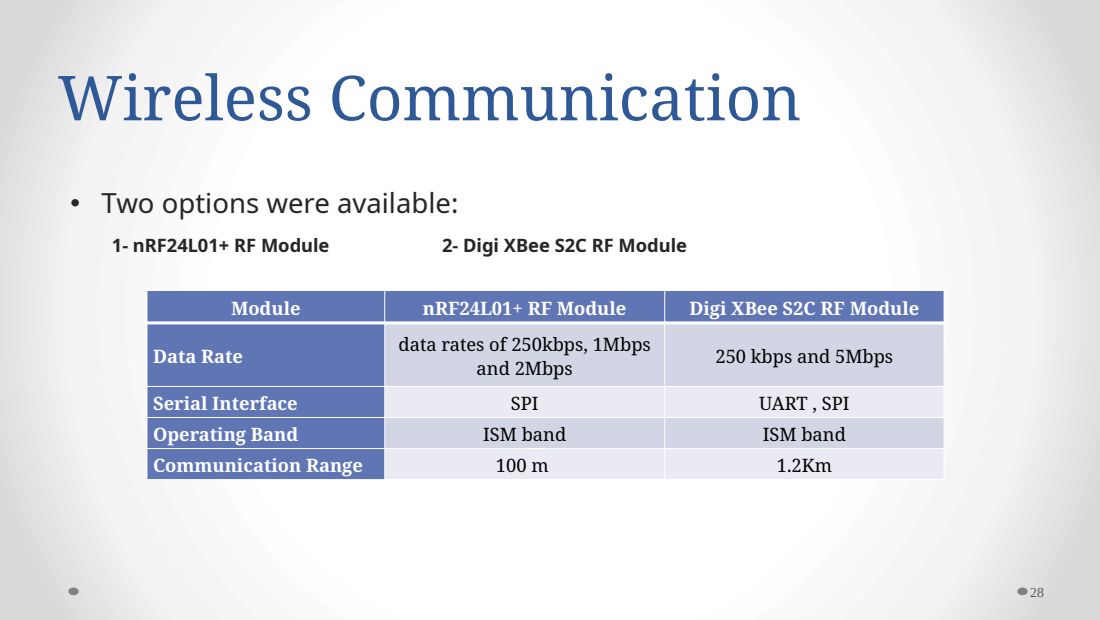
[picture p143: page 28]
1- nRF24L01+ RF Module; 2- Digi XBee S2C RF Module

• Two options were available:

Module | nRF24L01+ RF Module | Digi XBee S2C RF Module

Data Rate | data rates of 250kbps, 1Mbps and 2Mbps | 250 kbps and 5Mbps

Serial Interface | SPI | UART , SPI
Operating Band | ISM band | ISM band
Communication Range | 100 m | 1.2Km

# Wireless Communication

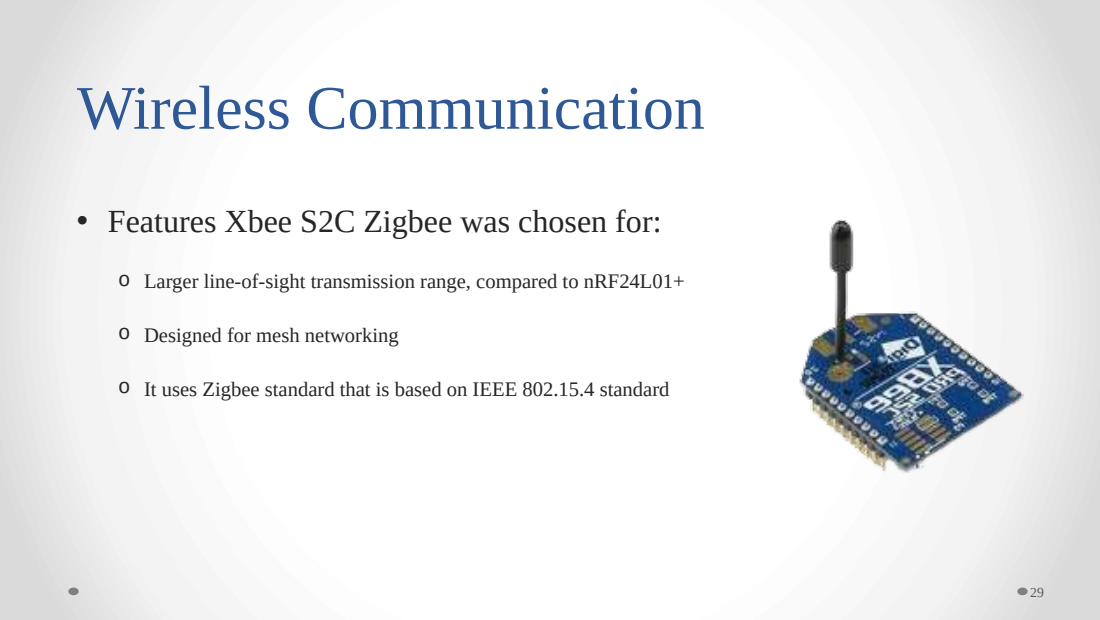
[picture p144: page 29]

• Features Xbee S2C Zigbee was chosen for:

o Larger line-of-sight transmission range, compared to nRF24L01+

o Designed for mesh networking

o It uses Zigbee standard that is based on IEEE 802.15.4 standard

# Wireless Communication

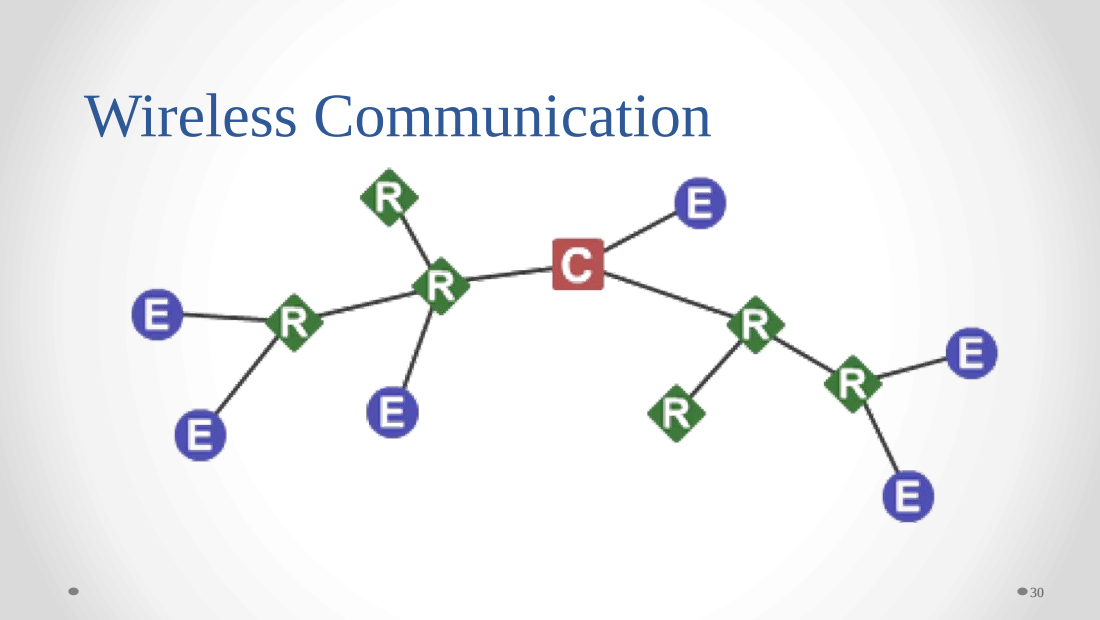
[picture p145: page 30]

# Wireless Communication

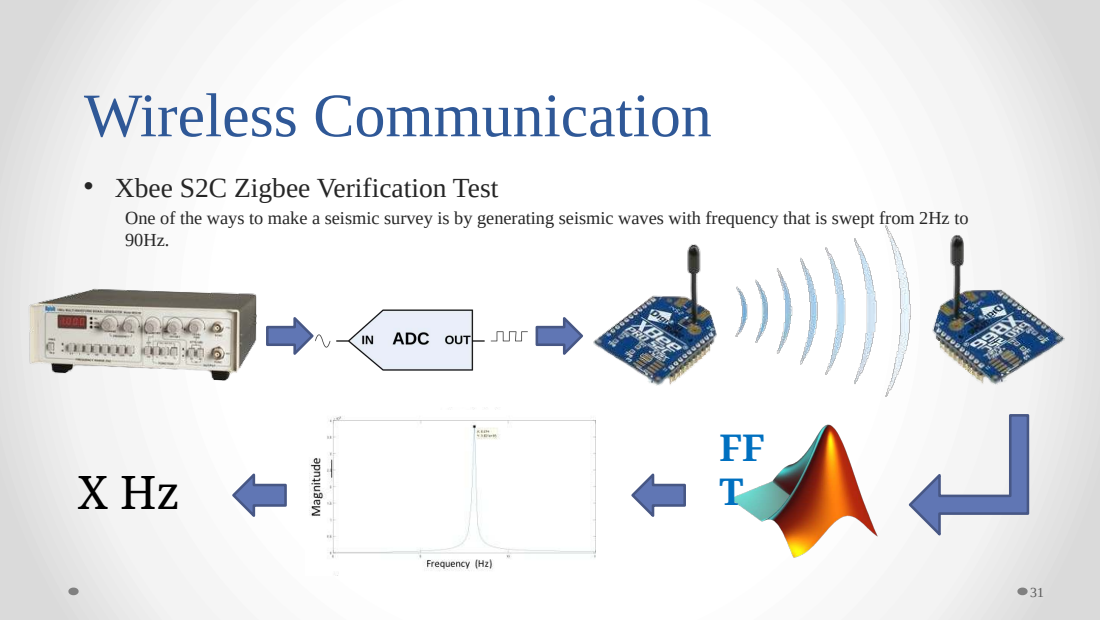
[picture p146: page 31]

• Xbee S2C Zigbee Verification Test

One of the ways to make a seismic survey is by generating seismic waves with frequency that is swept from 2Hz to

# Wireless Communication

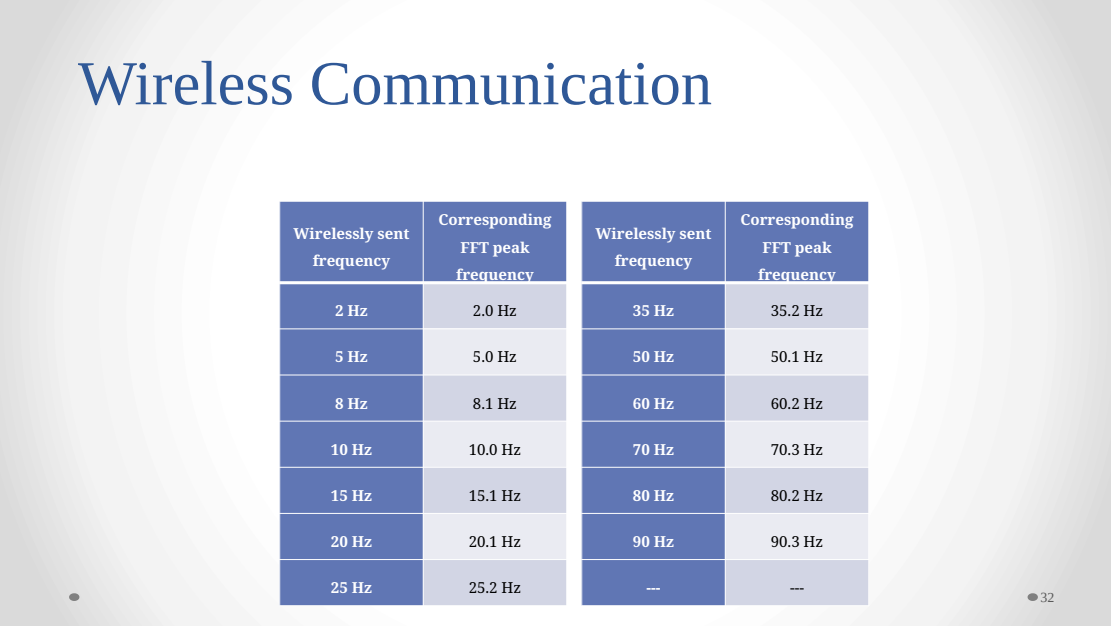
[picture p147: page 32]
Wirelessly sent; frequency; Corresponding; FFT peak

# Signal Processing Unit

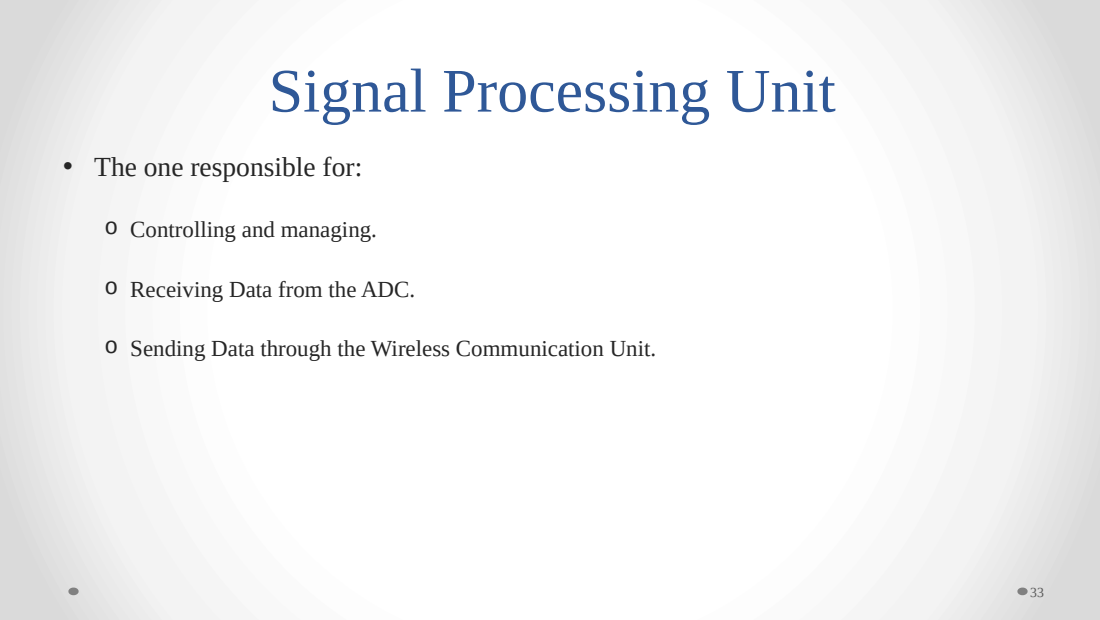
[picture p148: page 33]

• The one responsible for:

o Controlling and managing.

o Receiving Data from the ADC.

o Sending Data through the Wireless Communication Unit.

# Signal Processing Unit

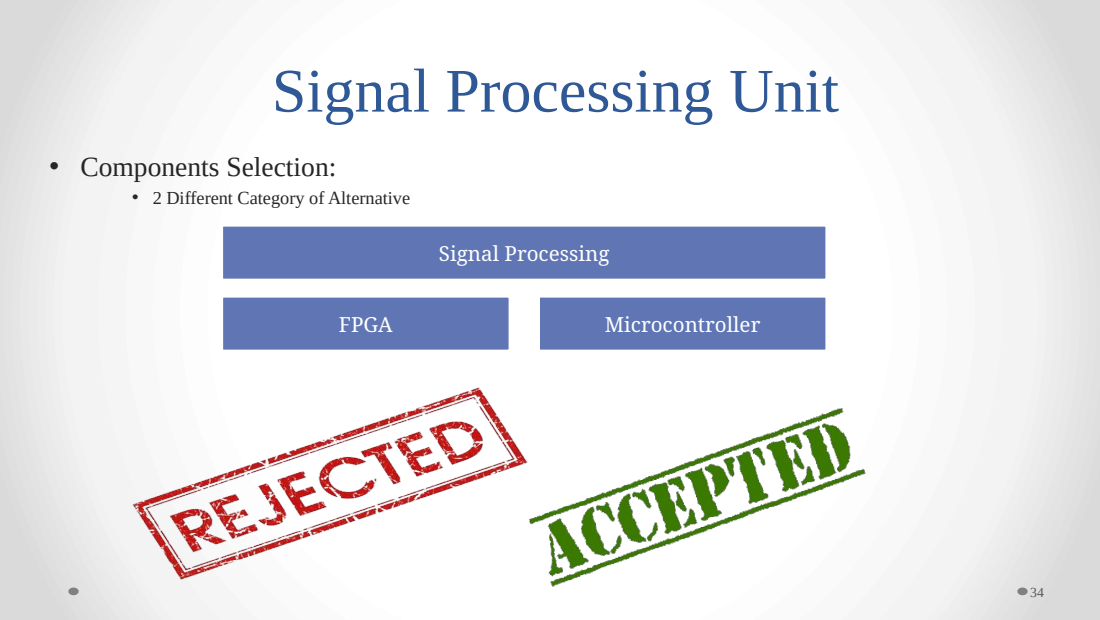
[picture p149: page 34]
• Components Selection:; Signal Processing; FPGA; Microcontroller

• 2 Different Category of Alternative

# Controlling Unit

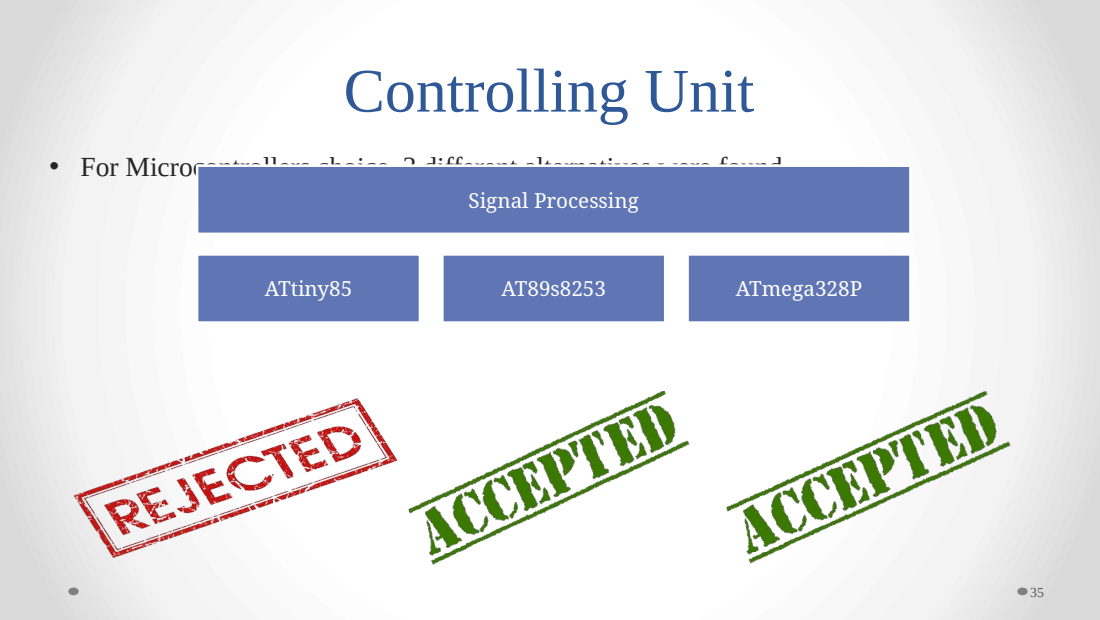
[picture p150: page 35]
Signal Processing; ATtiny85; ATmega328P

• For Microcontrollers choice, 3 different alternatives were found.

# Overall Verification

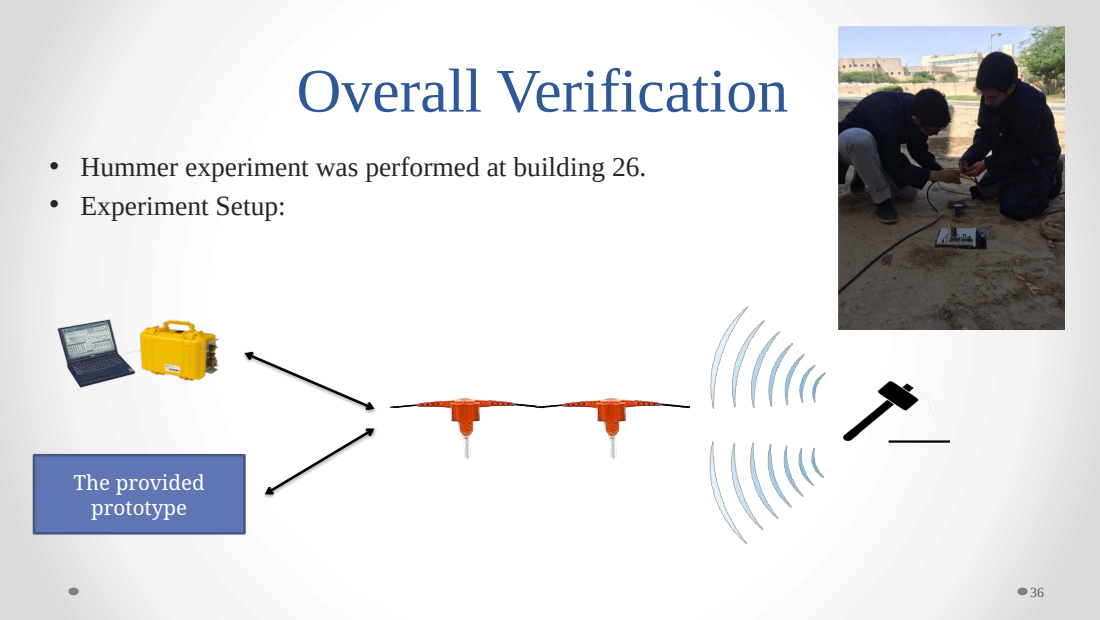
[picture p151: page 36]
The provided prototype

• Hummer experiment was performed at building 26.
• Experiment Setup:

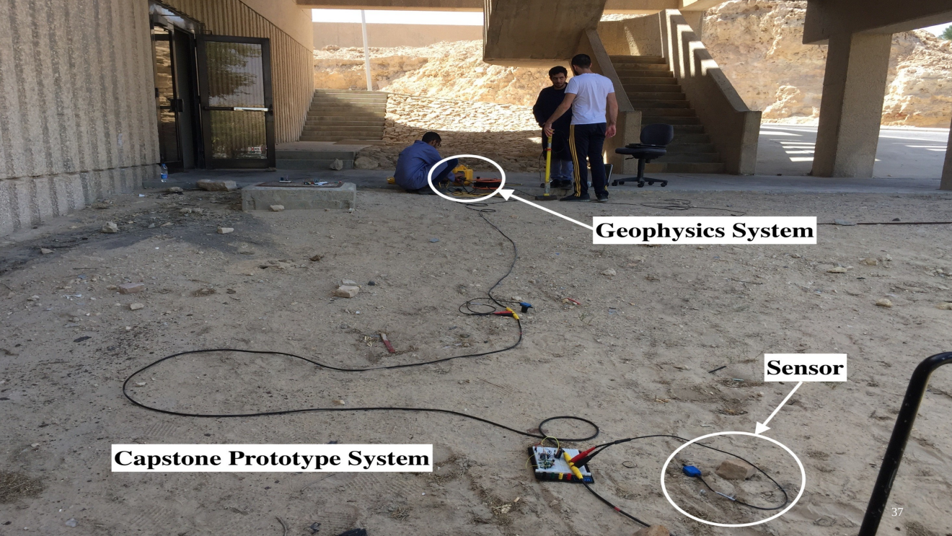
[picture p152: page 37]

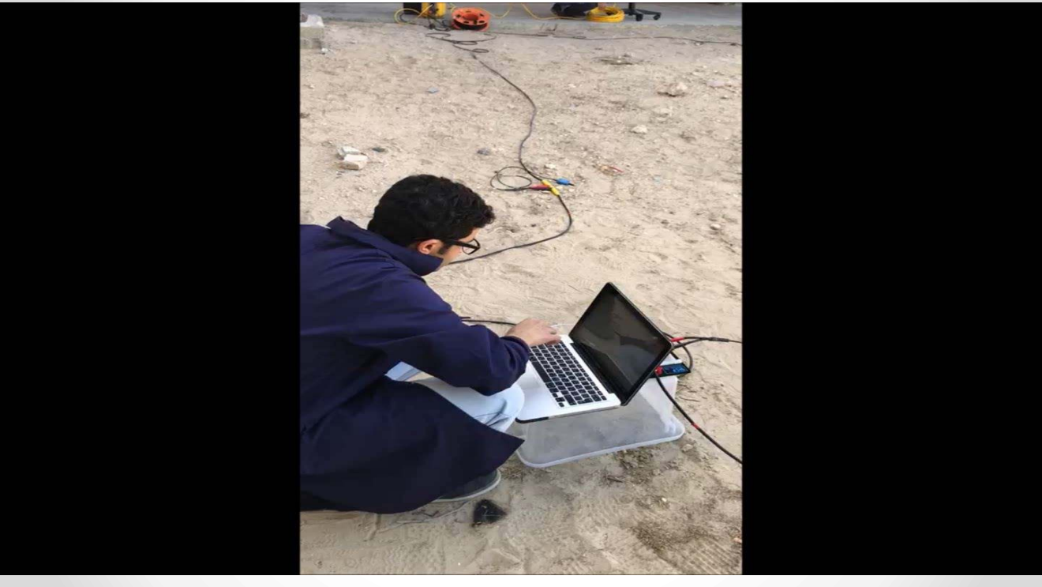
[picture p153: page 38]

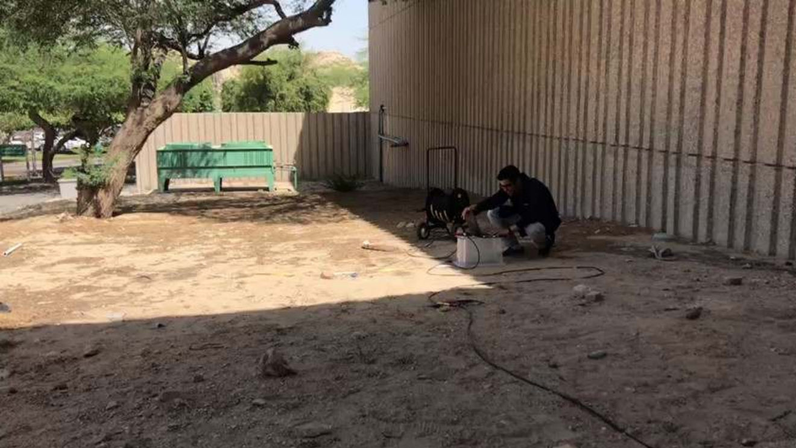
[picture p154: page 39]

# Overall Verification

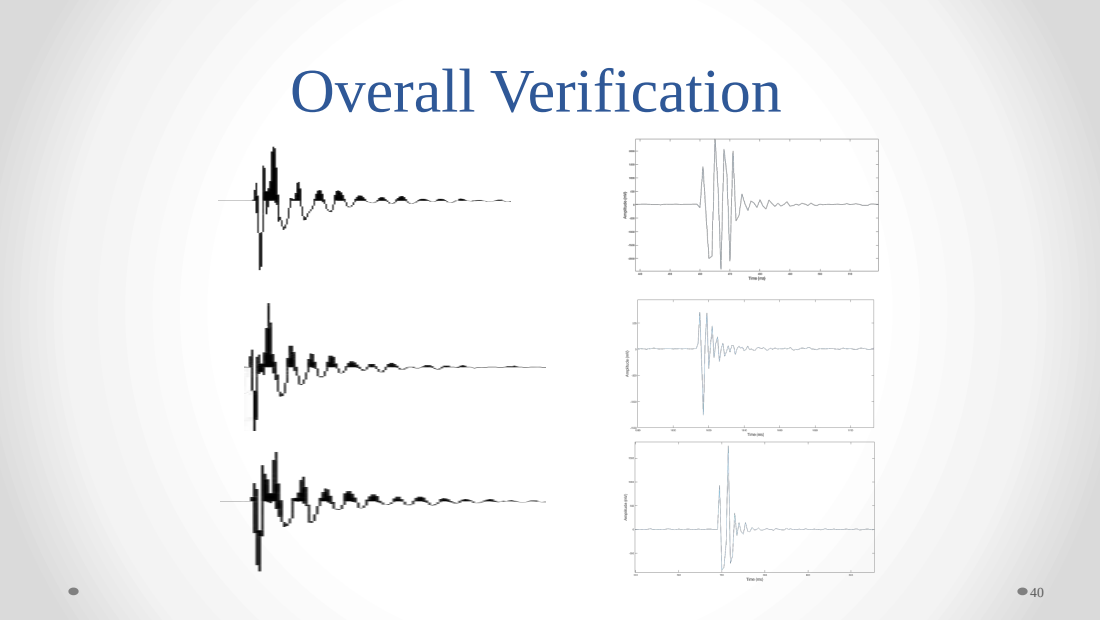
[picture p155: page 40]

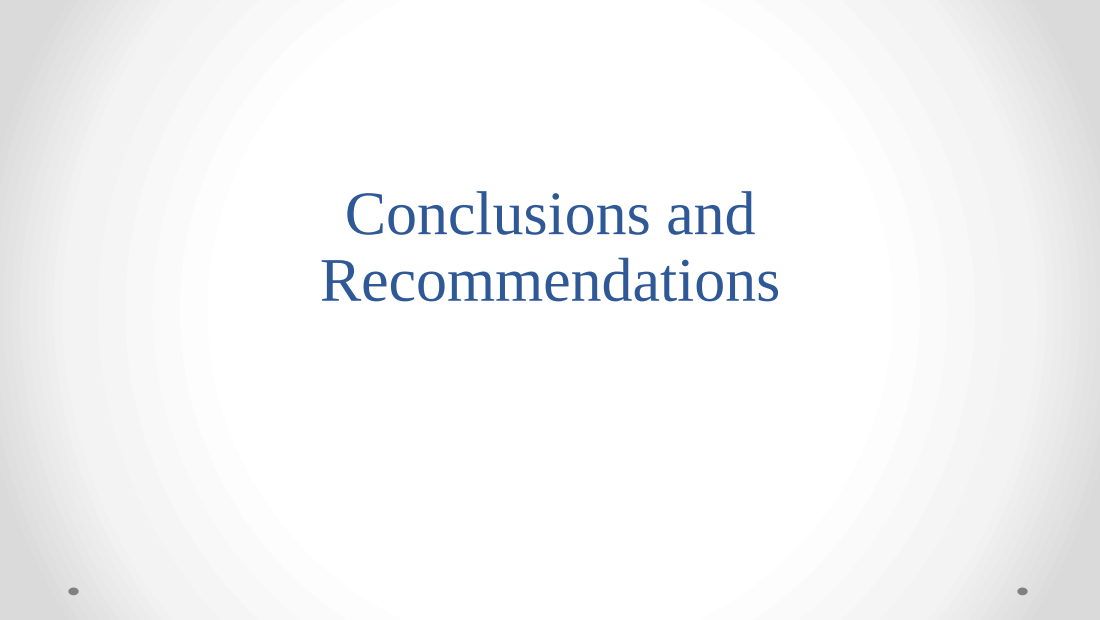
[picture p156: page 41]
Conclusions and Recommendations

# Concluding remarks

- Gained understanding of data acquisition systems in general.
- Sensors were investigated based on their frequency response.
- Delta Sigma ADC (24-bits) was programmed and configured properly.
- Successful Wireless communication between two nodes up to 50m.
- Final working prototype was soldered and can be easily used.

# Recommendations

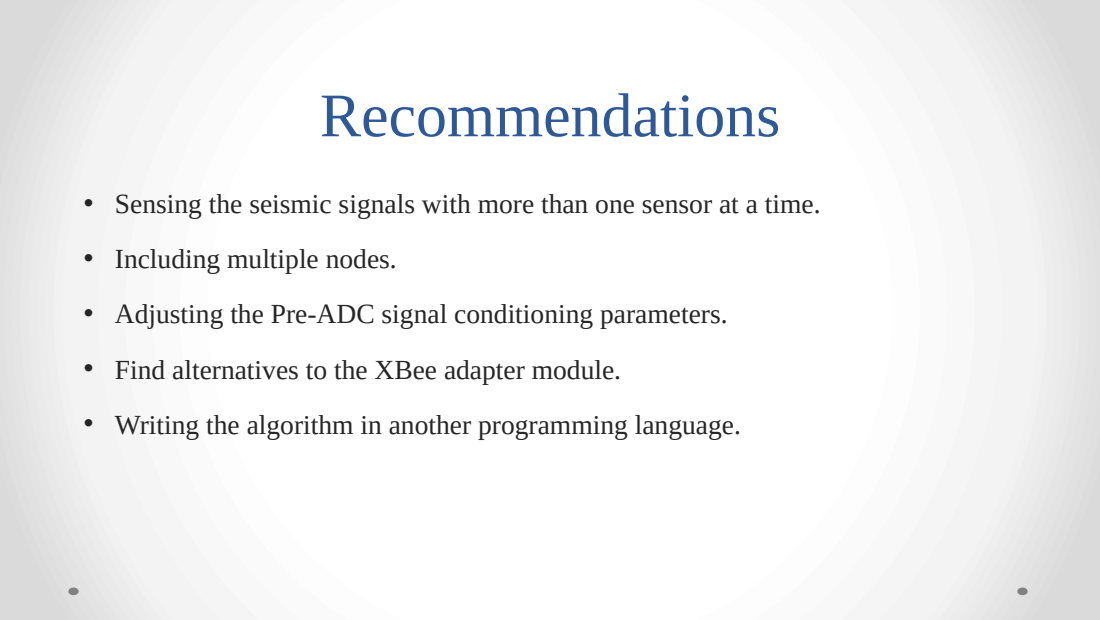
[picture p157: page 43]

• Sensing the seismic signals with more than one sensor at a time.

• Including multiple nodes.

• Adjusting the Pre-ADC signal conditioning parameters.

• Find alternatives to the XBee adapter module.

• Writing the algorithm in another programming language.

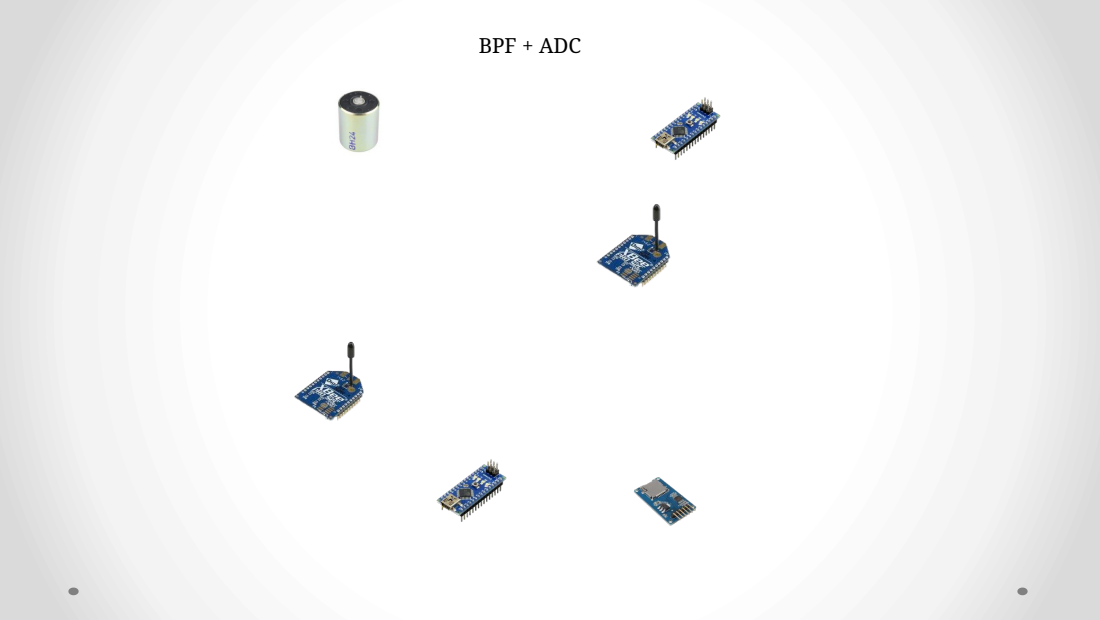
[picture p158: page 44]
BPF + ADC
