al-nafisah/wireless-seismic-daq/(list of files, drawings)

Other design files:
hardware/pcb/layout.dip
hardware/pcb/schematic.dch
hardware/signal-conditioning/schematic.dch
