al-nafisah/wireless-seismic-daq/(commit log)

2018-02-10 Add AD574 ADC test
    [levels.csv]
2018-02-15 Add geophone and piezo recordings
    [geophone-vs-piezo.csv]
2018-03-13 Add sensor models
2018-03-15 Add filter simulation
2018-04-11 Add prototype photo
2018-04-14 Add sensor impulse responses
2018-04-19 Add hammer-shot recordings
    [shots.csv]
2018-04-21 Add PCB design
    [layout.dip, schematic.dch]
2018-04-22 Add signal conditioning schematic and component values
    [components.csv, gain-options.csv, schematic.dch]
